Soft-Services/Leonhart/README.md

# Leonhart
## Overview
Leonhart is a custom embedded Linux board based on the Texas Instruments AM6231 SoC.

The board is a smart-home gateway capable of running Linux and hosting Thread and Zigbee networks simultaneously using the Silicon Labs MGM240P radio module. The goal is to provide support for Matter-over-Thread devices while also bridging Zigbee devices into modern Matter-based ecosystems such as Google Home, Amazon Alexa, and Apple Home.

## Why This Matters
Many existing smart homes rely on Zigbee devices, while newer smart-home ecosystems are increasingly moving towards Matter and Thread. Replacing Zigbee devices to keep up with Matter-based ecosystems is wasteful, expensive and unnecessary.

Leonhart was created to support both worlds at once. Hosting a Thread network for newer Matter-over-Thread devices, while also hosting a Zigbee network and allowing for communication with legacy Zigbee devices. The long-term goal is to bridge Zigbee devices into Matter-based ecosystems, allowing older devices to remain useful alongside newer smart-home standards.

## Project Goals

The main goals of Leonhart are:
- Build a fully functional custom embedded Linux system
- Run Zigbee+Thread RCP firmware on MGM240P
- Thread Border Router functionality
- Zigbee network stack to communicate with radio
- Support multi protocol through Silicon Labs CPC
- Create a compact, local and open Linux-based alternative to separate Zigbee hubs and Thread border routers

## Current Status

Rev B is currently functional. Working features include:
- Linux boot from eMMC
- Ethernet and SSH
- USB-C powered boot
- Multiprotocol firmware flashed to MGM240P
- UART communication between Linux host and MGM240P with hardware flow control
- Silicon Labs CPC daemon communication
- OpenThread Border Router operation
- Thread and Zigbee network formation
- Automatic startup of Zigbee, OTBR and CPC services
- Matter-over-Thread device control using chip-tool
- Zigbee device control through Matter chip-tool commands using a simple FIFO-based Matter bridge

### Current Demo

Leonhart currently demonstrates Matter-over-Thread control and early Zigbee-to-Matter bridge functionality using the onboard MGM240P radio.

<br>

<p align="center">
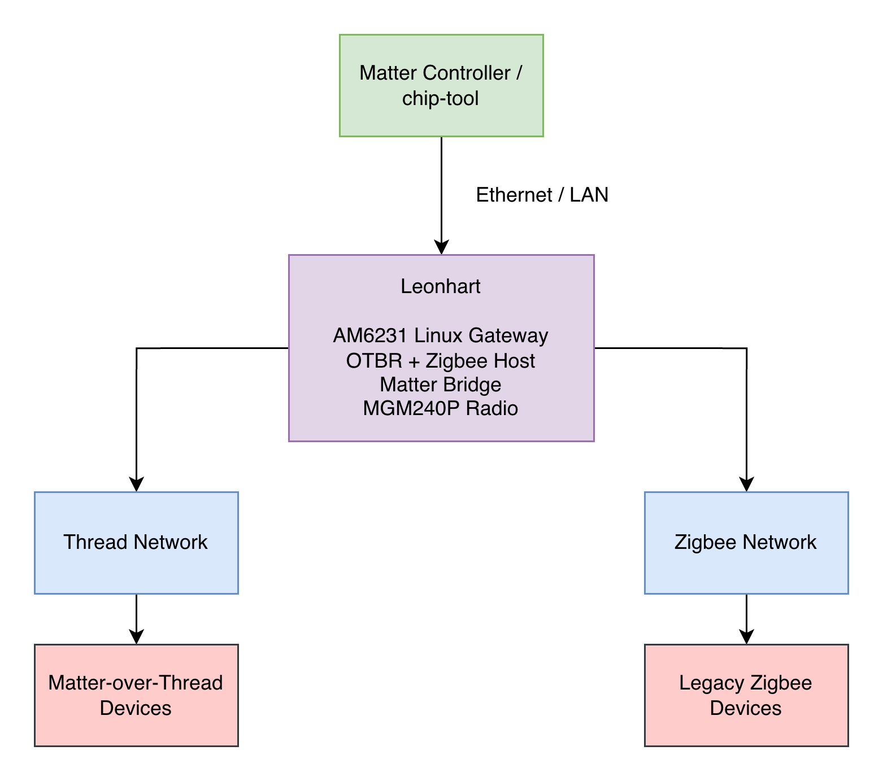
[picture p1: images/leonhartdemodrawing.drawio.png]
  
</p>

## Hardware Architecture

### Key Features
- TI AM6231 SoC
- 2 GB DDR4
- SiLabs MGM240P RF module
- 16 GB eMMC storage (HS200)
- Ethernet (RGMII PHY)
- 32kbit EEPROM
- USB-A host port
- USB-C power input
- SoC JTAG/MGM240P SWD TagConnect debug interfaces
- SPI and UART header pins for extra peripherals

### Hardware Block Diagram

<br>

<p align="center">
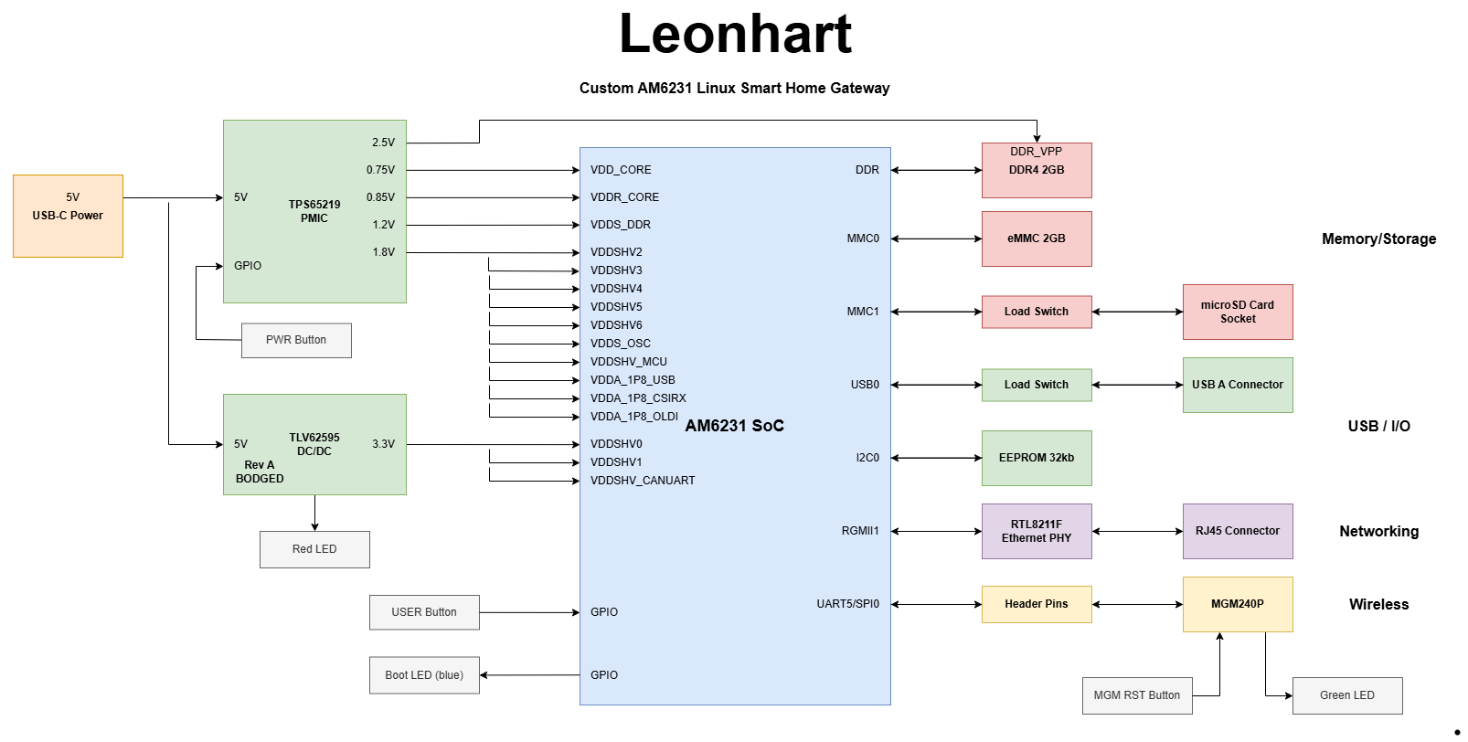
[picture p2: images/hardwareblockdiagram.drawio.png]
  
</p>

## Hardware Revisions

### Rev A
<p align="centre">
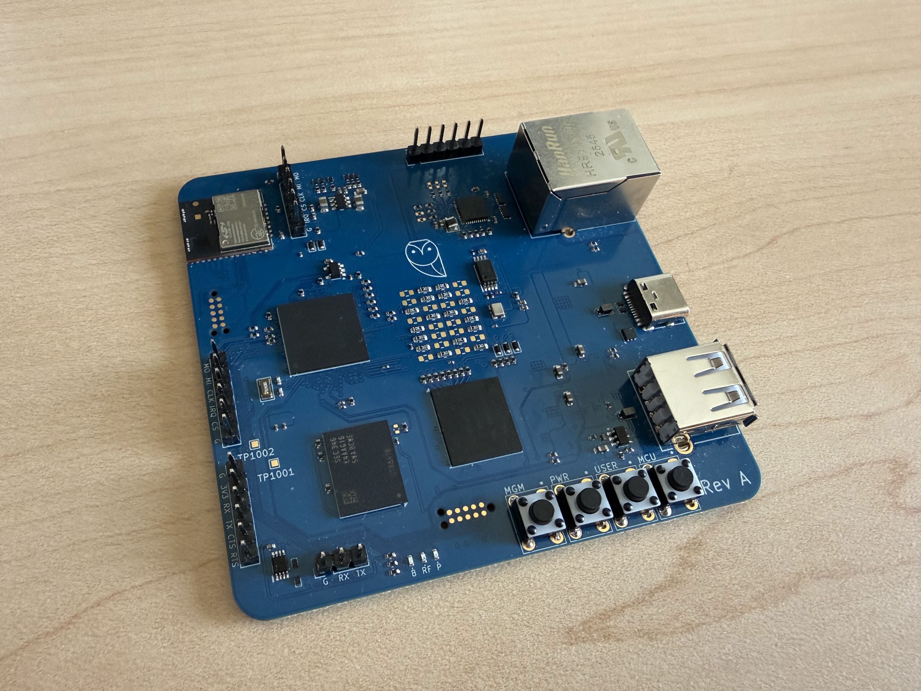
[picture p3: images/3d_top.jpg]
  
</p>

Rev A was the initial bring-up revision. It successfully validated the core AM6231 Linux system, including PMIC rail sequencing, U-Boot over UART, DDR4 initialization, eMMC HS200 operation, EEPROM communication, USB-A, clocks, and Linux boot.

Main issues found in Rev A:
- Incorrect 5 V to 3.3 V buck converter footprint, requiring external 3.3 V injection
- USB-C power issue caused by the bodged power setup
- Ethernet PHY not operational
- Linux boot on power-up affected by bodged power sequencing
- Incorrect MGM240P UART and SWD pinout

### Rev B
<p align="centre">
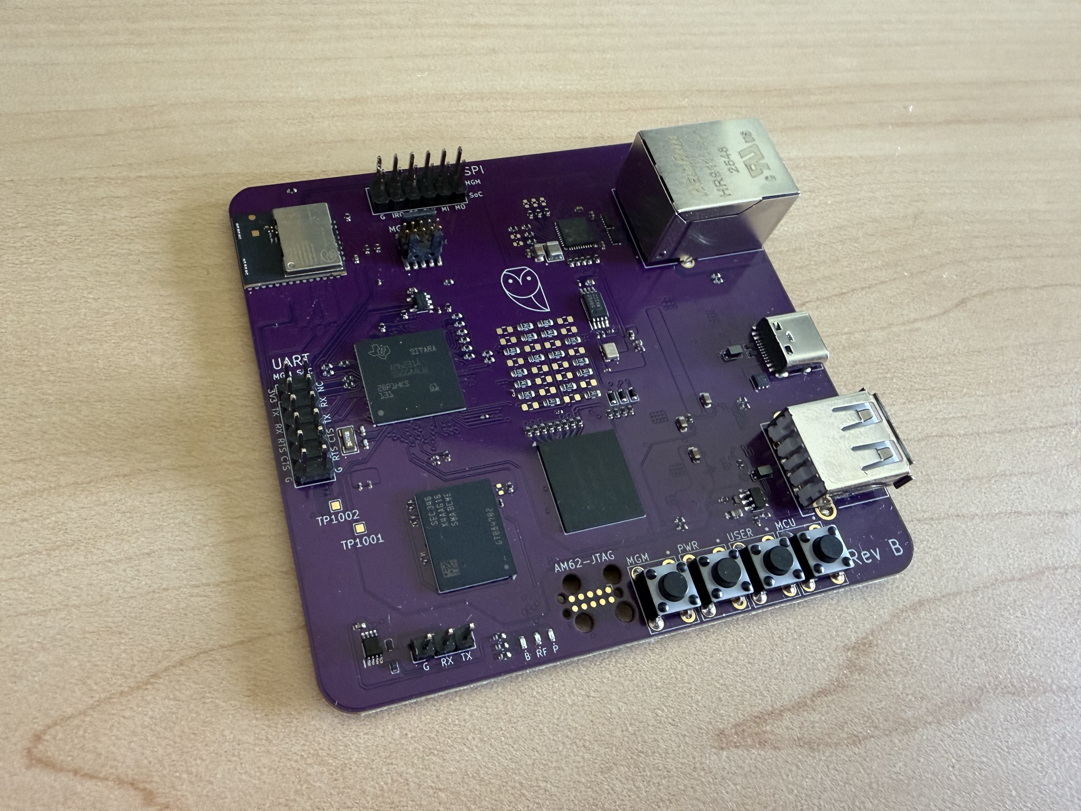
[picture p4: images/revb3d_top.jpg]
  
</p>

Rev B fixed the major hardware issues from Rev A and is the current functional revision.

Main fixes and validated features in Rev B:
- MGM240P pinout now correct and can be flashed to via Silicon Labs J-Link debugger
- Ethernet and SSH are now operational
- Correct 5V -> 3.3V buck converter footprint
- USB-C power works without bodged power supply
- Linux boots from power up
- UART communication with hardware flow control works between the AM6231 and MGM240P

## Bring-Up Notes

Progress Update #1 

During initial bring-up, a bench PSU was used and a large current draw was observed, which was then found out to be an issue with the 5V -> 3.3V buck converter footprint.

A temporary workaround involved:
- Injecting 3.3V from wall adapter into 3.3V header pin
- Using a USB-C breakout board to power the PMIC and remaining rails via a bench PSU

This allowed for successful validation of:
- SoC boot
- DDR initialization
- eMMC communication

Linux boot strategy: USB-A -> DDR -> eMMC -> DDR -> boot

Progress Update #2
- Successfully booted Linux (Arago distribution)
- Rootfs and U-Boot files copied to eMMC
- Successfully able to boot from eMMC

Progress Update #3
- Modified prebuilt ti-am625-sk.dts file with only UART pinmux (UART5) for my custom board, and build .dtb file from that, then copied it to eMMC
- Tested UART5 communication with Sparkfun Things Matter MGM240P and saw output on SOC UART terminal

Progress Update #4
- Had issue with USB C power showing incorrect voltage for 5V rail (2.2V), so I used the bench power supply for dummy power. I have found that the bodged 3.3V injection setup causes the 2.2V at the USB C VBUS pins, which prevents USB C from sending power. Without the bodged setup (correct 5V->3.3V buck converter footprint) in the next revision, USB C power should work as intended
- Created new Rev B branch and started revisions

Progress Update #5 (Rev B)
- Confirmed gigabit Ethernet works and SSH works
- Linux able to boot from power up
- Confirmed onboard MGM240P communication and flashing works
- Confirmed UART hardware flow with MGM240P works
- Need to fix NCP and RCP firmware communication with CPC daemon

Progress Update #6 (Rev B)
- Successfully flashed Multiprotocol RCP/NCP (Thread and Zigbee) stack to MGM240P and had successful communication with host CPCD
- Successfully proved full Thread network chain (RCP(MGM) <-> (CPCD <-> OTBR)(AM6231)). Needed to rebuild TI Arago Linux image with multicast routing enabled

Progress Update #7 (Rev B)
- Made all Zigbee (zigbeed, zigbee-pty-bridge, Z3Gateway), Thread (OTBR, otbr-agent) and CPCD run on reboot, and successfully confirmed services correctly restart and devices reconnect
- Successfully proved Matter-over-Thread control with ESP32C6 running a Matter light example

The ESP32 commissions onto the Thread network through Leonhart, then registers its Matter operational service through SRP, then can be controlled from chip-tool over the LAN

Next steps
- Order more Zigbee and Matter-over-Thread and stress test the multiprotocol networking
- Begin to start/look into Zigbee -> Matter bridging

The following screenshots shows a script that displays the status' of the Zigbee and Thread networks and services:

<p align="centre">
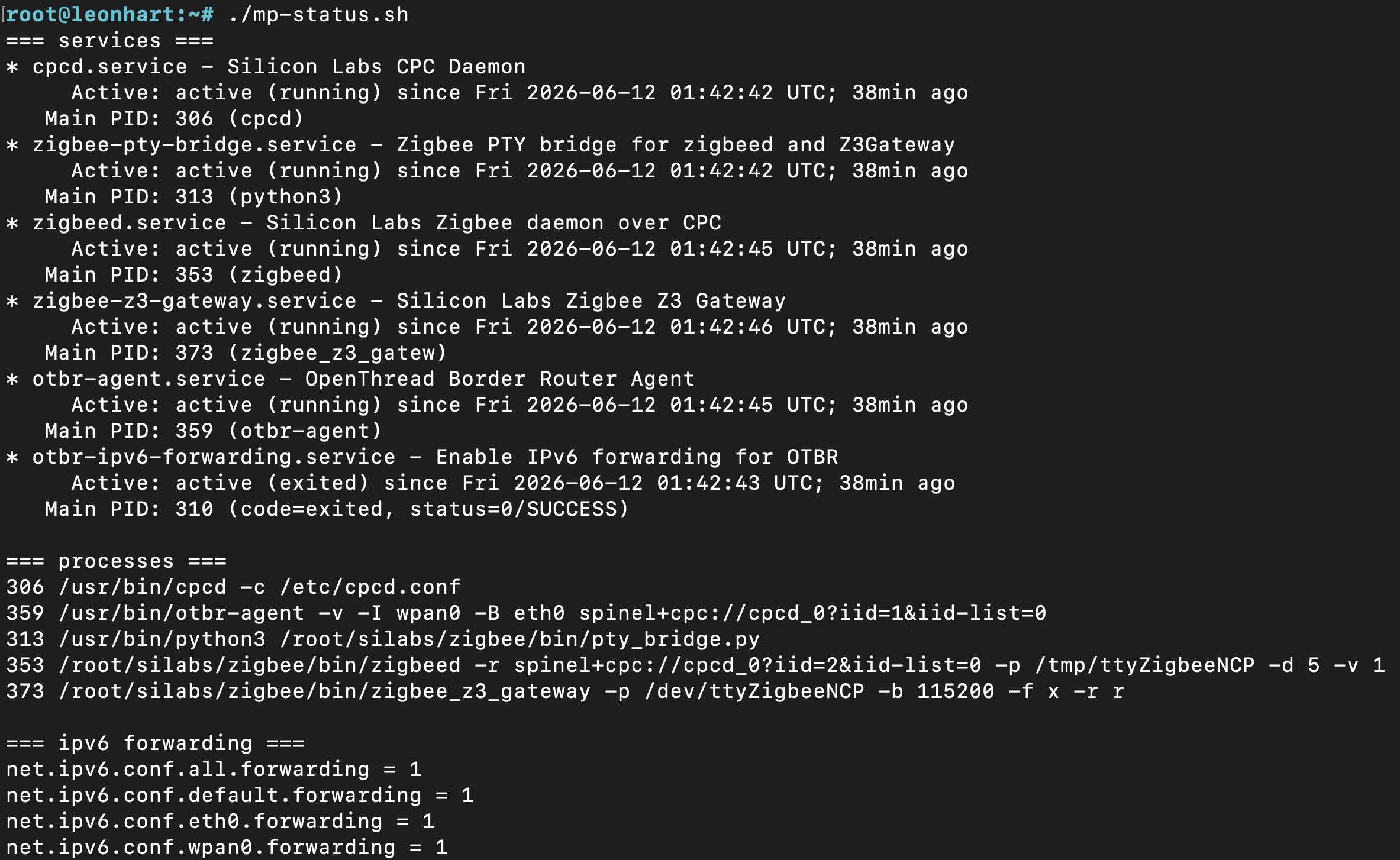
[picture p5: images/mp-statusA.png]
  
</p>
<p align="centre">
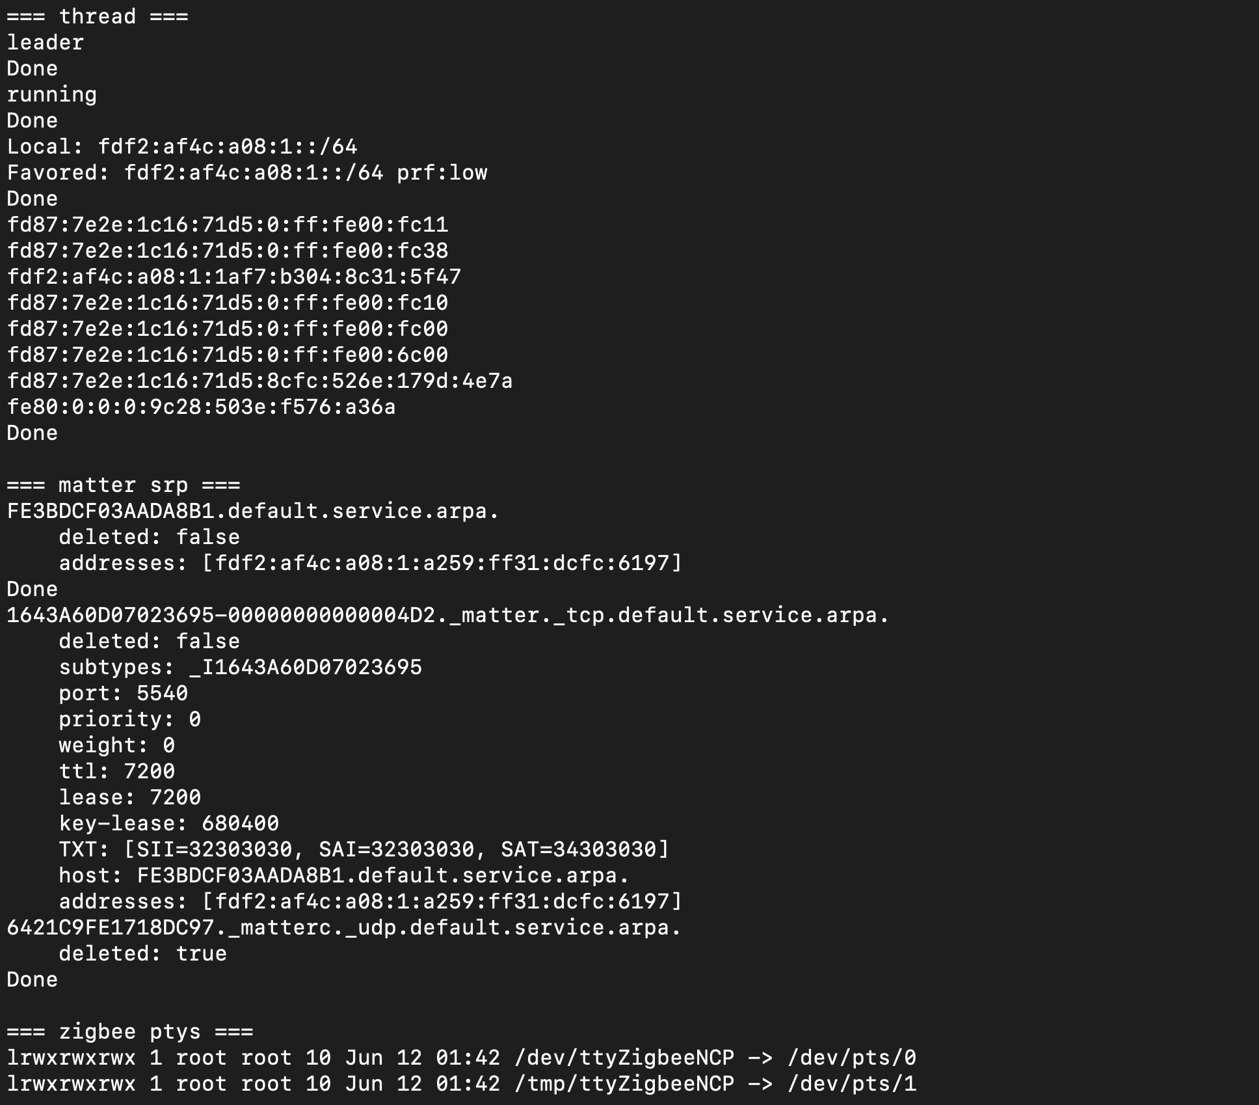
[picture p6: images/mp-statusB.png]
  
</p>

## Hardware Photos
<p align="centre">
  
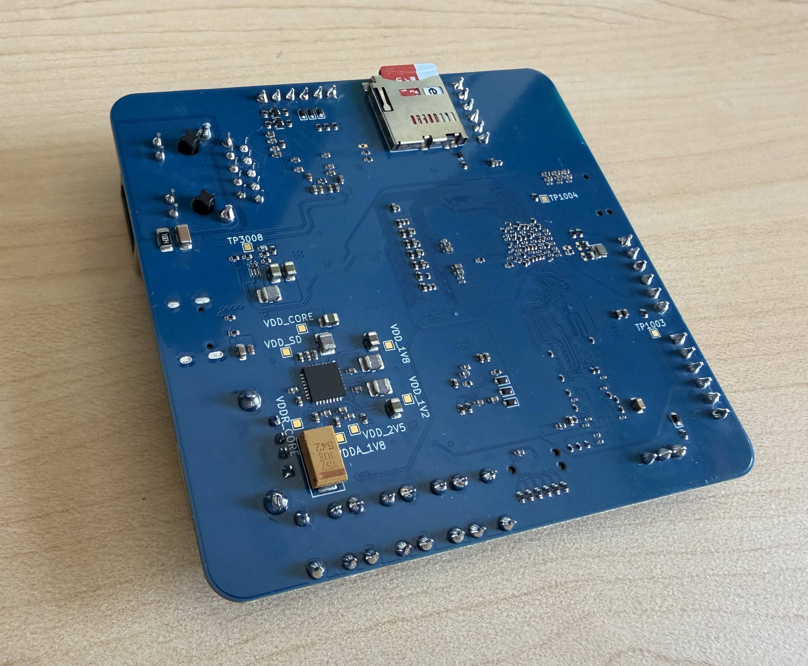
[picture p7: images/3d_bottom.jpg]
  
</p>
<p align="centre">
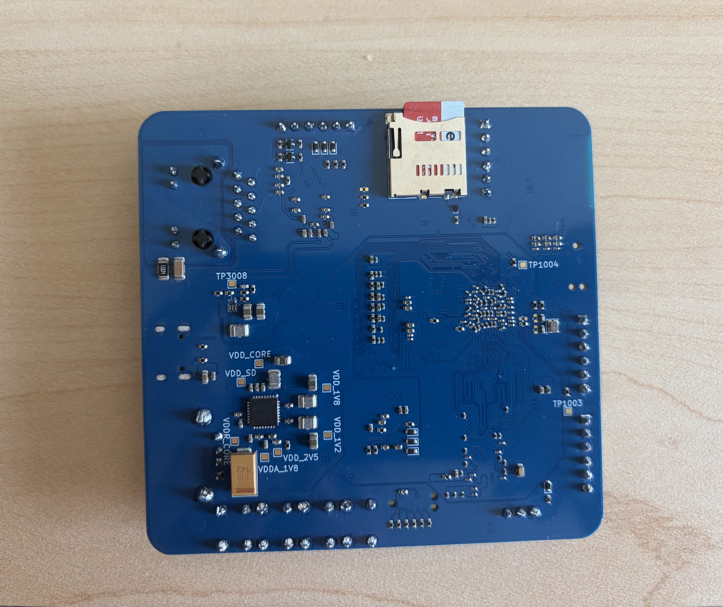
[picture p8: images/bottom.jpg]
  
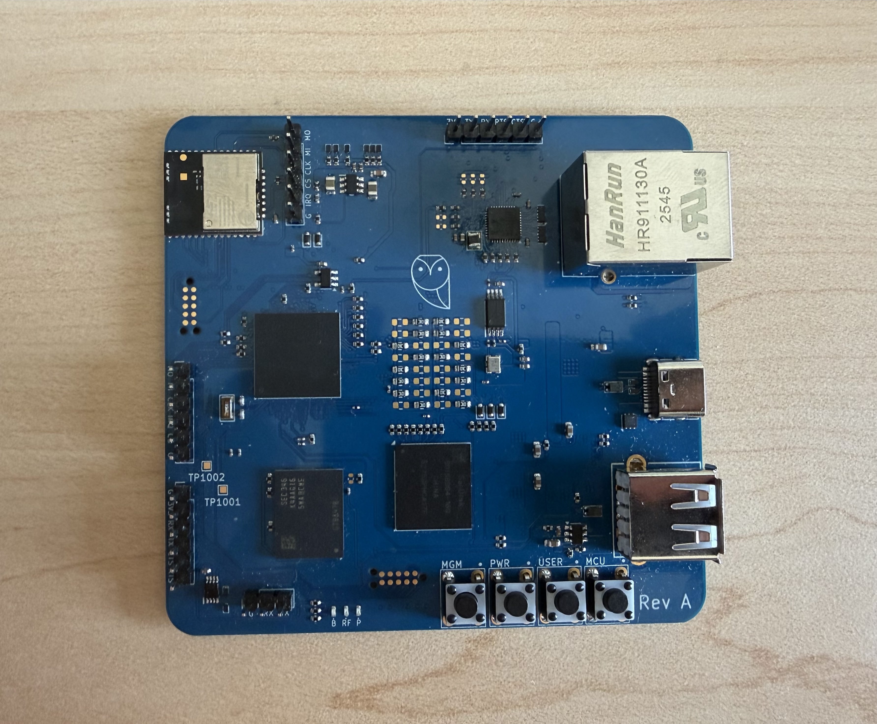
[picture p9: images/top.jpg]
  
</p>
