Soft-Services/Leonhart/images/RevALinuxProgress1.png

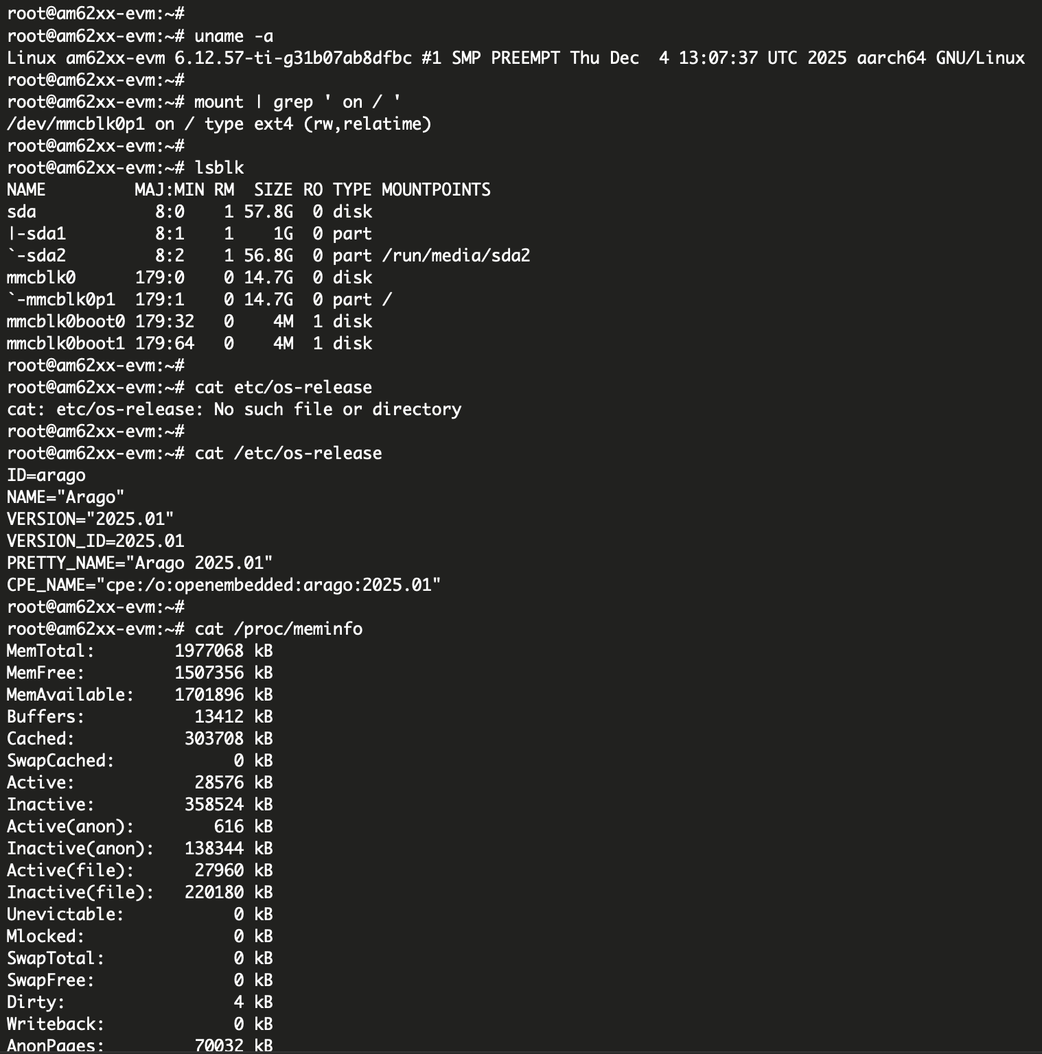
images/RevALinuxProgress1.png
