Soft-Services/Leonhart/Components/CMUSB661022B/CMUSB661022B.jpg

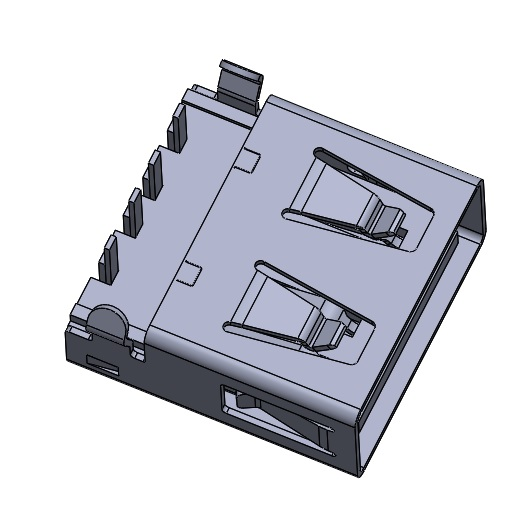
Components/CMUSB661022B/CMUSB661022B.jpg
