Soft-Services/Leonhart/Components/CMUSB661022B/CMUSB661022B.stp

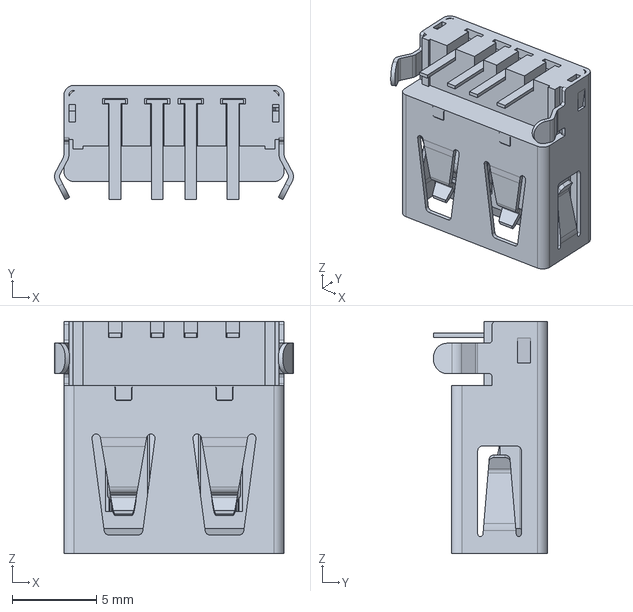
[picture p12: CAD file, 2025-09-30]
Components/CMUSB661022B/CMUSB661022B.stp
14.2 x 6.80 x 13.8 mm
