Soft-Services/Leonhart/Components/Download_STP_63011002124501 (rev1).stp

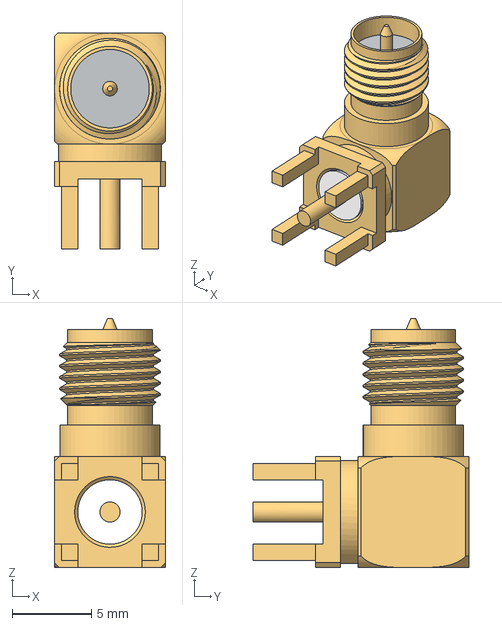
[picture p13: CAD file, 2025-08-28]
Components/Download_STP_63011002124501 (rev1).stp
7.00 x 13.6 x 15.7 mm
