Soft-Services/Leonhart/Components/K4AAG165WA-BCWE/3D/K4AAG165WA-BCWE.stp

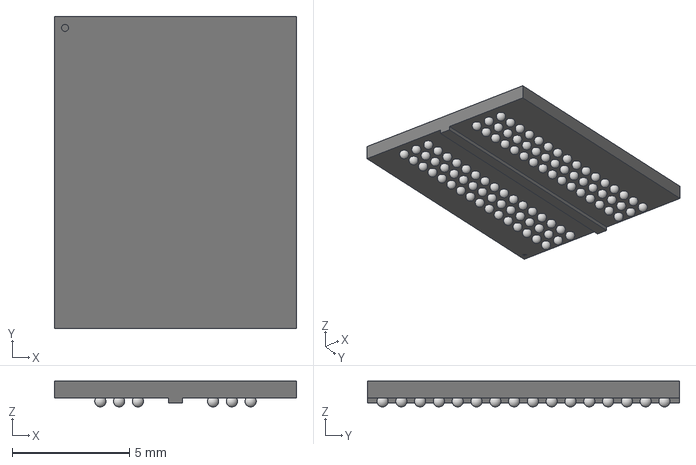
[picture p14: CAD file, 2025-08-04]
Components/K4AAG165WA-BCWE/3D/K4AAG165WA-BCWE.stp
10.3 x 13.3 x 1.10 mm
