Soft-Services/Leonhart/Components/LIB_902-131A1011D10100/902-131A1011D10100/3D/902-131A1011D10100.stp

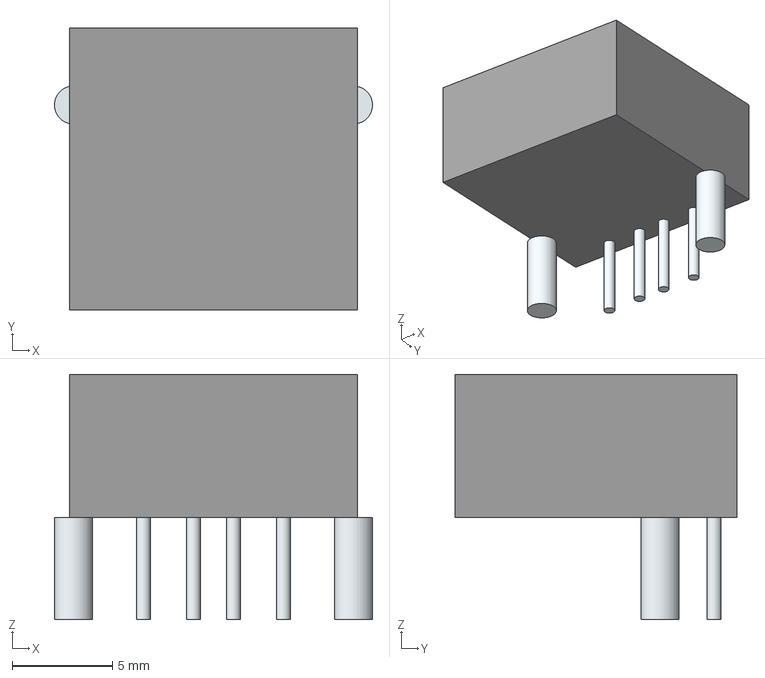
[picture p15: CAD file, 2025-09-30]
Components/LIB_902-131A1011D10100/902-131A1011D10100/3D/902-131A1011D10100.stp
15.9 x 14.1 x 12.2 mm
Leads
