Soft-Services/Leonhart/Components/LIB_ABS07-32.768KHZ-9-T/ABS07-32.768KHZ-9-T/3D/ABS07-32.768KHZ-9-T.stp

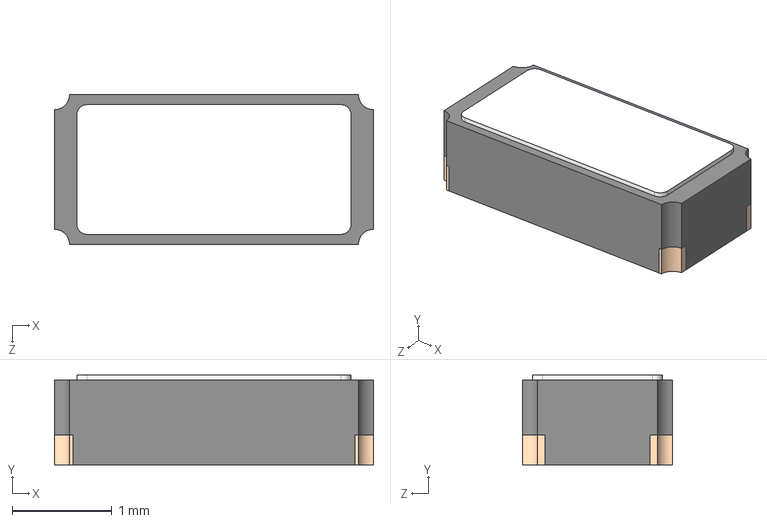
[picture p16: CAD file, 2025-08-28]
Components/LIB_ABS07-32.768KHZ-9-T/ABS07-32.768KHZ-9-T/3D/ABS07-32.768KHZ-9-T.stp
3.20 x 0.9 x 1.50 mm
