Soft-Services/Leonhart/Components/LIB_AM6231ASGGGAALW/AM6231ASGGGAALW/3D/AM6231ASGGGAALW.stp

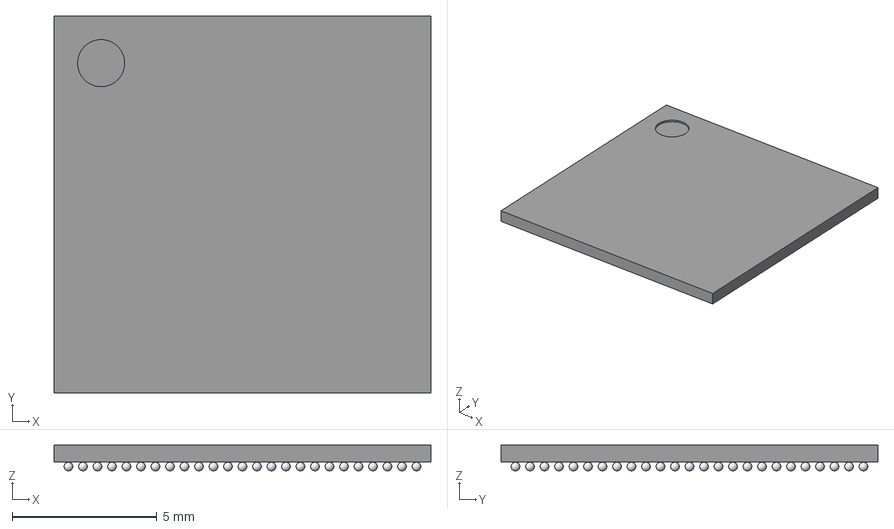
[picture p17: CAD file, 2025-08-04]
Components/LIB_AM6231ASGGGAALW/AM6231ASGGGAALW/3D/AM6231ASGGGAALW.stp
13.0 x 13.0 x 0.89 mm
A1
A2
A3
A4
A5
A6
A7
A8
A9
A10
A11
A12
A13
A14
A15
A16
A17
A18
A19
A20
A21
A22
A23
A24
A25
B1
B2
B3
B4
B5
B6
B7
B8
B9
B10
B11
B12
B13
B14
B15
B16
B17
B18
B19
B20
B21
B22
B23
B24
B25
C1
C2
C5
C6
C9
C11
C13
C15
C17
C20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
