Soft-Services/Leonhart/Components/LIB_CC2652P1FRGZR/CC2652P1FRGZR/3D/CC2652P1FRGZR.stp

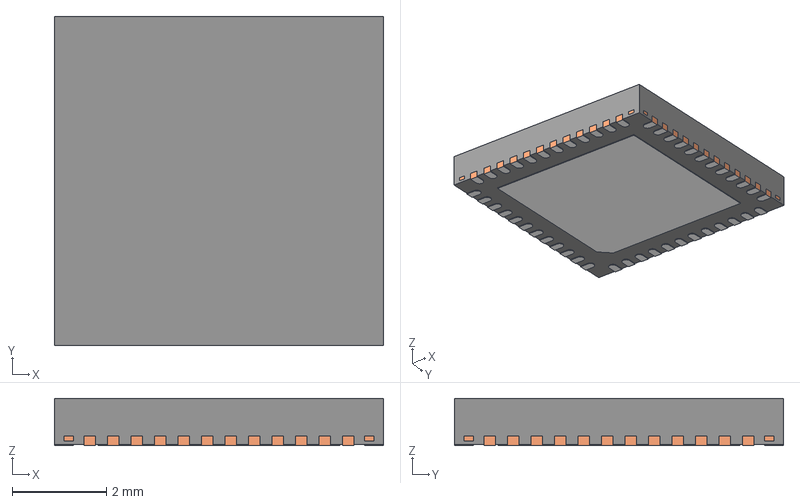
[picture p18: CAD file, 2025-08-04]
Components/LIB_CC2652P1FRGZR/CC2652P1FRGZR/3D/CC2652P1FRGZR.stp
7.00 x 7.00 x 1.00 mm
BODY-QFN
FRAME-RGZ0048A
PIN1-ID
