Soft-Services/Leonhart/Components/LIB_DMG1012T/DMG1012T/3D/DMG1012T.stp

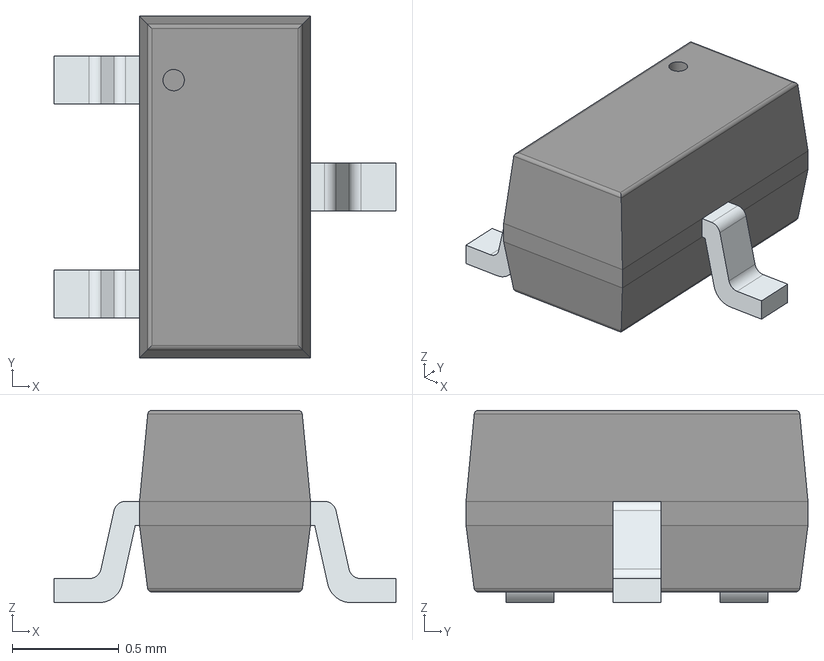
[picture p19: CAD file, 2025-08-27]
Components/LIB_DMG1012T/DMG1012T/3D/DMG1012T.stp
1.60 x 1.60 x 0.9 mm
PinsArrayL
FilletPinR
