Soft-Services/Leonhart/Components/LIB_ECS-2520MV-250-BN-TR/ECS-2520MV-250-BN-TR/3D/ECS-2520MV-250-BN-TR.stp

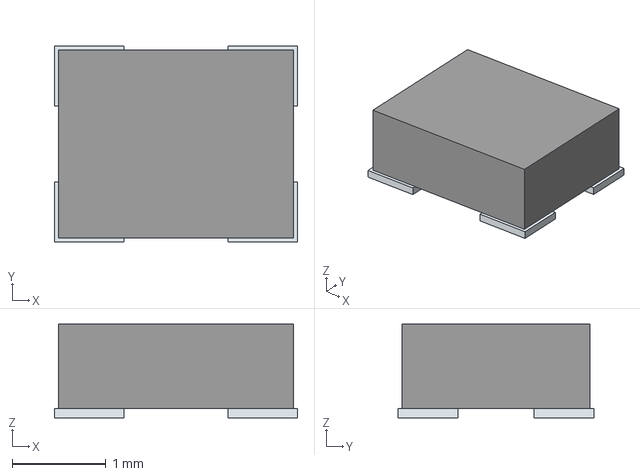
[picture p20: CAD file, 2025-08-27]
Components/LIB_ECS-2520MV-250-BN-TR/ECS-2520MV-250-BN-TR/3D/ECS-2520MV-250-BN-TR.stp
2.59 x 2.09 x 1.00 mm
Pins
