Soft-Services/Leonhart/Components/LIB_FC-135R_32.7680KA-A3/FC-135R_32.7680KA-A3/3D/FC-135R_32.7680KA-A3.stp

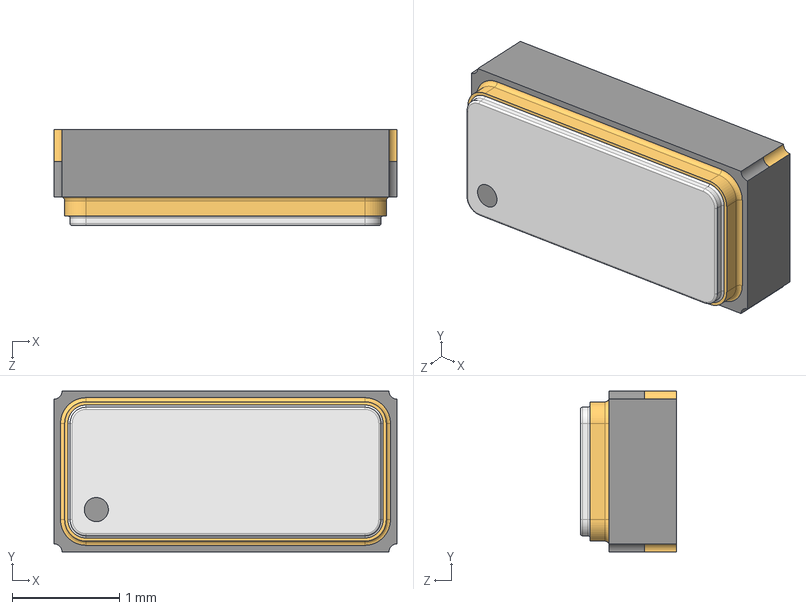
[picture p22: CAD file, 2025-08-28]
Components/LIB_FC-135R_32.7680KA-A3/FC-135R_32.7680KA-A3/3D/FC-135R_32.7680KA-A3.stp
3.20 x 1.50 x 0.9 mm
