Soft-Services/Leonhart/Components/LIB_FTSH-105-01-L-DV-K/FTSH-105-01-L-DV-K/3D/FTSH-105-01-L-DV-K.stp

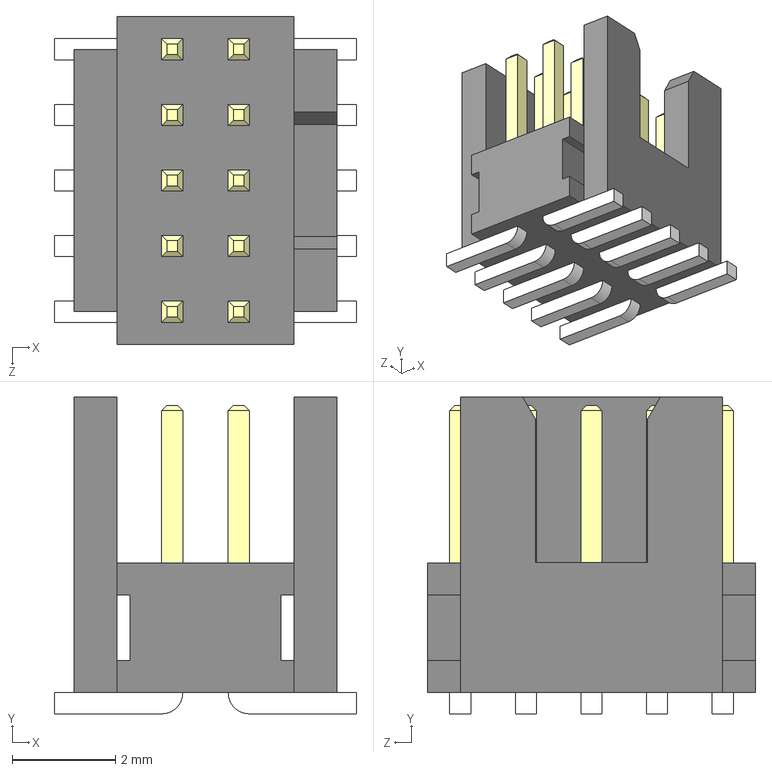
[picture p23: CAD file, 2026-05-05]
Components/LIB_FTSH-105-01-L-DV-K/FTSH-105-01-L-DV-K/3D/FTSH-105-01-L-DV-K.stp
5.85 x 6.13 x 6.35 mm
