Soft-Services/Leonhart/Components/LIB_LMK1C1102PWR/LMK1C1102PWR/3D/LMK1C1102PWR.stp

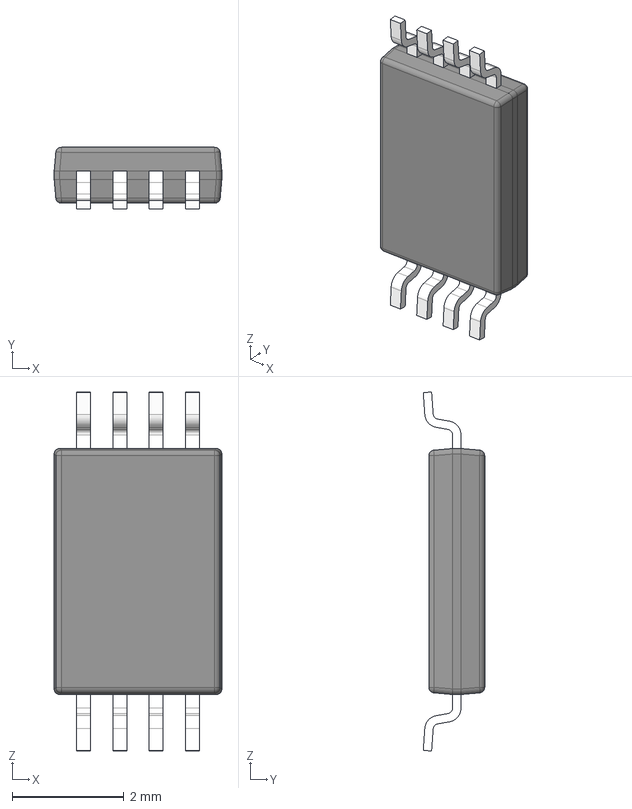
[picture p24: CAD file, 2025-09-29]
Components/LIB_LMK1C1102PWR/LMK1C1102PWR/3D/LMK1C1102PWR.stp
3.00 x 1.10 x 6.42 mm
BODY-SO
LEAD-SO x 8
PIN1-ID
