Soft-Services/Leonhart/Components/LIB_MEM2052-00-195-00-A/MEM2052-00-195-00-A/3D/MEM2052-00-195-00-A.stp

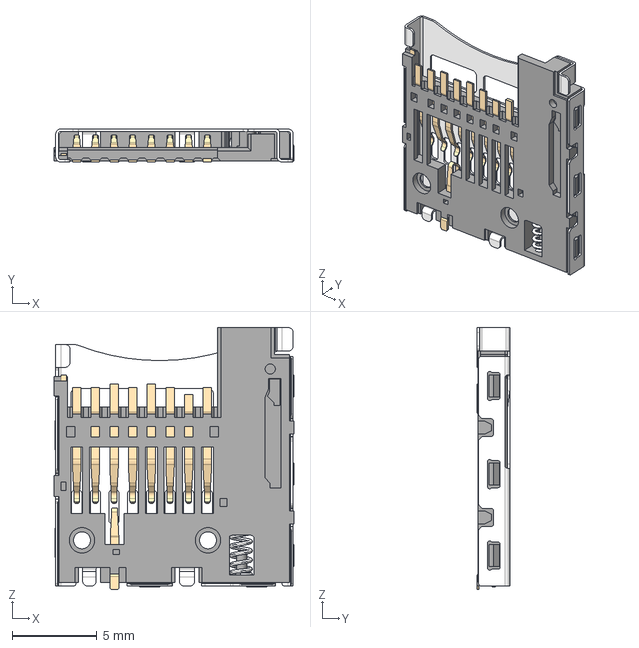
[picture p25: CAD file, 2026-02-27]
Components/LIB_MEM2052-00-195-00-A/MEM2052-00-195-00-A/3D/MEM2052-00-195-00-A.stp
14.2 x 1.95 x 15.4 mm
