Soft-Services/Leonhart/Components/LIB_MGM240PB32VNA3/MGM240PB32VNA3/3D/MGM240PB32VNA3.stp

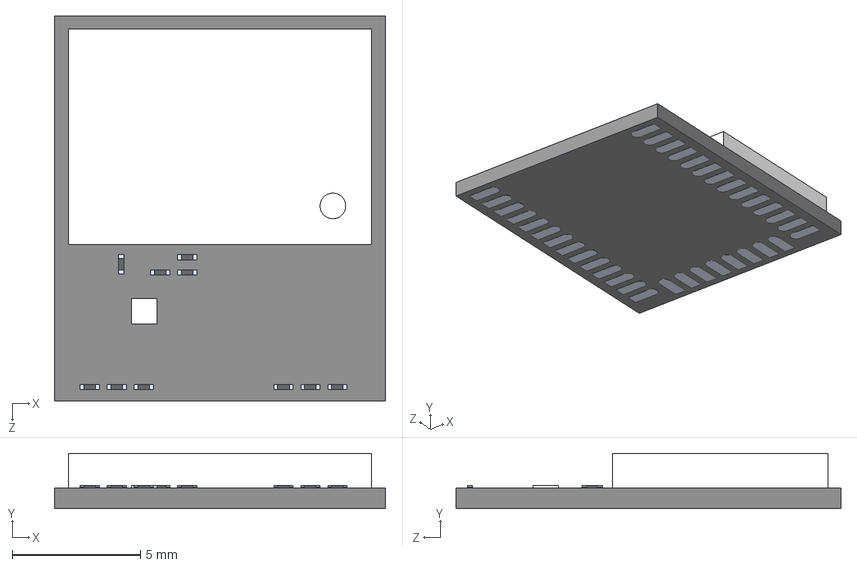
[picture p26: CAD file, 2025-10-09]
Components/LIB_MGM240PB32VNA3/MGM240PB32VNA3/3D/MGM240PB32VNA3.stp
12.9 x 2.15 x 15.0 mm
