Soft-Services/Leonhart/Components/LIB_SKYA21003/SKYA21003/3D/SKYA21003.stp

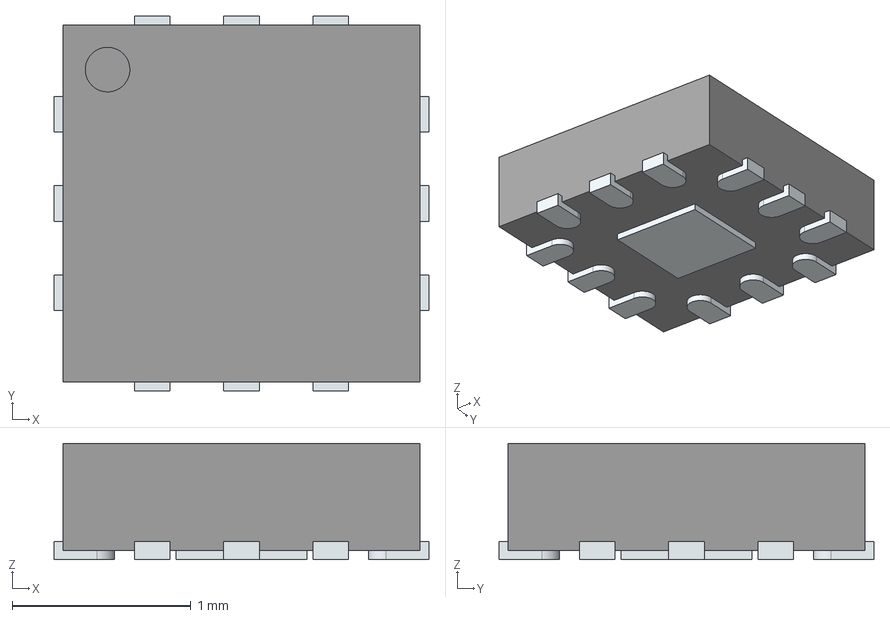
[picture p29: CAD file, 2025-10-01]
Components/LIB_SKYA21003/SKYA21003/3D/SKYA21003.stp
2.10 x 2.10 x 0.65 mm
ThermalPin
PinsArrayLR
PinsArrayTB
