Soft-Services/Leonhart/Components/LIB_SN74LVC2G241DCUR/SN74LVC2G241DCUR/3D/SN74LVC2G241DCUR.stp

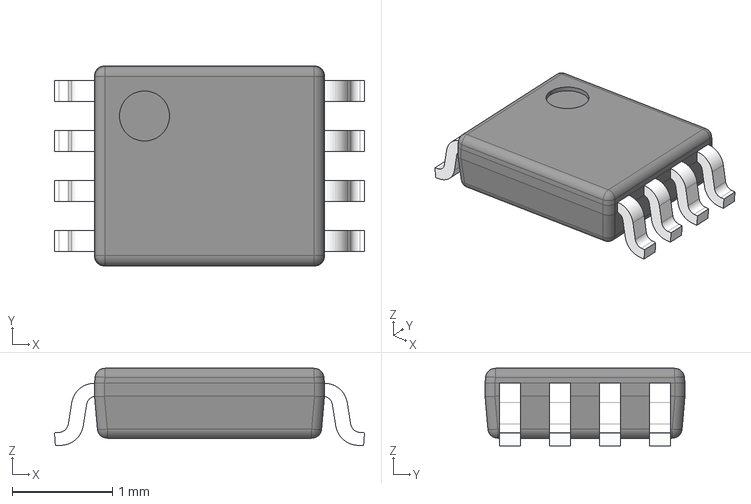
[picture p30: CAD file, 2025-08-27]
Components/LIB_SN74LVC2G241DCUR/SN74LVC2G241DCUR/3D/SN74LVC2G241DCUR.stp
3.10 x 2.00 x 0.775 mm
BODY-VSSOP
LEAD-VSSOP x 8
