Soft-Services/Leonhart/Components/LIB_SRF2012-900YA/SRF2012-900YA/3D/SRF2012-900YA.stp

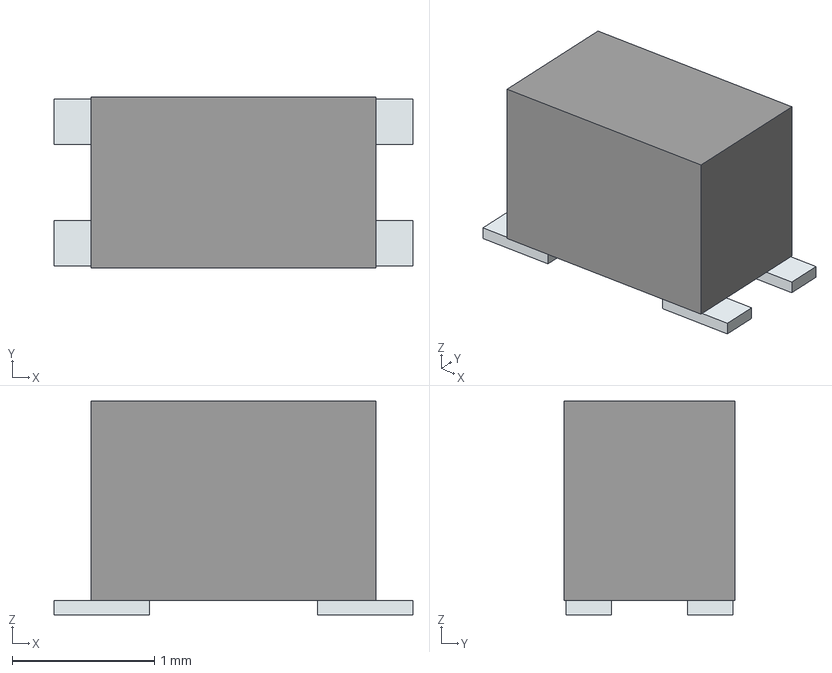
[picture p31: CAD file, 2025-08-27]
Components/LIB_SRF2012-900YA/SRF2012-900YA/3D/SRF2012-900YA.stp
2.52 x 1.20 x 1.50 mm
Pins
