Soft-Services/Leonhart/Components/LIB_TM4C1294KCPDTI3/TM4C1294KCPDTI3/3D/TM4C1294KCPDTI3.stp

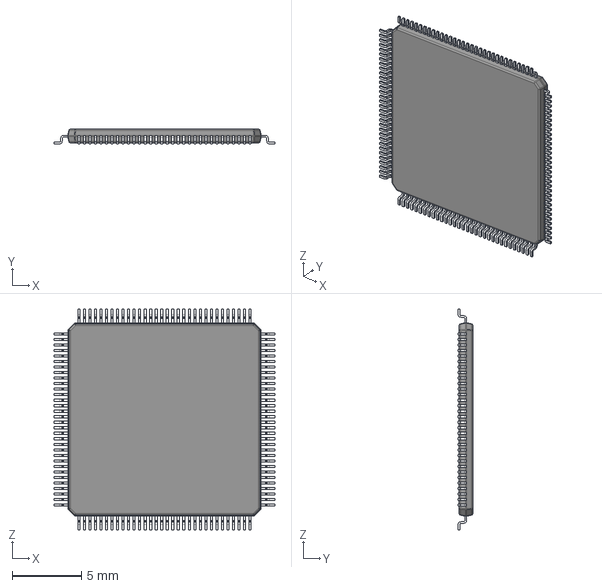
[picture p32: CAD file, 2025-08-04]
Components/LIB_TM4C1294KCPDTI3/TM4C1294KCPDTI3/3D/TM4C1294KCPDTI3.stp
16.0 x 1.07 x 16.0 mm
BODY_VJX128A
LEAD_VJX128A x 128
