Soft-Services/Leonhart/Components/LIB_TPD1E1B04DPYR/TPD1E1B04DPYR/3D/TPD1E1B04DPYR.stp

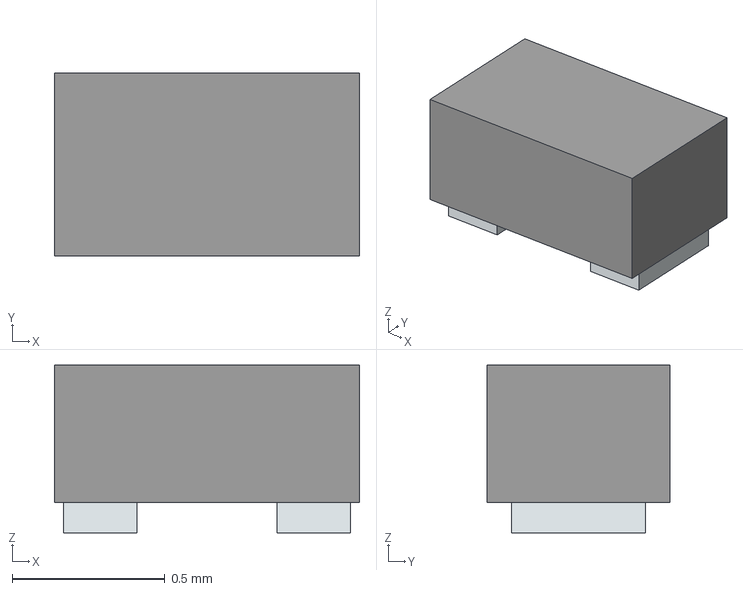
[picture p33: CAD file, 2025-10-08]
Components/LIB_TPD1E1B04DPYR/TPD1E1B04DPYR/3D/TPD1E1B04DPYR.stp
1.00 x 0.6 x 0.55 mm
Pins
