Soft-Services/Leonhart/Components/LIB_TPD3S014DBVR/TPD3S014DBVR/3D/TPD3S014DBVR.stp

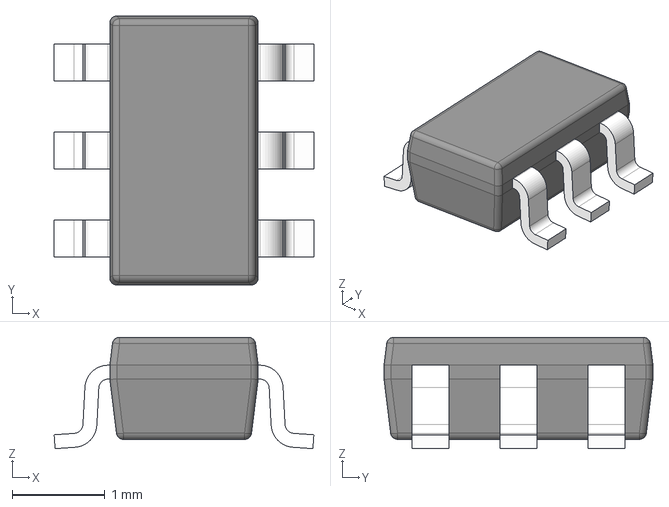
[picture p34: CAD file, 2025-08-27]
Components/LIB_TPD3S014DBVR/TPD3S014DBVR/3D/TPD3S014DBVR.stp
2.80 x 2.90 x 1.20 mm
BODY-SOT
LEAD-SOT x 6
