Soft-Services/Leonhart/Components/LIB_TVS0500DRVR/TVS0500DRVR/3D/TVS0500DRVR.stp

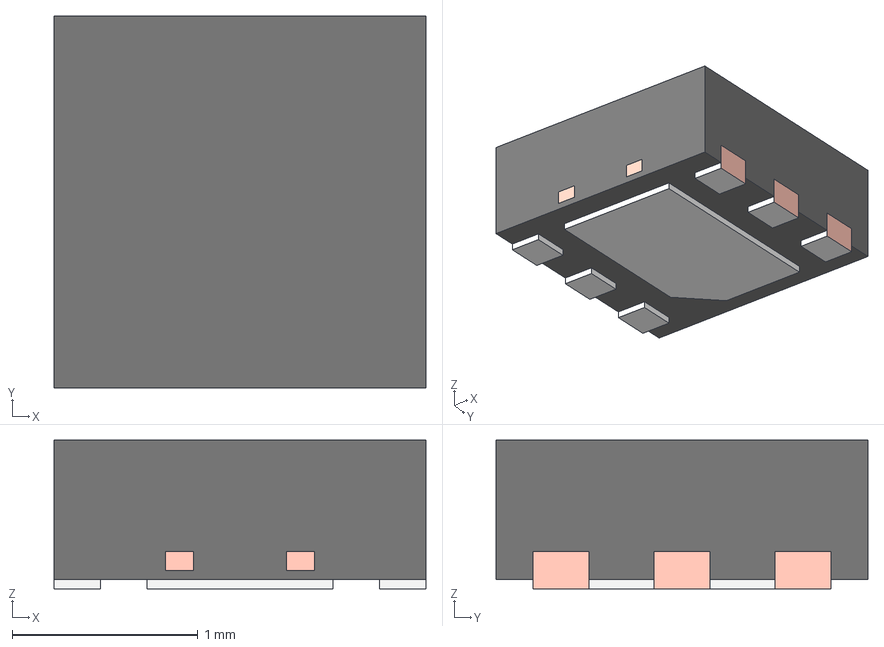
[picture p35: CAD file, 2025-08-27]
Components/LIB_TVS0500DRVR/TVS0500DRVR/3D/TVS0500DRVR.stp
2.00 x 2.00 x 0.8 mm
BODY-SON
FRAME-DRV0006B
PIN1-ID
