Soft-Services/Leonhart/Components/LIB_XRCGB25M000F3M00R0/XRCGB25M000F3M00R0/3D/XRCGB25M000F3M00R0.stp

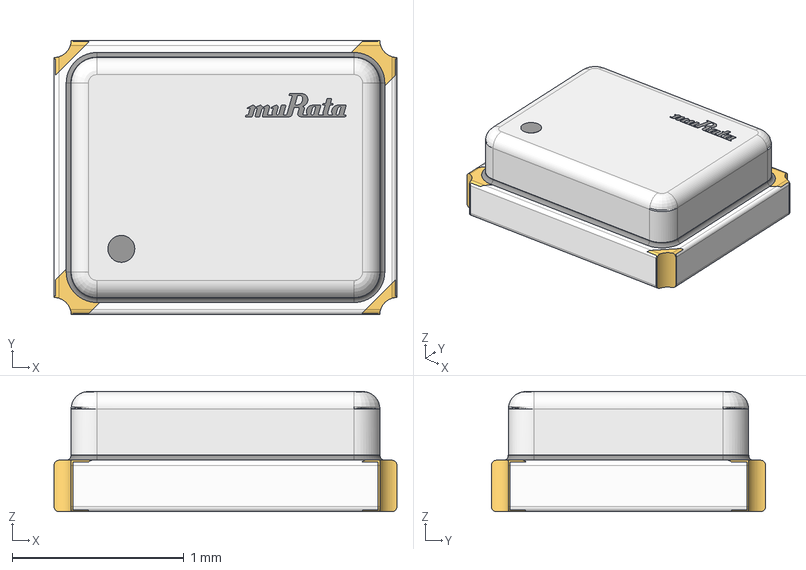
[picture p36: CAD file, 2025-08-28]
Components/LIB_XRCGB25M000F3M00R0/XRCGB25M000F3M00R0/3D/XRCGB25M000F3M00R0.stp
2.00 x 1.60 x 0.702 mm
