Soft-Services/Leonhart/Components/LIB_XRCGB32M000F1H01R0/XRCGB32M000F1H01R0/3D/XRCGB32M000F1H01R0.stp

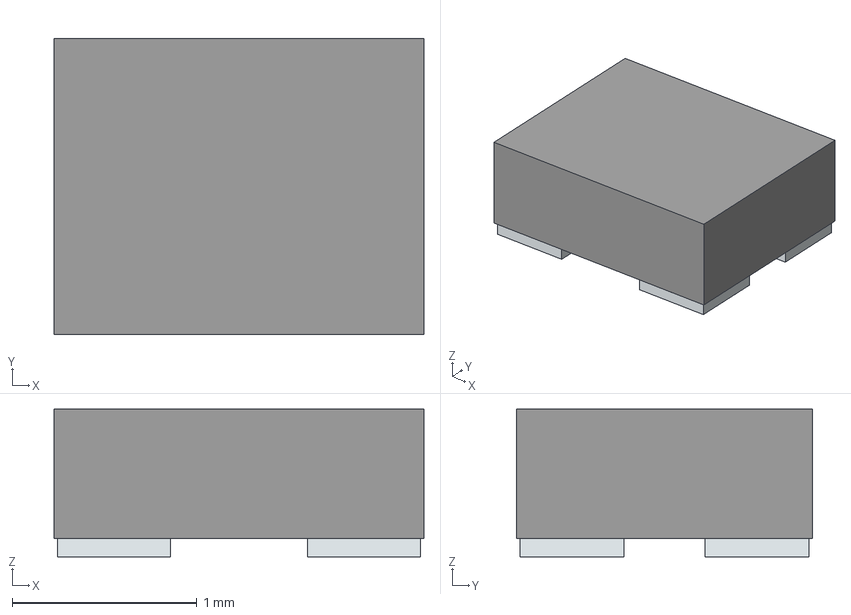
[picture p37: CAD file, 2025-08-28]
Components/LIB_XRCGB32M000F1H01R0/XRCGB32M000F1H01R0/3D/XRCGB32M000F1H01R0.stp
2.00 x 1.60 x 0.8 mm
Pins
