Soft-Services/Leonhart/Components/RTL8211FD-CG/3D/RTL8211FD-CG.stp

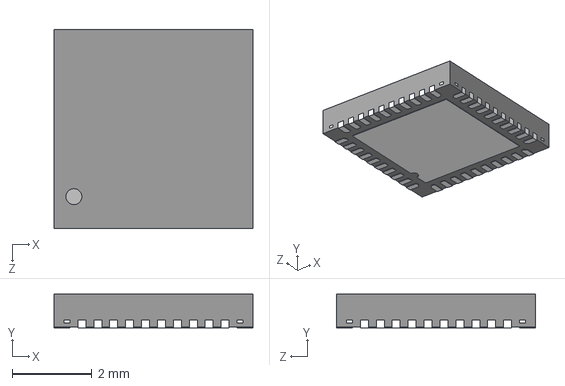
[picture p38: CAD file, 2025-08-04]
Components/RTL8211FD-CG/3D/RTL8211FD-CG.stp
5.00 x 0.85 x 5.00 mm
