Soft-Services/Leonhart/Components/ul_1825910-6/c-1825910-6-c-3d.stp

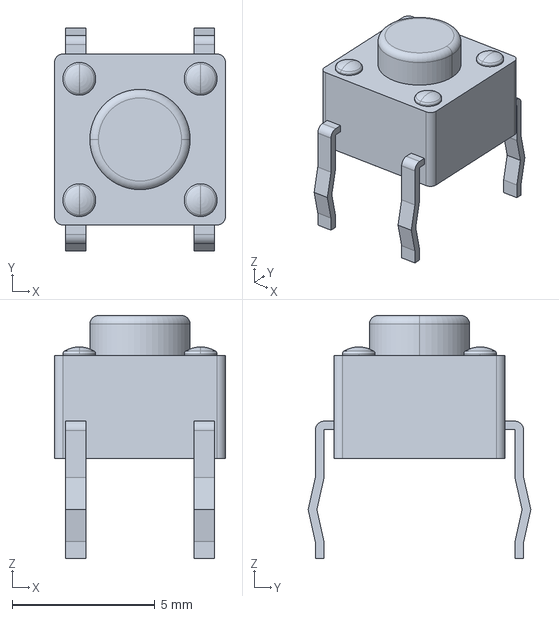
[picture p39: CAD file, 2025-10-30]
Components/ul_1825910-6/c-1825910-6-c-3d.stp
5.99 x 7.80 x 8.51 mm
