Soft-Services/Leonhart/Components/ul_EMMC16G-TB29-PZ90/FBGA153_13X11_5X0_8_KNT.step

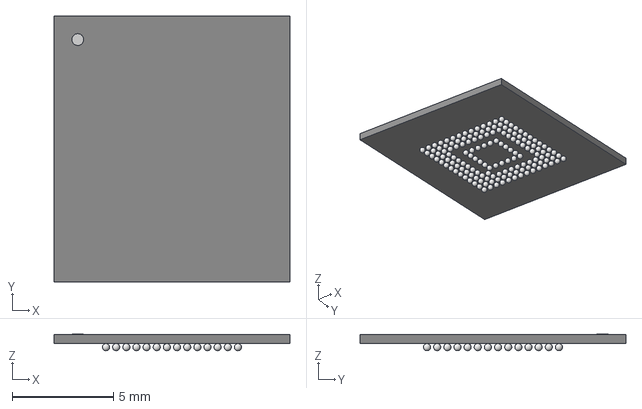
[picture p40: CAD file, 2025-08-27]
Components/ul_EMMC16G-TB29-PZ90/FBGA153_13X11_5X0_8_KNT.step
11.6 x 13.1 x 0.815 mm
