Soft-Services/Leonhart/Components/HRO_TYPE-C-31-M-12.step

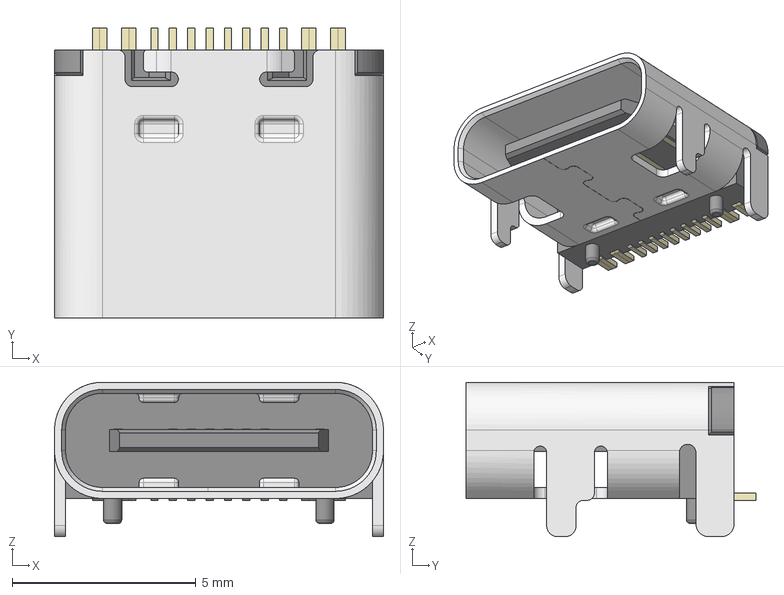
[picture p41: CAD file, 2025-08-27]
Components/HRO_TYPE-C-31-M-12.step
8.95 x 7.90 x 4.20 mm
