Soft-Services/Leonhart/(list of files, cad)

Other CAD files:
Components/LIB_AM6254ATCGHAALW/AM6254ATCGHAALW/3D/AM6254ATCGHAALW.stp
Components/LIB_ECS-2520MV-250-CN-TR/ECS-2520MV-250-CN-TR/3D/ECS-2520MV-250-CN-TR.stp
Components/CVH201610A-2R2M/3D/CVH201610A-2R2M.stp
Components/LIB_1825910-6/1825910-6/Allegro/18259106.psm
Components/LIB_1825910-6/1825910-6/DEHDL/1825910_6/chips/chips.prt
Components/LIB_48037-0001/48037-0001/3D/48037-0001.stp
Components/LIB_48037-0001/48037-0001/Allegro/480370001.psm
Components/LIB_48037-0001/48037-0001/DEHDL/48037_0001/chips/chips.prt
Components/LIB_902-131A1011D10100/902-131A1011D10100/Allegro/902131a1011d10100.psm
Components/LIB_902-131A1011D10100/902-131A1011D10100/DEHDL/902_131a1011d10100/chips/chips.prt
Components/LIB_ABS07-32.768KHZ-9-T/ABS07-32.768KHZ-9-T/Allegro/abs07.psm
Components/LIB_ABS07-32.768KHZ-9-T/ABS07-32.768KHZ-9-T/DEHDL/abs07_32.768khz_9_t/chips/chips.prt
Components/LIB_AM6231ASGGGAALW/AM6231ASGGGAALW/Allegro/bga425c50p25x25_1300x1300x89.psm
Components/LIB_AM6231ASGGGAALW/AM6231ASGGGAALW/DEHDL/am6231asgggaalw/chips/chips.prt
Components/LIB_AM6254ATCGHAALW/AM6254ATCGHAALW/Allegro/bga425c50p25x25_1300x1300x89.psm
Components/LIB_AM6254ATCGHAALW/AM6254ATCGHAALW/DEHDL/am6254atcghaalw/chips/chips.prt
Components/LIB_CC2652P1FRGZR/CC2652P1FRGZR/Allegro/qfn50p700x700x100-49n-d.psm
Components/LIB_CC2652P1FRGZR/CC2652P1FRGZR/DEHDL/cc2652p1frgzr/chips/chips.prt
Components/LIB_CC2652PSIP/CC2652PSIP/Allegro/cc2652psip.psm
Components/LIB_CC2652PSIP/CC2652PSIP/DEHDL/cc2652psip/chips/chips.prt
Components/LIB_DFE252012P-2R2M=P2/DFE252012P-2R2M=P2/3D/DFE252012P-2R2M=P2.stp
Components/LIB_DFE252012P-2R2M=P2/DFE252012P-2R2M=P2/DEHDL/dfe252012p_2r2m=p2/chips/chips.prt
Components/LIB_DMG1012T/DMG1012T/Allegro/sot50p160x90-3n.psm
Components/LIB_DMG1012T/DMG1012T/DEHDL/dmg1012t/chips/chips.prt
Components/LIB_ECS-2520MV-250-BN-TR/ECS-2520MV-250-BN-TR/Allegro/ecs2520mv250bntr.psm
Components/LIB_ECS-2520MV-250-BN-TR/ECS-2520MV-250-BN-TR/DEHDL/ecs_2520mv_250_bn_tr/chips/chips.prt
Components/LIB_ECS-2520MV-250-CN-TR/ECS-2520MV-250-CN-TR/Allegro/ecs2520mv250cntr.psm
Components/LIB_ECS-2520MV-250-CN-TR/ECS-2520MV-250-CN-TR/DEHDL/ecs_2520mv_250_cn_tr/chips/chips.prt
Components/LIB_FC-135R_32.7680KA-A3/FC-135R_32.7680KA-A3/Allegro/fc135r327680kaa3.psm
Components/LIB_FC-135R_32.7680KA-A3/FC-135R_32.7680KA-A3/DEHDL/fc_135r_32.7680ka_a3/chips/chips.prt
Components/LIB_FC-135_32.7680KA-A3/FC-135_32.7680KA-A3/Allegro/fc135327680kaa3.psm
Components/LIB_FC-135_32.7680KA-A3/FC-135_32.7680KA-A3/DEHDL/fc_135_32.7680ka_a3/chips/chips.prt
Components/LIB_FTSH-105-01-L-DV-K/FTSH-105-01-L-DV-K/Allegro/ftsh10501ldvk.psm
Components/LIB_FTSH-105-01-L-DV-K/FTSH-105-01-L-DV-K/DEHDL/ftsh_105_01_l_dv_k/chips/chips.prt
Components/LIB_HR911130A/HR911130A/3D/HR911130A.stp
Components/LIB_HR911130A/HR911130A/Allegro/hr911130a.psm
Components/LIB_HR911130A/HR911130A/DEHDL/hr911130a/chips/chips.prt
Components/LIB_LMK1C1102PWR/LMK1C1102PWR/Allegro/sop65p640x120-8n.psm
Components/LIB_LMK1C1102PWR/LMK1C1102PWR/DEHDL/lmk1c1102pwr/chips/chips.prt
Components/LIB_MEM2052-00-195-00-A/MEM2052-00-195-00-A/Allegro/mem20520019500a.psm
Components/LIB_MEM2052-00-195-00-A/MEM2052-00-195-00-A/DEHDL/mem2052_00_195_00_a/chips/chips.prt
Components/LIB_MGM240PB32VNA3/MGM240PB32VNA3/Allegro/mgm240pb32vna3.psm
Components/LIB_MGM240PB32VNA3/MGM240PB32VNA3/DEHDL/mgm240pb32vna3/chips/chips.prt
Components/LIB_MT40A1G16TB-062E_IT_F/MT40A1G16TB-062E_IT_F/Allegro/bga96c80p9x16_750x1300x120.psm
Components/LIB_MT40A1G16TB-062E_IT_F/MT40A1G16TB-062E_IT_F/DEHDL/mt40a1g16tb_062e_it_f/chips/chips.prt
Components/LIB_MT40A512M16LY-075E_D/MT40A512M16LY-075E_D/Allegro/bga96c80p9x16_750x1350x120.psm
Components/LIB_MT40A512M16LY-075E_D/MT40A512M16LY-075E_D/DEHDL/mt40a512m16ly_075e_d/chips/chips.prt
Components/LIB_SKYA21003/SKYA21003/Allegro/qfn50p200x200x65-13n-d.psm
Components/LIB_SKYA21003/SKYA21003/DEHDL/skya21003/chips/chips.prt
Components/LIB_SN74LVC2G241DCUR/SN74LVC2G241DCUR/Allegro/sop50p310x90-8n.psm
Components/LIB_SN74LVC2G241DCUR/SN74LVC2G241DCUR/DEHDL/sn74lvc2g241dcur/chips/chips.prt
Components/LIB_SRF2012-900YA/SRF2012-900YA/Allegro/srf2012900ya.psm
Components/LIB_SRF2012-900YA/SRF2012-900YA/DEHDL/srf2012_900ya/chips/chips.prt
Components/LIB_TF-15X15/TF-15X15/Allegro/tf15x15.psm
Components/LIB_TF-15X15/TF-15X15/DEHDL/tf_15x15/chips/chips.prt
Components/LIB_TLV62595DMQR/TLV62595DMQR/3D/TLV62595DMQR.stp
Components/LIB_TLV62595DMQR/TLV62595DMQR/Allegro/tlv62595dmqr.psm
Components/LIB_TLV62595DMQR/TLV62595DMQR/DEHDL/tlv62595dmqr/chips/chips.prt
Components/LIB_TM4C1294KCPDTI3/TM4C1294KCPDTI3/Allegro/qfp40p1600x1600x120-128n.psm
Components/LIB_TM4C1294KCPDTI3/TM4C1294KCPDTI3/DEHDL/tm4c1294kcpdti3/chips/chips.prt
Components/LIB_TPD1E1B04DPYR/TPD1E1B04DPYR/Allegro/tpd1e1b04dpyr.psm
Components/LIB_TPD1E1B04DPYR/TPD1E1B04DPYR/DEHDL/tpd1e1b04dpyr/chips/chips.prt
Components/LIB_TPD3S014DBVR/TPD3S014DBVR/Allegro/sot95p280x145-6n.psm
Components/LIB_TPD3S014DBVR/TPD3S014DBVR/DEHDL/tpd3s014dbvr/chips/chips.prt
Components/LIB_TPS22918DBVR/TPS22918DBVR/Allegro/sot95p280x145-6n.psm
Components/LIB_TPS22918DBVR/TPS22918DBVR/DEHDL/tps22918dbvr/chips/chips.prt
Components/LIB_TPS6521903RHBR/TPS6521903RHBR/3D/TPS6521903RHBR.stp
Components/LIB_TPS6521903RHBR/TPS6521903RHBR/Allegro/qfn50p500x500x100-33n-d.psm
Components/LIB_TPS6521903RHBR/TPS6521903RHBR/DEHDL/tps6521903rhbr/chips/chips.prt
Components/LIB_TVS0500DRVR/TVS0500DRVR/Allegro/son65p200x200x80-7n.psm
Components/LIB_TVS0500DRVR/TVS0500DRVR/DEHDL/tvs0500drvr/chips/chips.prt
Components/LIB_XRCGB25M000F3M00R0/XRCGB25M000F3M00R0/Allegro/xrcgb.psm
Components/LIB_XRCGB25M000F3M00R0/XRCGB25M000F3M00R0/DEHDL/xrcgb25m000f3m00r0/chips/chips.prt
Components/LIB_XRCGB32M000F1H01R0/XRCGB32M000F1H01R0/Allegro/xrcgb32m000f1h01r0.psm
Components/LIB_XRCGB32M000F1H01R0/XRCGB32M000F1H01R0/DEHDL/xrcgb32m000f1h01r0/chips/chips.prt
