Soft-Services/Leonhart/Components/CMUSB661022B/CMUSB661022B.pdf

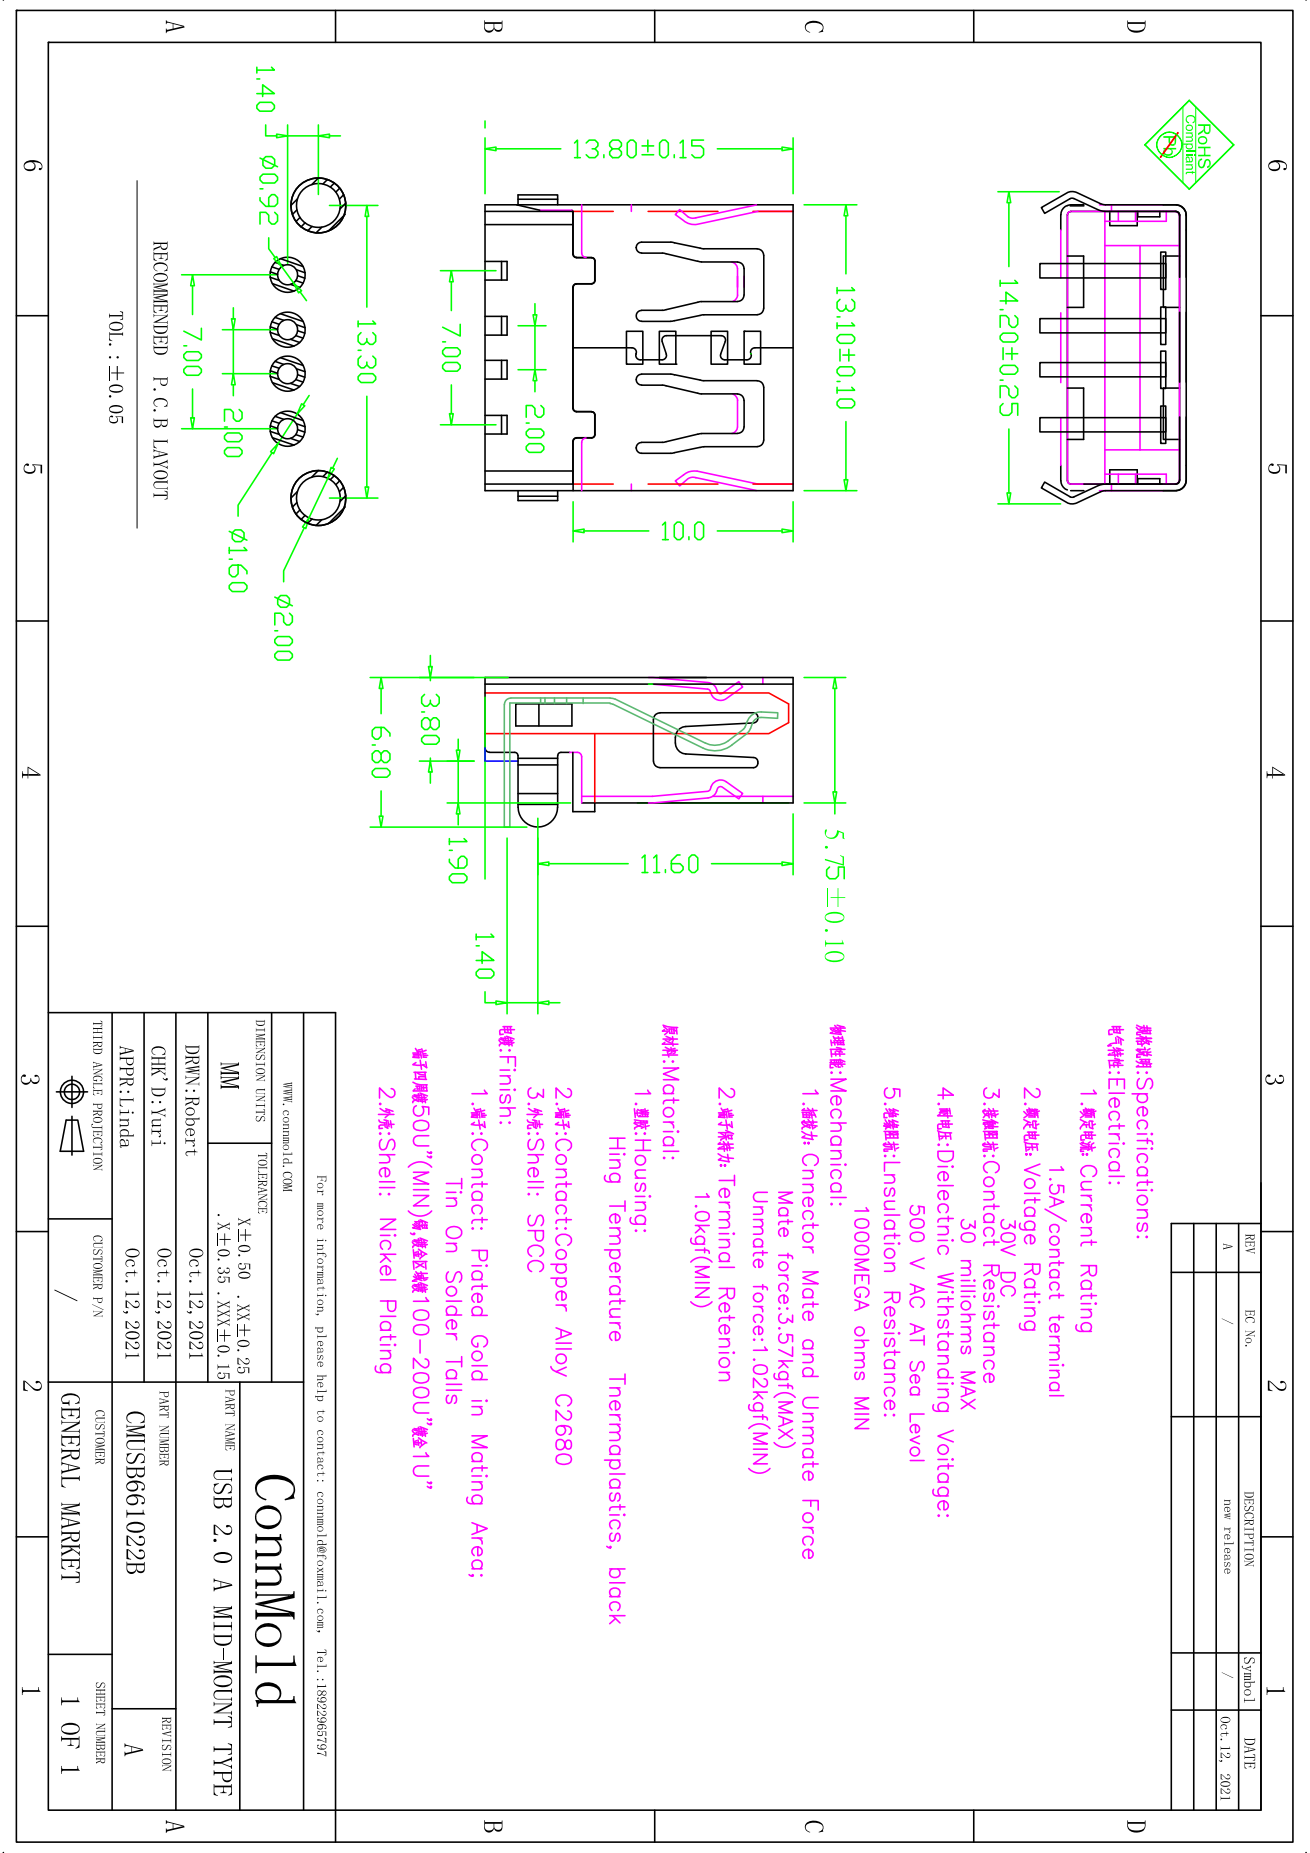
[picture p42: page 1]
