Soft-Services/Leonhart/(list of files, drawings)

Other design files:
Components/LIB_902-131A1011D10100/902-131A1011D10100/Altium/902-131A1011D10100.SchLib
Components/LIB_902-131A1011D10100/902-131A1011D10100/Altium/902131A1011D10100.PcbLib
Components/LIB_48037-0001/48037-0001/Altium/48037-0001.SchLib
Components/LIB_48037-0001/48037-0001/Altium/480370001.PcbLib
Components/LIB_1825910-6/1825910-6/Altium/1825910-6.SchLib
Components/LIB_1825910-6/1825910-6/Altium/18259106.PcbLib
Components/LIB_AM6231ASGGGAALW/AM6231ASGGGAALW/Altium/AM6231ASGGGAALW.SchLib
Components/LIB_AM6231ASGGGAALW/AM6231ASGGGAALW/Altium/BGA425C50P25X25_1300X1300X89.PcbLib
Components/LIB_AM6254ATCGHAALW/AM6254ATCGHAALW/Altium/AM6254ATCGHAALW.SchLib
Components/LIB_AM6254ATCGHAALW/AM6254ATCGHAALW/Altium/BGA425C50P25X25_1300X1300X89.PcbLib
Components/LIB_CC2652P1FRGZR/CC2652P1FRGZR/Altium/CC2652P1FRGZR.SchLib
Components/LIB_CC2652P1FRGZR/CC2652P1FRGZR/Altium/QFN50P700X700X100-49N-D.PcbLib
Components/LIB_CC2652PSIP/CC2652PSIP/Altium/CC2652PSIP.PcbLib
Components/LIB_CC2652PSIP/CC2652PSIP/Altium/CC2652PSIP.SchLib
Components/LIB_DFE252012P-2R2M=P2/DFE252012P-2R2M=P2/Altium/DFE2HCAH1R0MJ0L.PcbLib
Components/LIB_DFE252012P-2R2M=P2/DFE252012P-2R2M=P2/Altium/DFE252012P-2R2M=P2.SchLib
Components/LIB_DMG1012T/DMG1012T/Altium/DMG1012T.SchLib
Components/LIB_DMG1012T/DMG1012T/Altium/SOT50P160X90-3N.PcbLib
Components/LIB_ECS-2520MV-250-BN-TR/ECS-2520MV-250-BN-TR/Altium/ECS2520MV250BNTR.PcbLib
Components/LIB_ECS-2520MV-250-BN-TR/ECS-2520MV-250-BN-TR/Altium/ECS-2520MV-250-BN-TR.SchLib
Components/LIB_ECS-2520MV-250-CN-TR/ECS-2520MV-250-CN-TR/Altium/ECS2520MV250CNTR.PcbLib
Components/LIB_ECS-2520MV-250-CN-TR/ECS-2520MV-250-CN-TR/Altium/ECS-2520MV-250-CN-TR.SchLib
Components/LIB_FTSH-105-01-L-DV-K/FTSH-105-01-L-DV-K/Altium/FTSH10501LDVK.PcbLib
Components/LIB_FTSH-105-01-L-DV-K/FTSH-105-01-L-DV-K/Altium/FTSH-105-01-L-DV-K.SchLib
Components/LIB_HR911130A/HR911130A/Altium/HR911130A.PcbLib
Components/LIB_HR911130A/HR911130A/Altium/HR911130A.SchLib
Components/LIB_LMK1C1102PWR/LMK1C1102PWR/Altium/LMK1C1102PWR.SchLib
Components/LIB_LMK1C1102PWR/LMK1C1102PWR/Altium/SOP65P640X120-8N.PcbLib
Components/LIB_MEM2052-00-195-00-A/MEM2052-00-195-00-A/Altium/MEM2052-00-195-00-A.SchLib
Components/LIB_MEM2052-00-195-00-A/MEM2052-00-195-00-A/Altium/MEM20520019500A.PcbLib
Components/LIB_MGM240PB32VNA3/MGM240PB32VNA3/Altium/MGM240PB32VNA3.PcbLib
Components/LIB_MGM240PB32VNA3/MGM240PB32VNA3/Altium/MGM240PB32VNA3.SchLib
Components/LIB_MT40A1G16TB-062E_IT_F/MT40A1G16TB-062E_IT_F/Altium/BGA96C80P9X16_750X1300X120.PcbLib
Components/LIB_MT40A1G16TB-062E_IT_F/MT40A1G16TB-062E_IT_F/Altium/MT40A1G16TB-062E_IT_F.SchLib
Components/LIB_MT40A512M16LY-075E_D/MT40A512M16LY-075E_D/Altium/BGA96C80P9X16_750X1350X120.PcbLib
Components/LIB_MT40A512M16LY-075E_D/MT40A512M16LY-075E_D/Altium/MT40A512M16LY-075E_D.SchLib
Components/LIB_SKYA21003/SKYA21003/Altium/QFN50P200X200X65-13N-D.PcbLib
Components/LIB_SKYA21003/SKYA21003/Altium/SKYA21003.SchLib
Components/LIB_SN74LVC2G241DCUR/SN74LVC2G241DCUR/Altium/SN74LVC2G241DCUR.SchLib
Components/LIB_SN74LVC2G241DCUR/SN74LVC2G241DCUR/Altium/SOP50P310X90-8N.PcbLib
Components/LIB_TF-15X15/TF-15X15/Altium/TF15X15.PcbLib
Components/LIB_TF-15X15/TF-15X15/Altium/TF-15X15.SchLib
Components/LIB_TLV62595DMQR/TLV62595DMQR/Altium/TLV62595DMQR.PcbLib
Components/LIB_TLV62595DMQR/TLV62595DMQR/Altium/TLV62595DMQR.SchLib
Components/LIB_TM4C1294KCPDTI3/TM4C1294KCPDTI3/Altium/QFP40P1600X1600X120-128N.PcbLib
Components/LIB_TM4C1294KCPDTI3/TM4C1294KCPDTI3/Altium/TM4C1294KCPDTI3.SchLib
Components/LIB_TPD3S014DBVR/TPD3S014DBVR/Altium/SOT95P280X145-6N.PcbLib
Components/LIB_TPD3S014DBVR/TPD3S014DBVR/Altium/TPD3S014DBVR.SchLib
Components/LIB_TPS22918DBVR/TPS22918DBVR/Altium/SOT95P280X145-6N.PcbLib
Components/LIB_TPS22918DBVR/TPS22918DBVR/Altium/TPS22918DBVR.SchLib
Components/LIB_TPS6521903RHBR/TPS6521903RHBR/Altium/QFN50P500X500X100-33N-D.PcbLib
Components/LIB_TPS6521903RHBR/TPS6521903RHBR/Altium/TPS6521903RHBR.SchLib
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
