Soft-Services/Leonhart/Leonhart.kicad_pcb

## KiCad design Leonhart.kicad_pcb (2026-05-19)

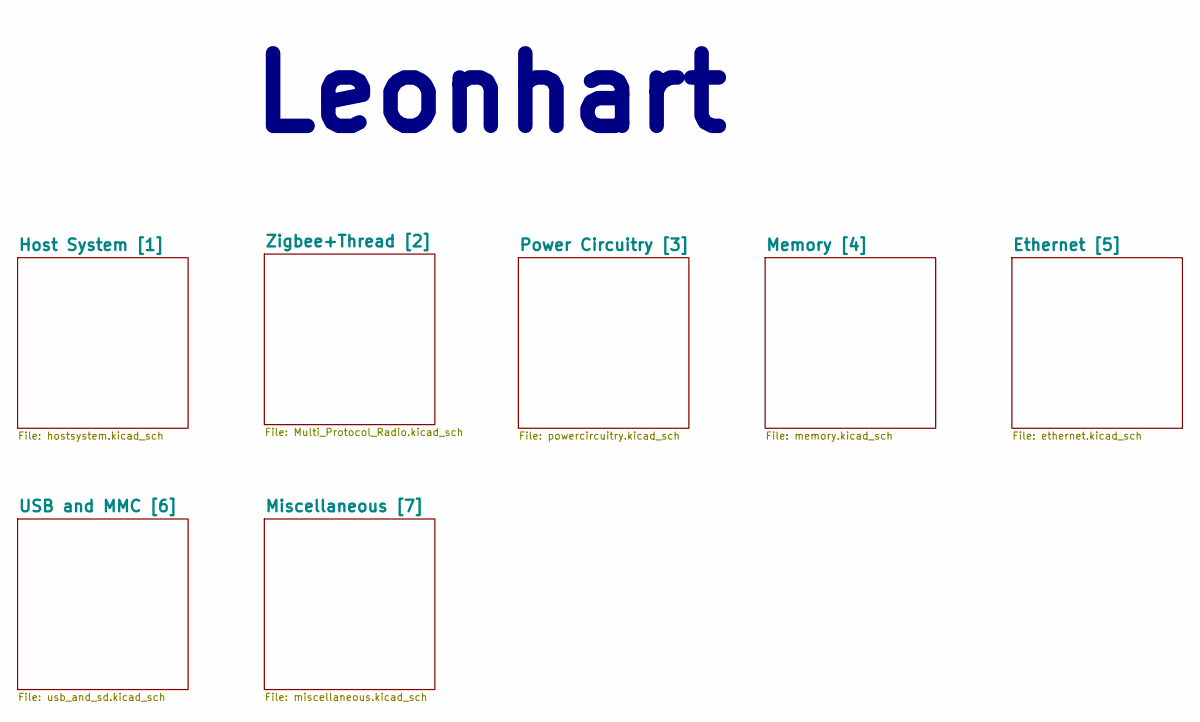
[picture p43: schematic Leonhart.kicad_sch]

Notes on the sheet:
Leonhart

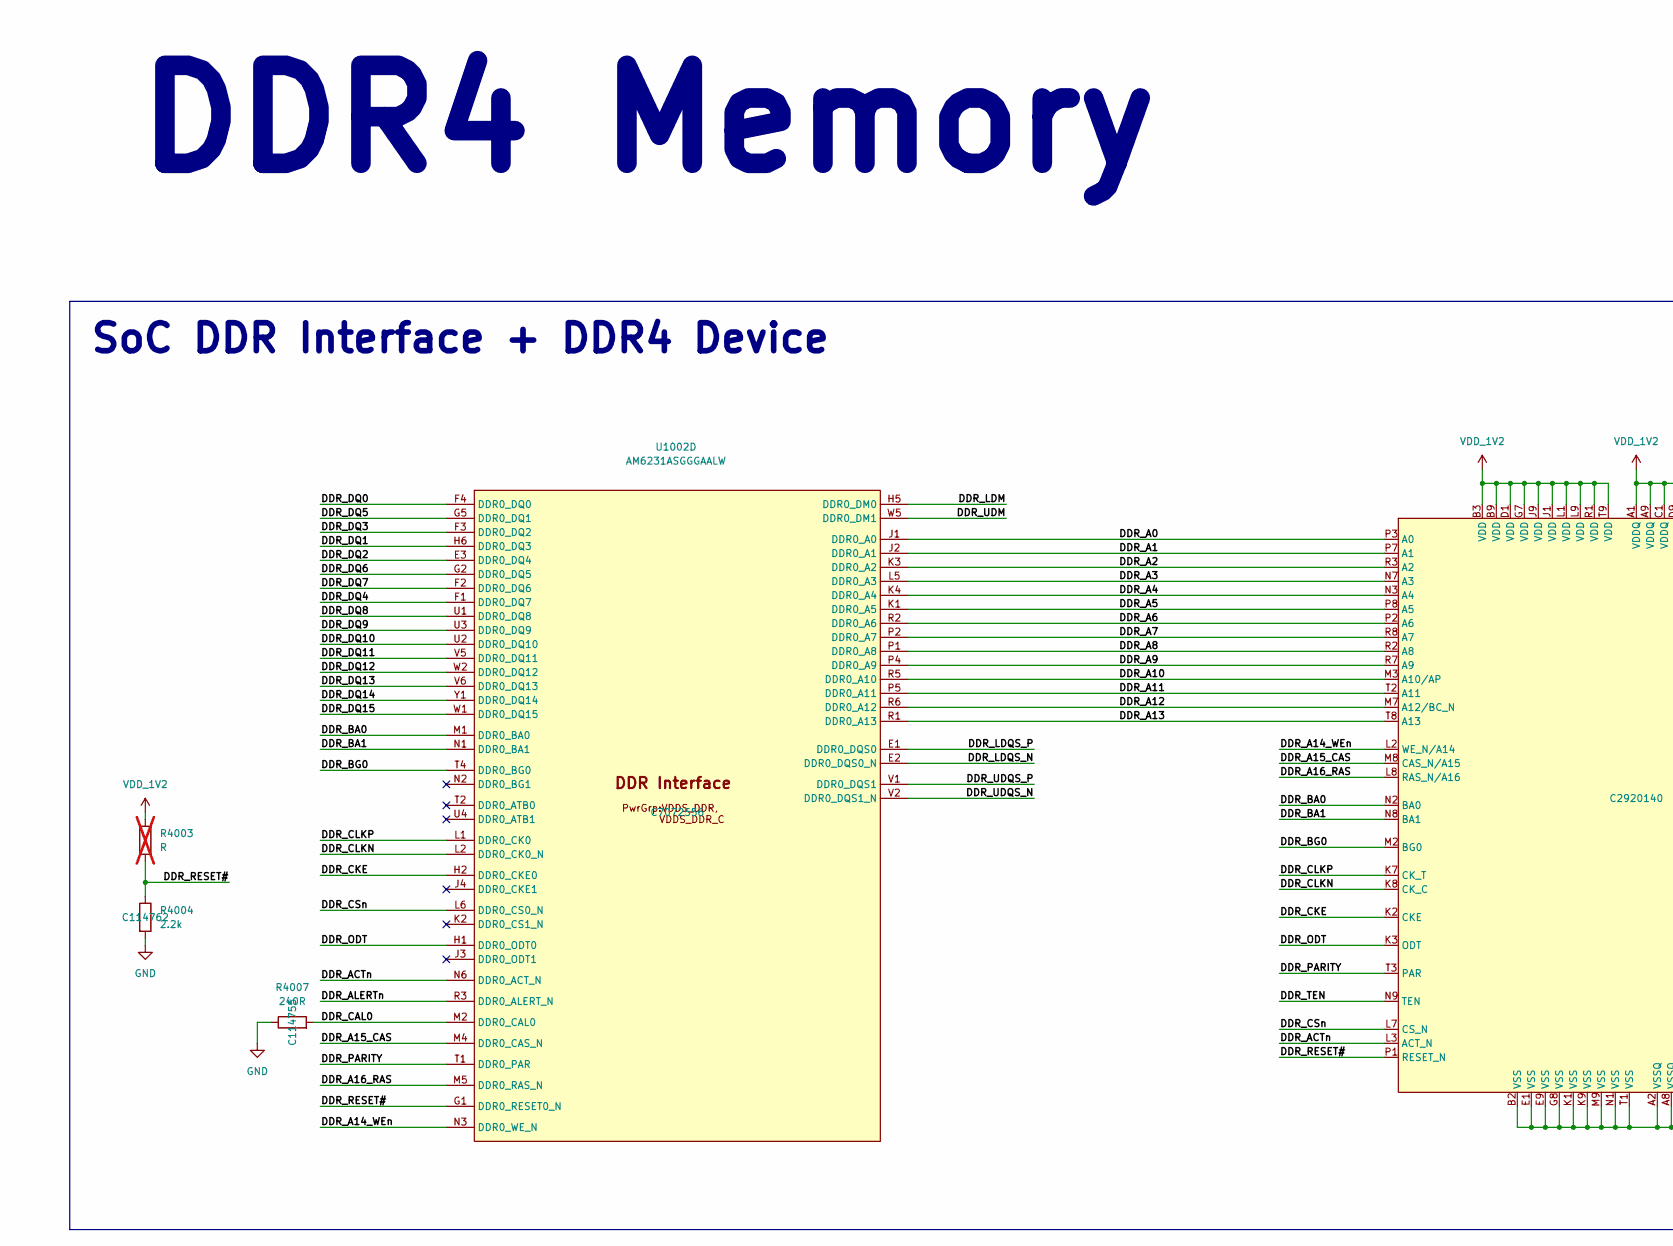
[picture p44: schematic memory.kicad_sch, part in row 1, column 1]

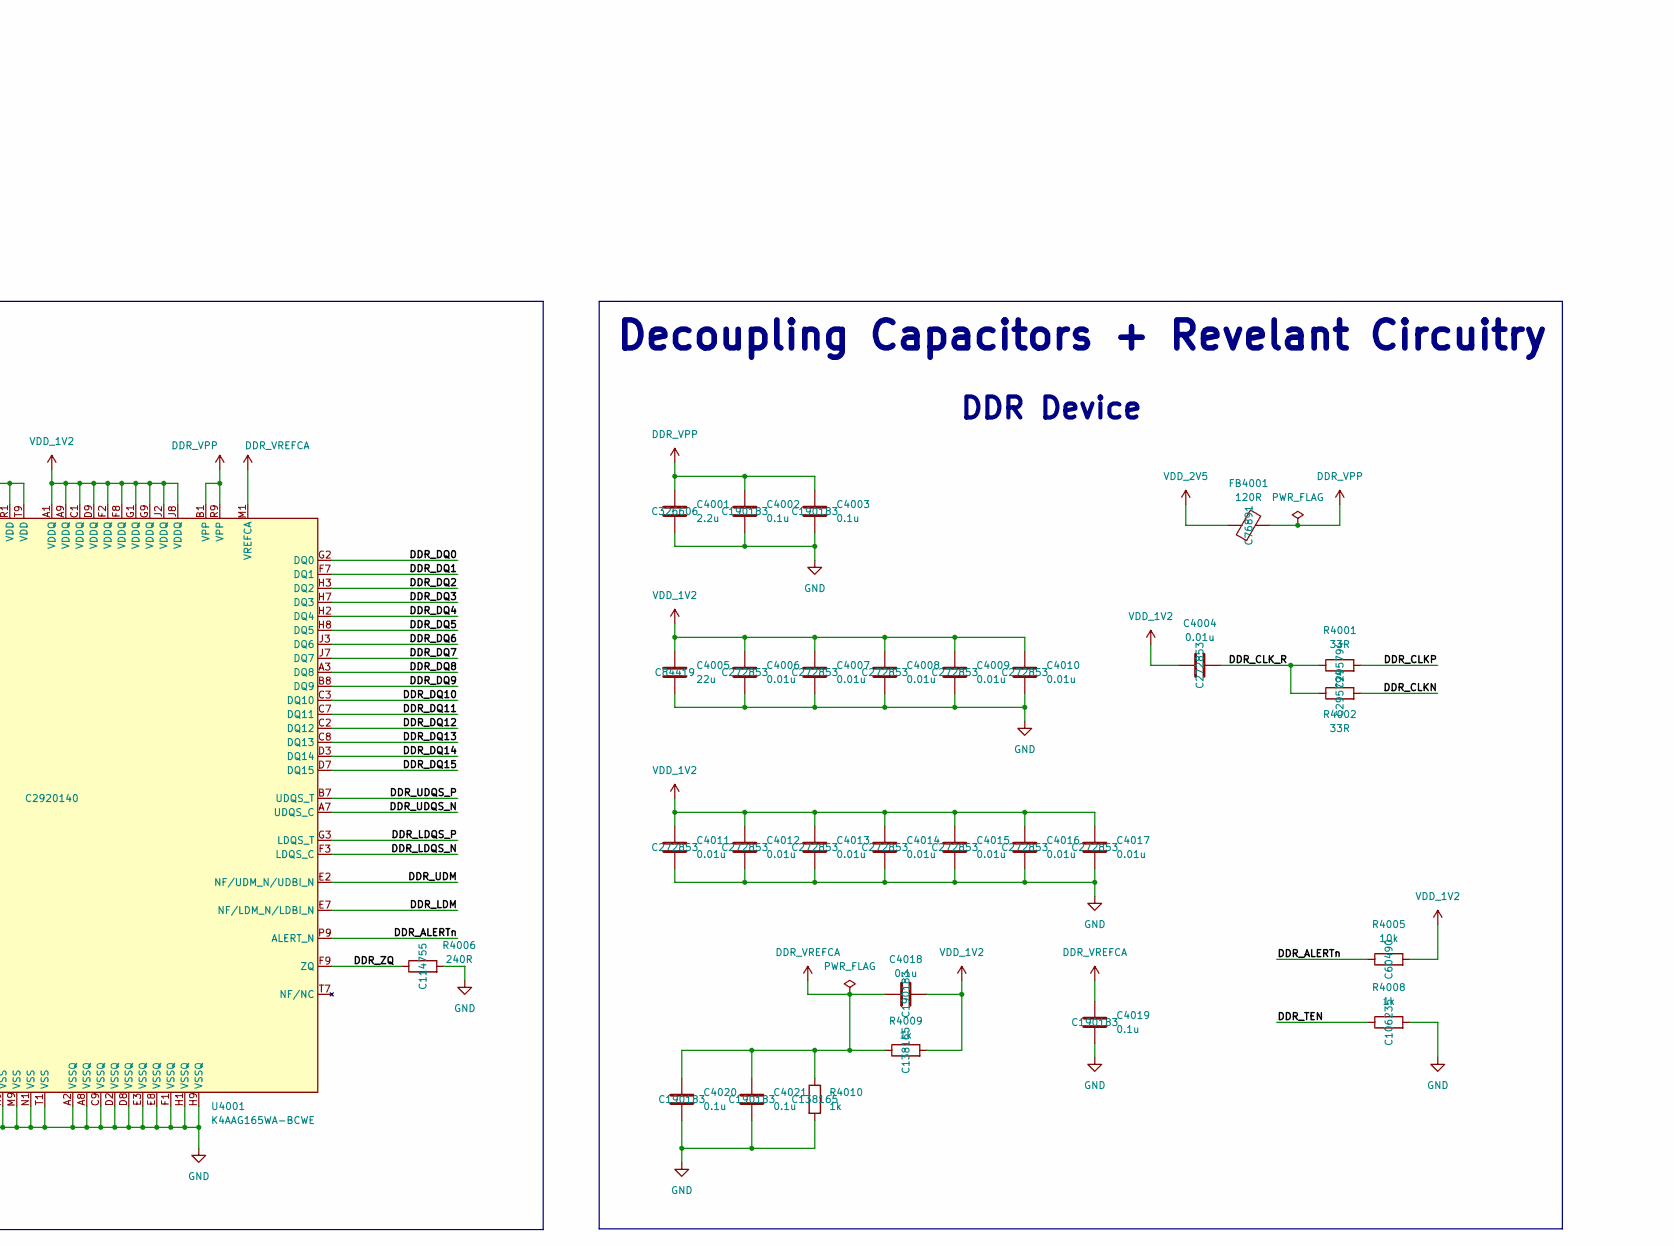
[picture p45: schematic memory.kicad_sch, part in row 1, column 2]

Parts:
C4001: 2.2u; C_0402_1005Metric; JLCPCB Part# C326606
C4002, C4003, C4018, C4019, C4020, C4021: 0.1u; C_0201_0603Metric; JLCPCB Part# C190183
C4004, C4006, C4007, C4008, C4009, C4010, C4011, C4012, C4013, C4014, C4015, C4016, C4017: 0.01u; C_0201_0603Metric; JLCPCB Part# C272853
C4005: 22u; C_0603_1608Metric; JLCPCB Part# C84419
FB4001: 120R; R_0402_1005Metric; Part BLM15PX121SN1D; JLCPCB Part# C76891
R4001, R4002: 33R; R_0201_0603Metric; JLCPCB Part# C295794
R4003: R; R_0402_1005Metric; not fitted
R4004: 2.2k; R_0402_1005Metric; JLCPCB Part# C114762
R4005: 10k; R_0402_1005Metric; JLCPCB Part# C60490
R4006, R4007: 240R; R_0402_1005Metric; JLCPCB Part# C114755
R4008: 1k; R_0402_1005Metric; JLCPCB Part# C106235
R4009, R4010: 1k; R_0201_0603Metric; JLCPCB Part# C138165
U1002: AM6231ASGGGAALW; BGA425C50P25X25_1300X1300X89; JLCPCB Part# C7072556
U4001: K4AAG165WA-BCWE; FBGA-96_9x13mm_Layout9x16_P0.8mm; JLCPCB Part# C2920140

Connections:
/Memory [4]/DDR_A0: U1002.J1 (DDR0_A0), U4001.P3 (A0)
/Memory [4]/DDR_A1: U1002.J2 (DDR0_A1), U4001.P7 (A1)
/Memory [4]/DDR_A2: U1002.K3 (DDR0_A2), U4001.R3 (A2)
/Memory [4]/DDR_A3: U1002.L5 (DDR0_A3), U4001.N7 (A3)
/Memory [4]/DDR_A4: U1002.K4 (DDR0_A4), U4001.N3 (A4)
/Memory [4]/DDR_A5: U1002.K1 (DDR0_A5), U4001.P8 (A5)
/Memory [4]/DDR_A6: U1002.R2 (DDR0_A6), U4001.P2 (A6)
/Memory [4]/DDR_A7: U1002.P2 (DDR0_A7), U4001.R8 (A7)
/Memory [4]/DDR_A8: U1002.P1 (DDR0_A8), U4001.R2 (A8)
/Memory [4]/DDR_A9: U1002.P4 (DDR0_A9), U4001.R7 (A9)
/Memory [4]/DDR_A10: U1002.R5 (DDR0_A10), U4001.M3 (A10/AP)
/Memory [4]/DDR_A11: U1002.P5 (DDR0_A11), U4001.T2 (A11)
/Memory [4]/DDR_A12: U1002.R6 (DDR0_A12), U4001.M7 (A12/BC_N)
/Memory [4]/DDR_A13: U1002.R1 (DDR0_A13), U4001.T8 (A13)
/Memory [4]/DDR_A14_WEn: U1002.N3 (DDR0_WE_N), U4001.L2 (WE_N/A14)
/Memory [4]/DDR_A15_CAS: U1002.M4 (DDR0_CAS_N), U4001.M8 (CAS_N/A15)
/Memory [4]/DDR_A16_RAS: U1002.M5 (DDR0_RAS_N), U4001.L8 (RAS_N/A16)
/Memory [4]/DDR_ACTn: U1002.N6 (DDR0_ACT_N), U4001.L3 (ACT_N)
/Memory [4]/DDR_ALERTn: R4005.1, U1002.R3 (DDR0_ALERT_N), U4001.P9 (ALERT_N)
/Memory [4]/DDR_BA0: U1002.M1 (DDR0_BA0), U4001.N2 (BA0)
/Memory [4]/DDR_BA1: U1002.N1 (DDR0_BA1), U4001.N8 (BA1)
/Memory [4]/DDR_BG0: U1002.T4 (DDR0_BG0), U4001.M2 (BG0)
/Memory [4]/DDR_CAL0: R4007.2, U1002.M2 (DDR0_CAL0)
/Memory [4]/DDR_CKE: U1002.H2 (DDR0_CKE0), U4001.K2 (CKE)
/Memory [4]/DDR_CLKN: R4002.2, U1002.L2 (DDR0_CK0_N), U4001.K8 (CK_C)
/Memory [4]/DDR_CLKP: R4001.2, U1002.L1 (DDR0_CK0), U4001.K7 (CK_T)
/Memory [4]/DDR_CLK_R: C4004.2, R4001.1, R4002.1
/Memory [4]/DDR_CSn: U1002.L6 (DDR0_CS0_N), U4001.L7 (CS_N)
/Memory [4]/DDR_DQ0: U1002.F4 (DDR0_DQ0), U4001.G2 (DQ0)
/Memory [4]/DDR_DQ1: U1002.H6 (DDR0_DQ3), U4001.F7 (DQ1)
/Memory [4]/DDR_DQ2: U1002.E3 (DDR0_DQ4), U4001.H3 (DQ2)
/Memory [4]/DDR_DQ3: U1002.F3 (DDR0_DQ2), U4001.H7 (DQ3)
/Memory [4]/DDR_DQ4: U1002.F1 (DDR0_DQ7), U4001.H2 (DQ4)
/Memory [4]/DDR_DQ5: U1002.G5 (DDR0_DQ1), U4001.H8 (DQ5)
/Memory [4]/DDR_DQ6: U1002.G2 (DDR0_DQ5), U4001.J3 (DQ6)
/Memory [4]/DDR_DQ7: U1002.F2 (DDR0_DQ6), U4001.J7 (DQ7)
/Memory [4]/DDR_DQ8: U1002.U1 (DDR0_DQ8), U4001.A3 (DQ8)
/Memory [4]/DDR_DQ9: U1002.U3 (DDR0_DQ9), U4001.B8 (DQ9)
/Memory [4]/DDR_DQ10: U1002.U2 (DDR0_DQ10), U4001.C3 (DQ10)
/Memory [4]/DDR_DQ11: U1002.V5 (DDR0_DQ11), U4001.C7 (DQ11)
/Memory [4]/DDR_DQ12: U1002.W2 (DDR0_DQ12), U4001.C2 (DQ12)
/Memory [4]/DDR_DQ13: U1002.V6 (DDR0_DQ13), U4001.C8 (DQ13)
/Memory [4]/DDR_DQ14: U1002.Y1 (DDR0_DQ14), U4001.D3 (DQ14)
/Memory [4]/DDR_DQ15: U1002.W1 (DDR0_DQ15), U4001.D7 (DQ15)
/Memory [4]/DDR_LDM: U1002.H5 (DDR0_DM0), U4001.E7 (NF/LDM_N/LDBI_N)
/Memory [4]/DDR_LDQS_N: U1002.E2 (DDR0_DQS0_N), U4001.F3 (LDQS_C)
/Memory [4]/DDR_LDQS_P: U1002.E1 (DDR0_DQS0), U4001.G3 (LDQS_T)
/Memory [4]/DDR_ODT: U1002.H1 (DDR0_ODT0), U4001.K3 (ODT)
/Memory [4]/DDR_PARITY: U1002.T1 (DDR0_PAR), U4001.T3 (PAR)
/Memory [4]/DDR_RESET#: R4003.2, R4004.1, U1002.G1 (DDR0_RESET0_N), U4001.P1 (RESET_N)
/Memory [4]/DDR_TEN: R4008.1, U4001.N9 (TEN)
/Memory [4]/DDR_UDM: U1002.W5 (DDR0_DM1), U4001.E2 (NF/UDM_N/UDBI_N)
/Memory [4]/DDR_UDQS_N: U1002.V2 (DDR0_DQS1_N), U4001.A7 (UDQS_C)
/Memory [4]/DDR_UDQS_P: U1002.V1 (DDR0_DQS1), U4001.B7 (UDQS_T)
/Memory [4]/DDR_ZQ: R4006.1, U4001.F9 (ZQ)
DDR_VPP: C4001.1, C4002.1, C4003.1, FB4001.2, U4001.B1 (VPP), U4001.R9 (VPP)
DDR_VREFCA: C4018.1, C4019.1, C4020.1, C4021.1, R4009.1, R4010.1, U4001.M1 (VREFCA)
GND: C4001.2, C4002.2, C4003.2, C4005.2, C4006.2, C4007.2, C4008.2, C4009.2, C4010.2, C4011.2, C4012.2, C4013.2, C4014.2, C4015.2, C4016.2, C4017.2, C4019.2, C4020.2, C4021.2, R4004.2, R4006.2, R4007.1, R4008.2, R4010.2, U4001.A2 (VSSQ), U4001.A8 (VSSQ), U4001.B2 (VSS), U4001.C9 (VSSQ), U4001.D2 (VSSQ), U4001.D8 (VSSQ), U4001.E1 (VSS), U4001.E3 (VSSQ), U4001.E8 (VSSQ), U4001.E9 (VSS), U4001.F1 (VSSQ), U4001.G8 (VSS), U4001.H1 (VSSQ), U4001.H9 (VSSQ), U4001.K1 (VSS), U4001.K9 (VSS), U4001.M9 (VSS), U4001.N1 (VSS), U4001.T1 (VSS); also elsewhere on the board
VDD_1V2: C4004.1, C4005.1, C4006.1, C4007.1, C4008.1, C4009.1, C4010.1, C4011.1, C4012.1, C4013.1, C4014.1, C4015.1, C4016.1, C4017.1, C4018.2, R4003.1, R4005.2, R4009.2, U4001.A1 (VDDQ), U4001.A9 (VDDQ), U4001.B3 (VDD), U4001.B9 (VDD), U4001.C1 (VDDQ), U4001.D1 (VDD), U4001.D9 (VDDQ), U4001.F2 (VDDQ), U4001.F8 (VDDQ), U4001.G1 (VDDQ), U4001.G7 (VDD), U4001.G9 (VDDQ), U4001.J1 (VDD), U4001.J2 (VDDQ), U4001.J8 (VDDQ), U4001.J9 (VDD), U4001.L1 (VDD), U4001.L9 (VDD), U4001.R1 (VDD), U4001.T9 (VDD); also elsewhere on the board
VDD_2V5: FB4001.1; also elsewhere on the board

Notes on the sheet:
DDR4 Memory
SoC DDR Interface + DDR4 Device
Decoupling Capacitors + Revelant Circuitry
DDR Device
