Soft-Services/Leonhart/Leonhart.kicad_pcb

## KiCad design Leonhart.kicad_pcb (continued)

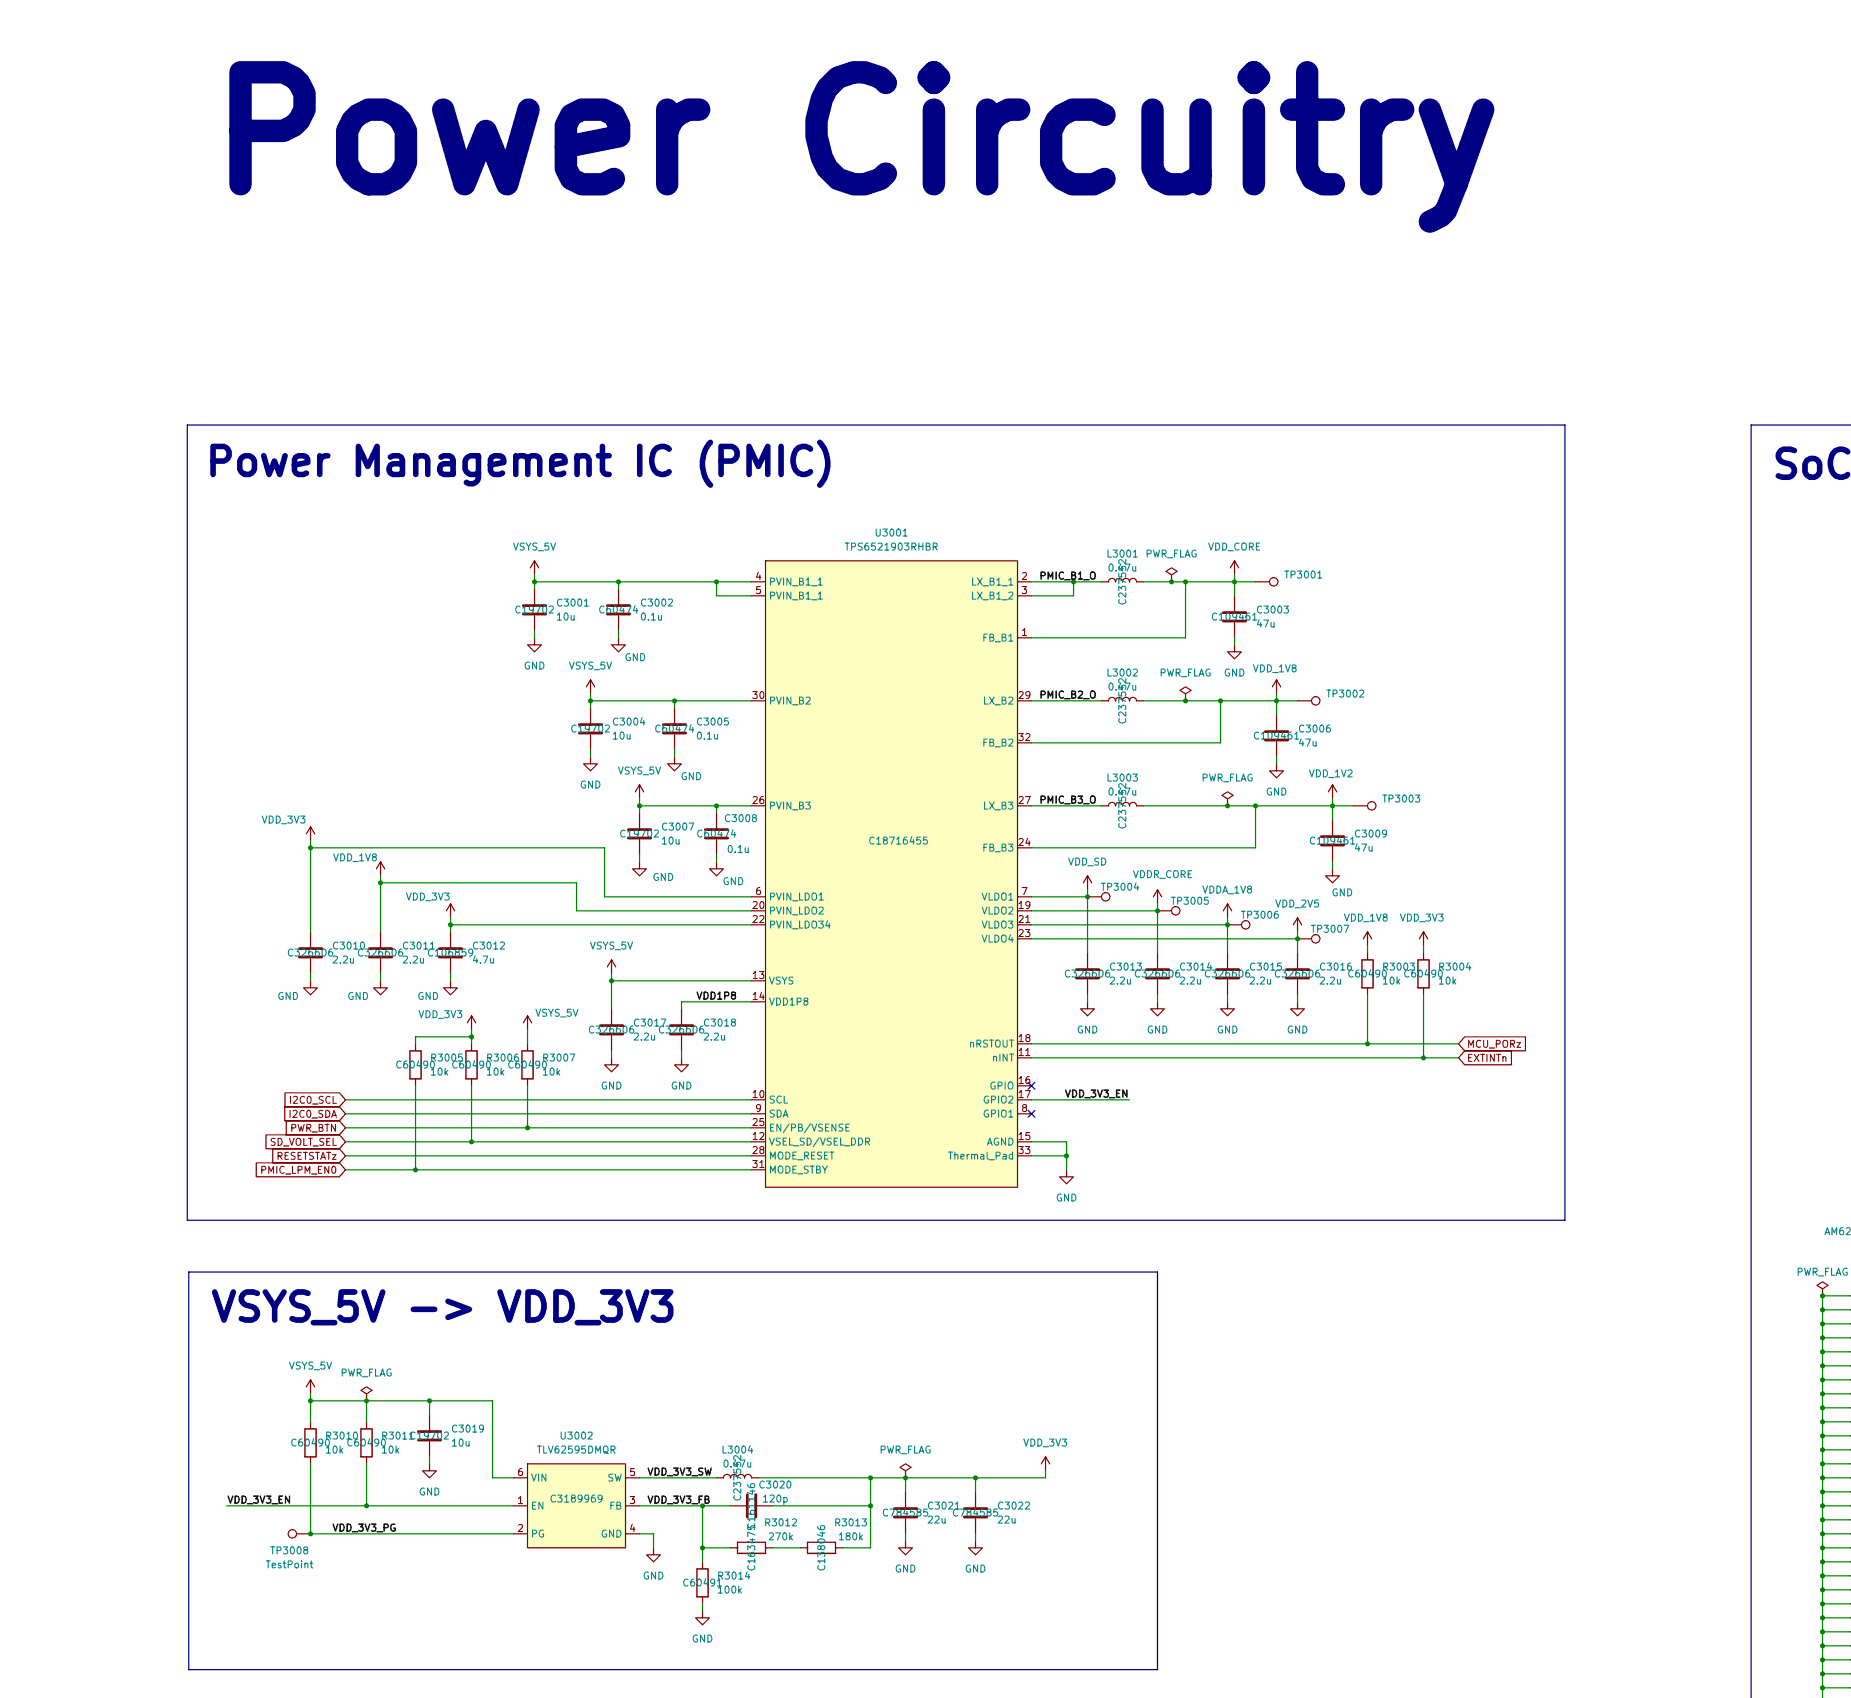
[picture p46: schematic powercircuitry.kicad_sch, part in row 1, column 1]

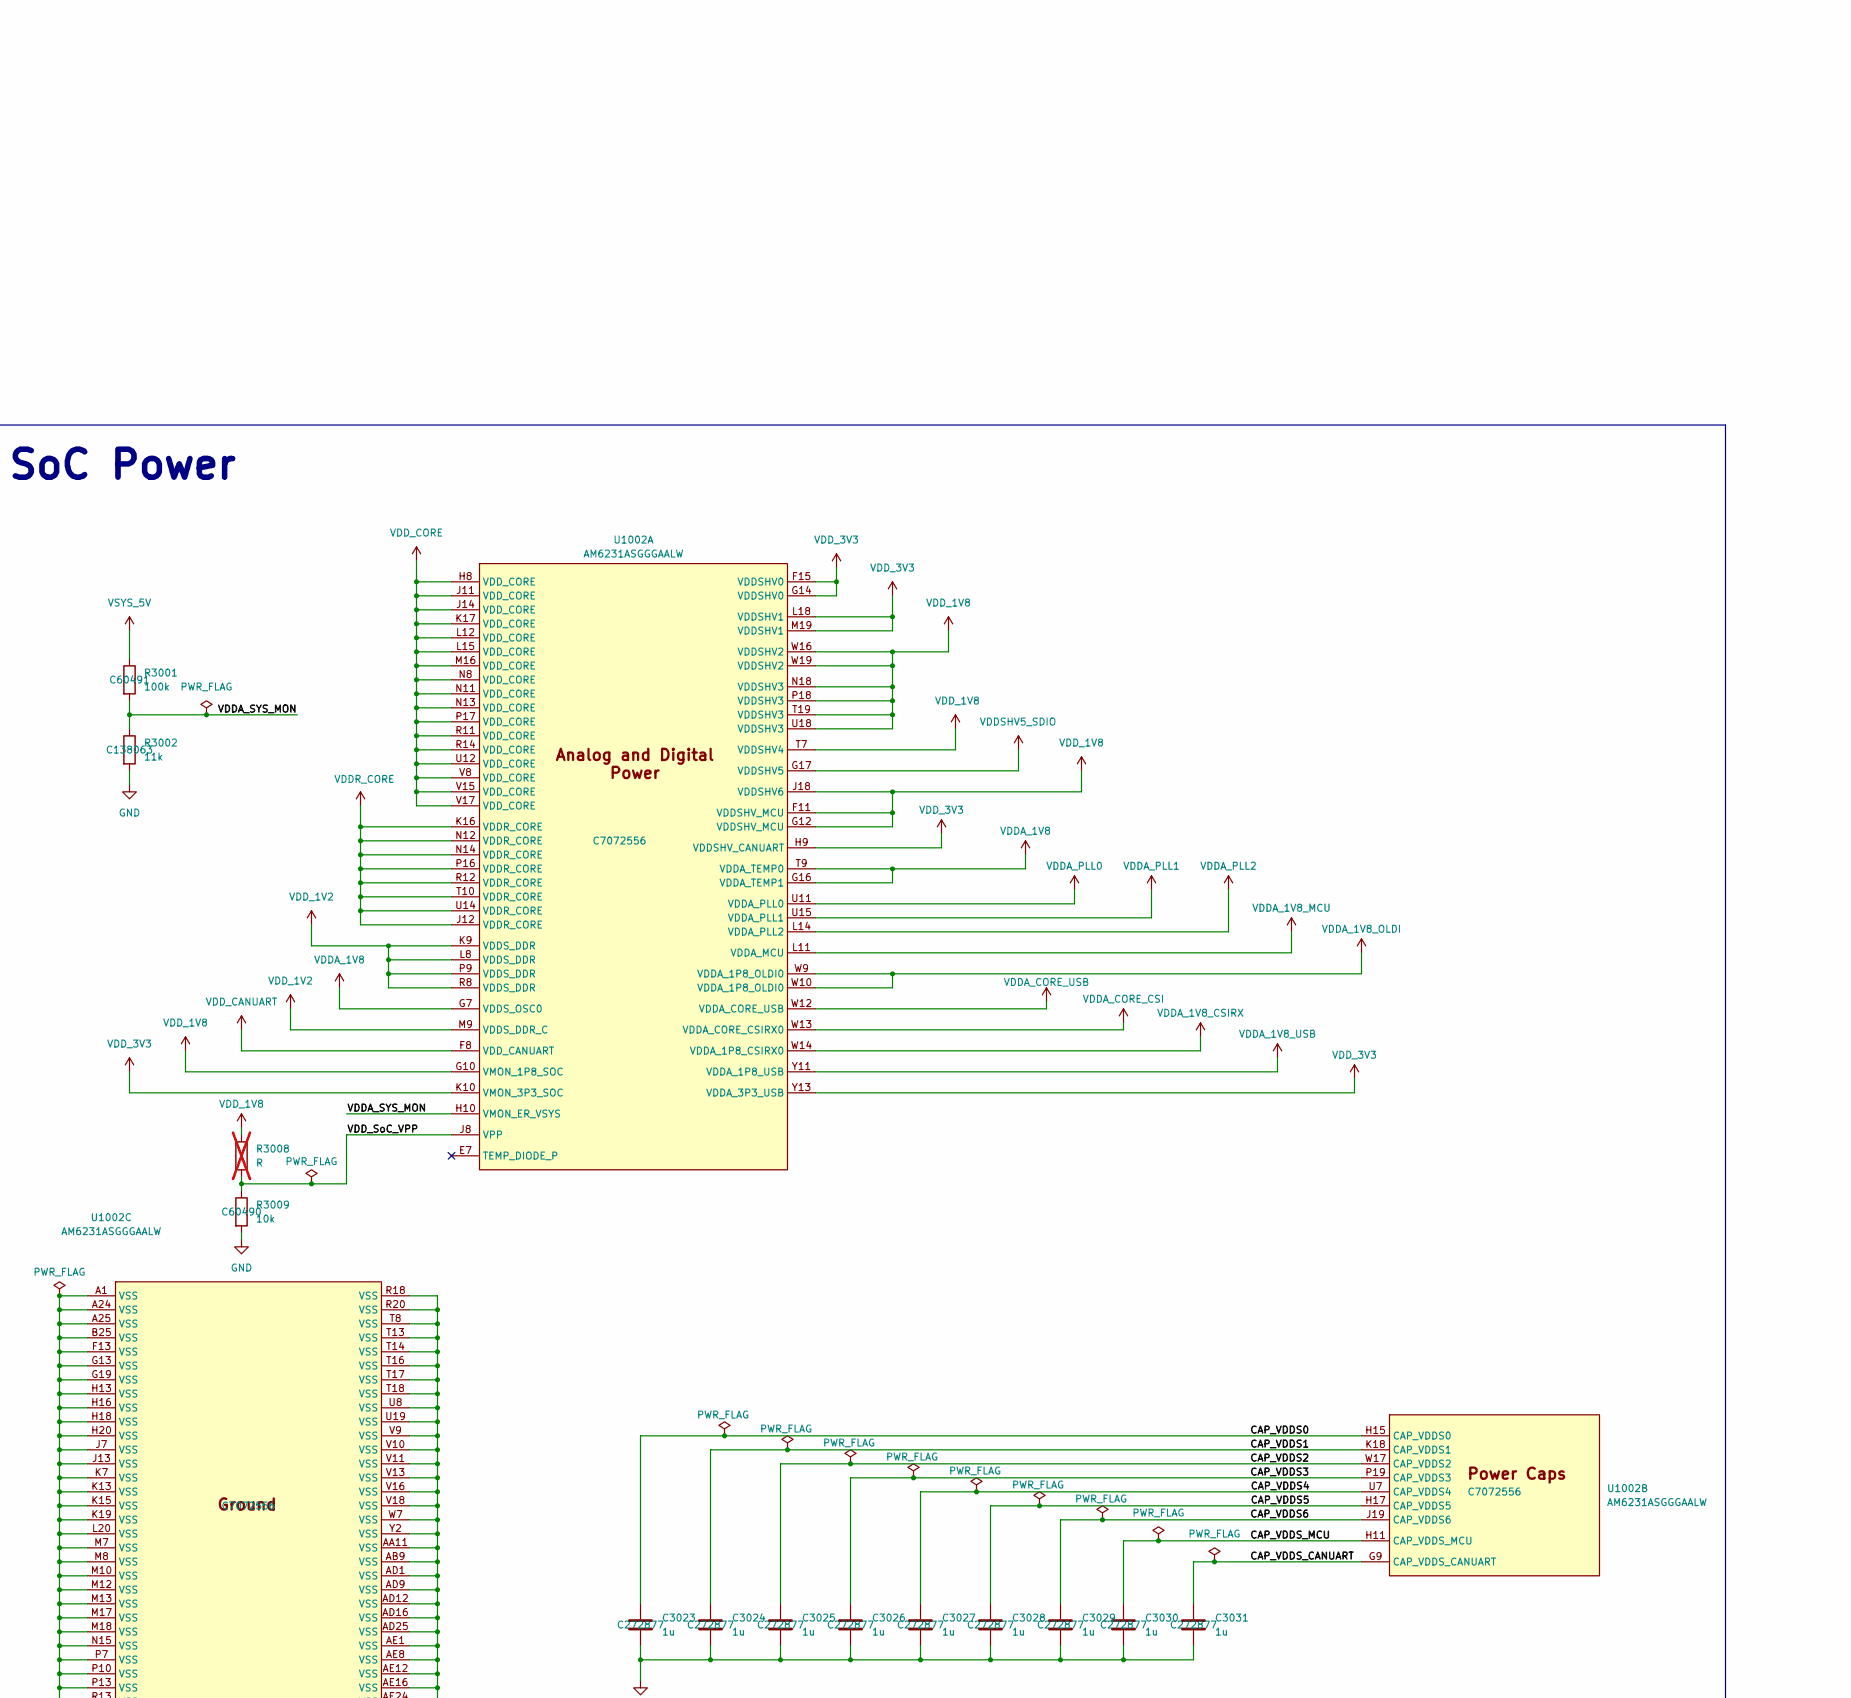
[picture p47: schematic powercircuitry.kicad_sch, part in row 1, column 2]

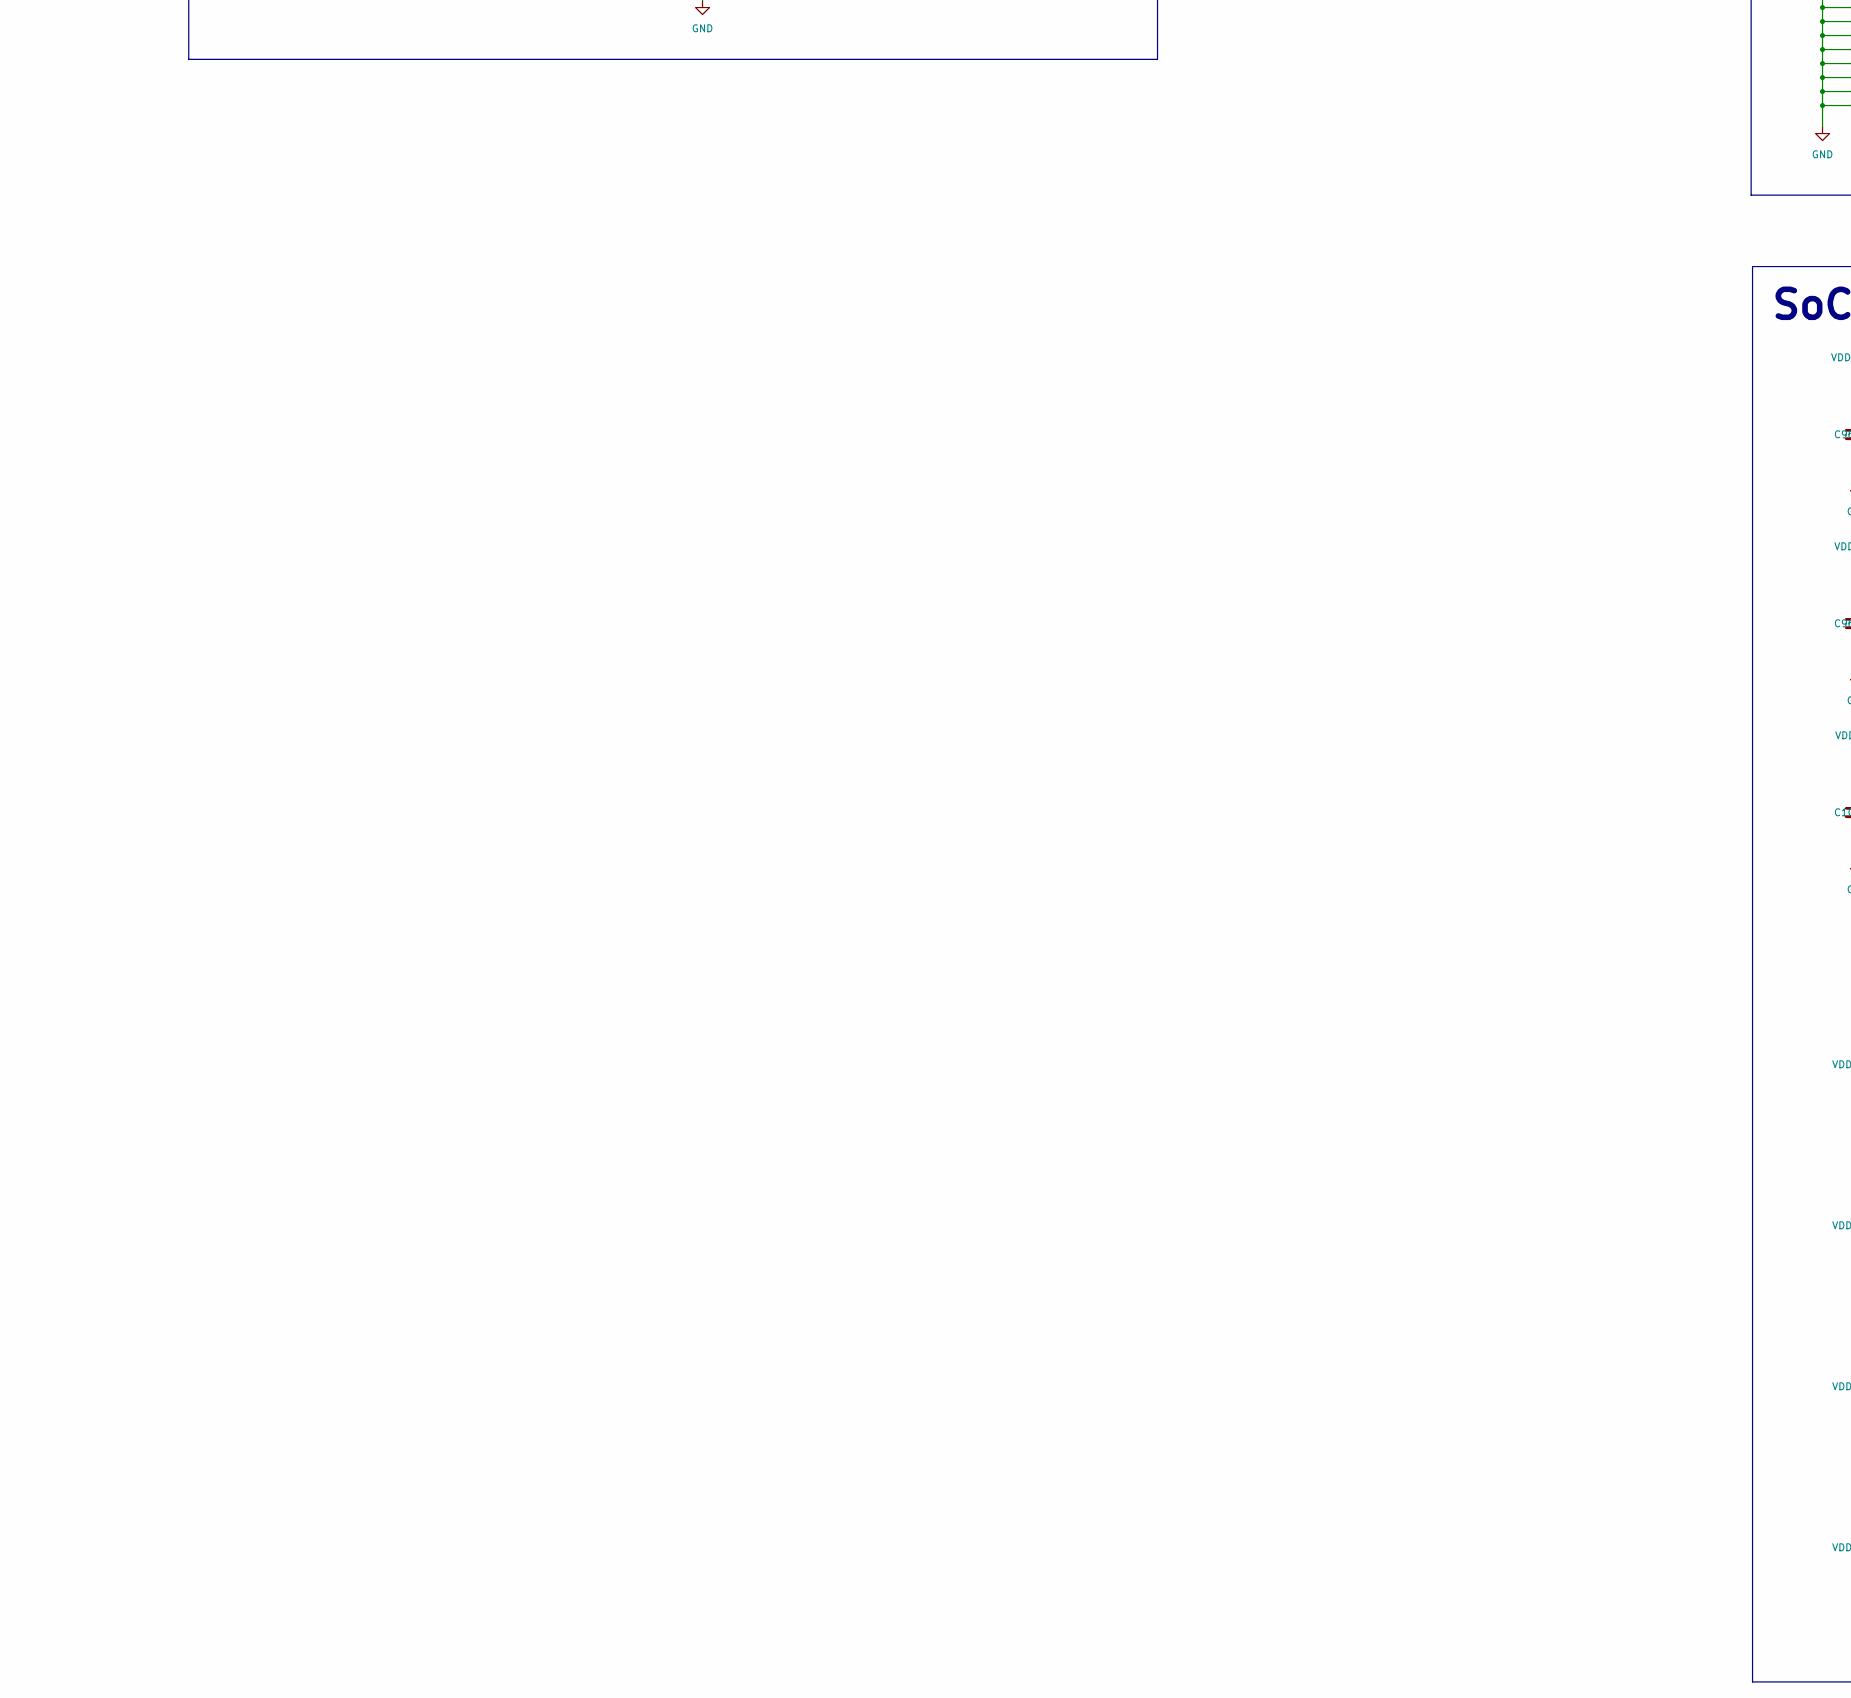
[picture p48: schematic powercircuitry.kicad_sch, part in row 2, column 1]

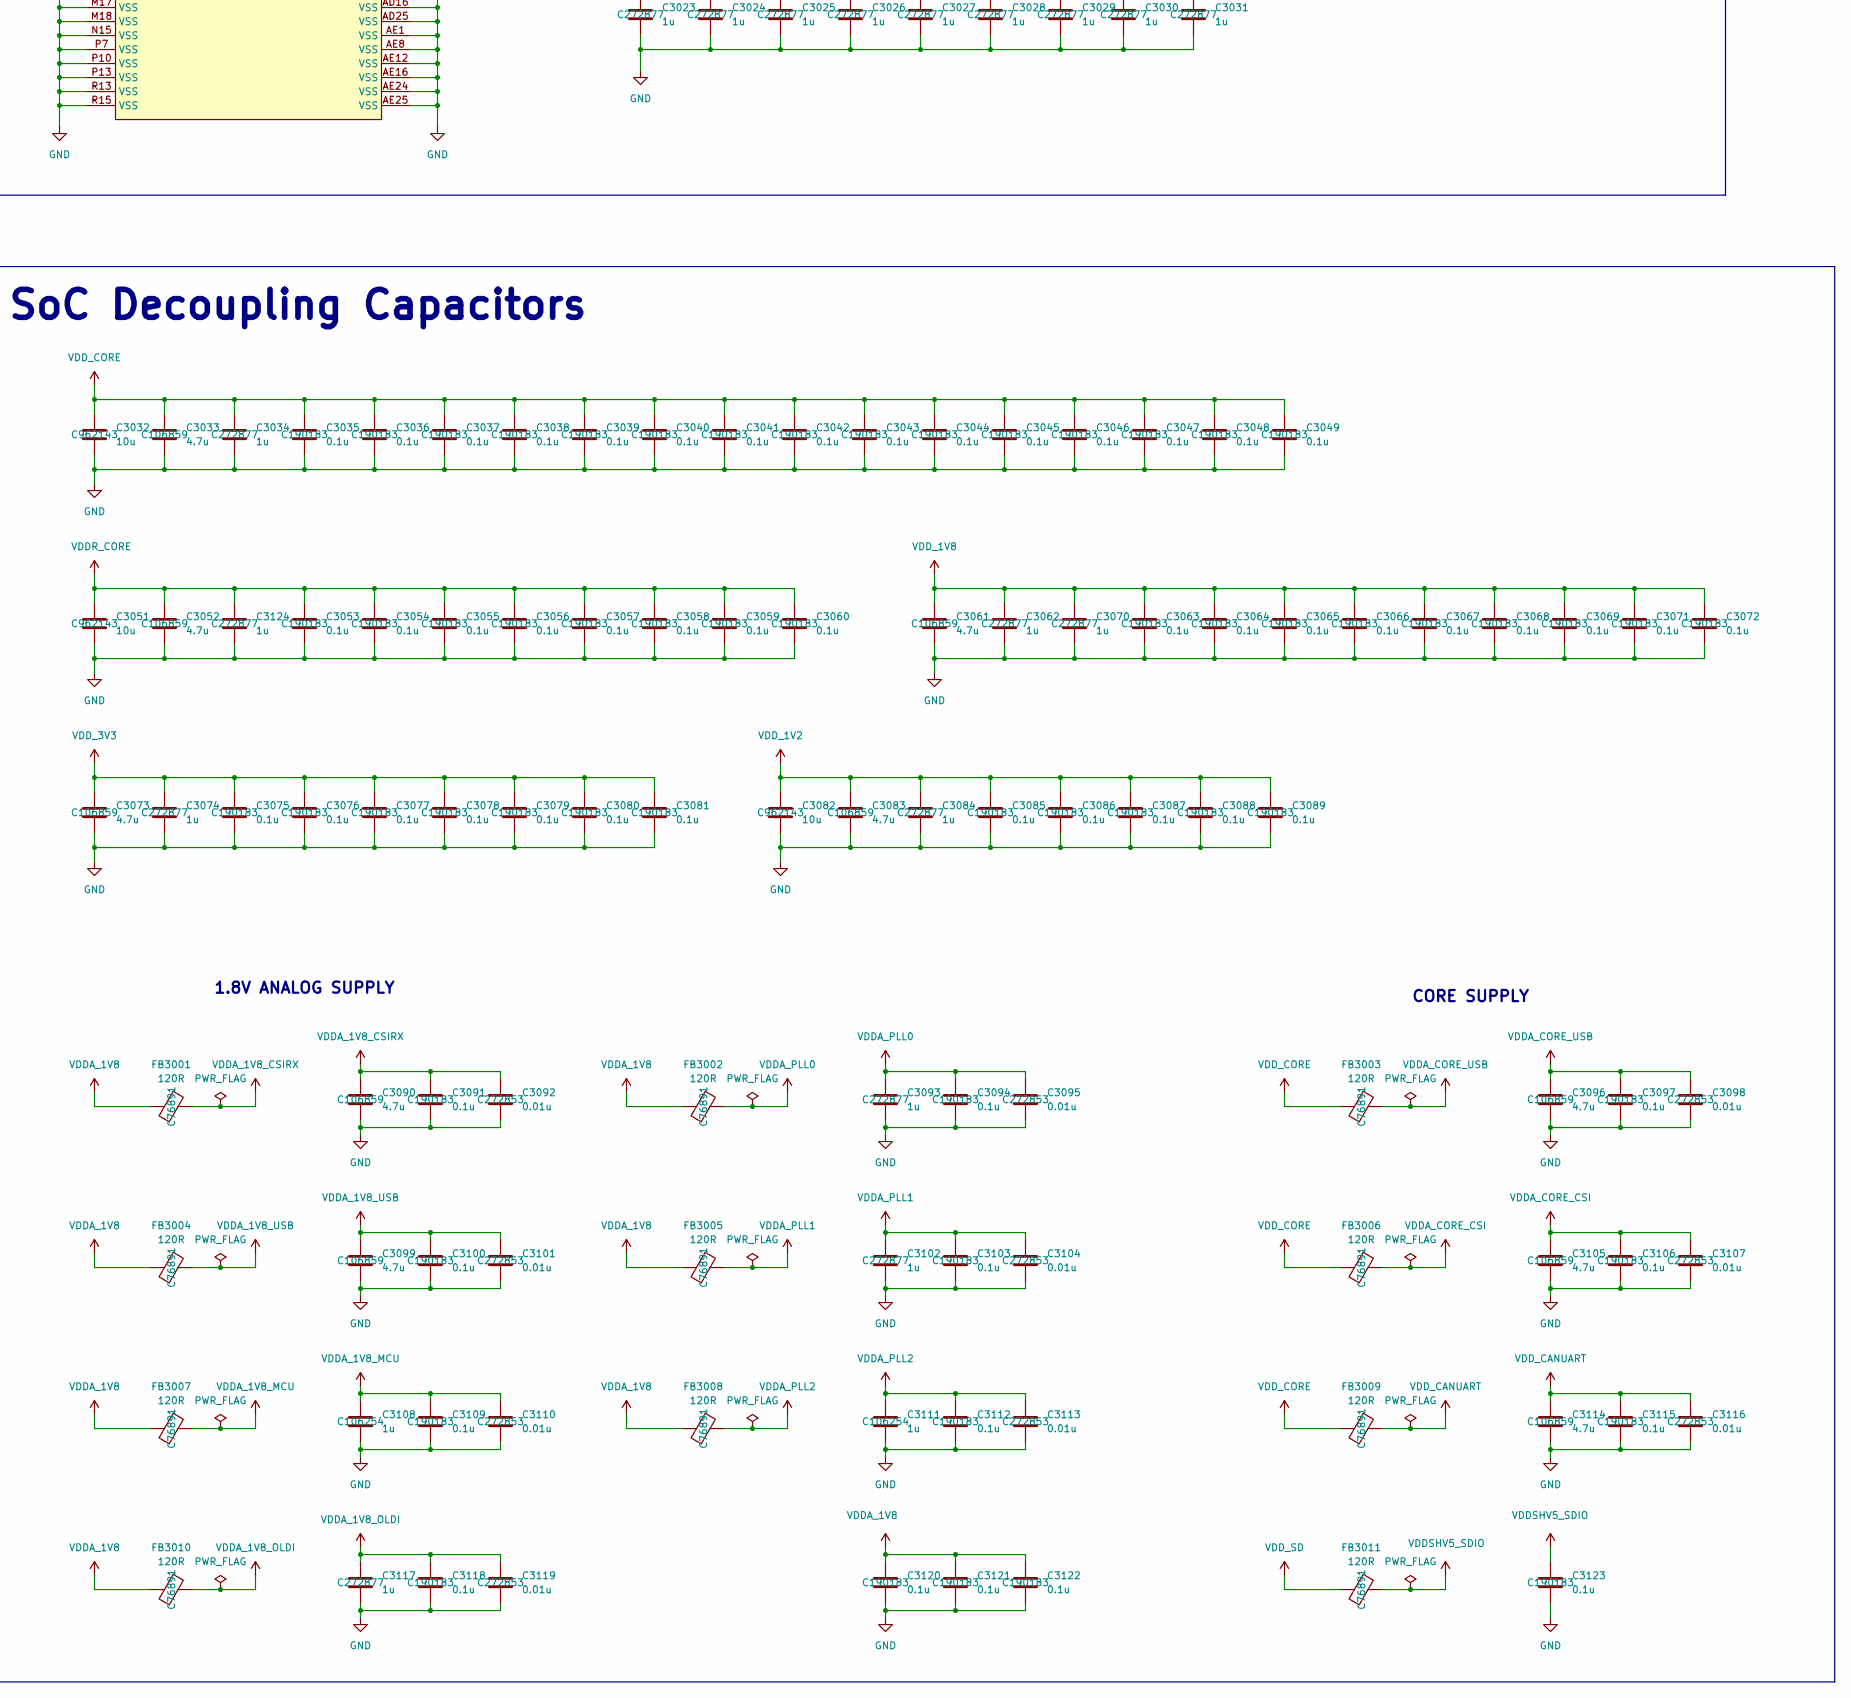
[picture p49: schematic powercircuitry.kicad_sch, part in row 2, column 2]

Parts:
C3001, C3004, C3007, C3019: 10u; C_0603_1608Metric; JLCPCB Part# C19702
C3002, C3005, C3008: 0.1u; C_0402_1005Metric; JLCPCB Part# C60474
C3003, C3006, C3009: 47u; C_0805_2012Metric; JLCPCB Part# C109461
C3010, C3011, C3013, C3014, C3015, C3016, C3017, C3018: 2.2u; C_0402_1005Metric; JLCPCB Part# C326606
C3012, C3033, C3052, C3061, C3073, C3083, C3090, C3096, C3099, C3105, C3114: 4.7u; C_0402_1005Metric; JLCPCB Part# C106859
C3020: 120p; C_0402_1005Metric; JLCPCB Part# C161146
C3021, C3022: 22u; C_0805_2012Metric; JLCPCB Part# C784585
C3023, C3024, C3025, C3026, C3027, C3028, C3029, C3030, C3031, C3034, C3062, C3070, C3074, C3084, C3093, C3102, C3117: 1u; C_0201_0603Metric; JLCPCB Part# C272877
C3032, C3051, C3082: 10u; C_0402_1005Metric; JLCPCB Part# C962143
C3035, C3036, C3037, C3038, C3039, C3040, C3041, C3042, C3043, C3044, C3045, C3046, C3047, C3048, C3049, C3053, C3054, C3055, C3056, C3057, C3058, C3059, C3060, C3063, C3064, C3065, C3066, C3067, C3068, C3069, C3071, C3072, C3075, C3076, C3077, C3078, C3079, C3080, C3081, C3085, C3086, C3087, C3088, C3089, C3091, C3094, C3097, C3100, C3103, C3106, C3109, C3112, C3115, C3118, C3120, C3121, C3122, C3123: 0.1u; C_0201_0603Metric; JLCPCB Part# C190183
C3092, C3095, C3098, C3101, C3104, C3107, C3110, C3113, C3116, C3119: 0.01u; C_0201_0603Metric; JLCPCB Part# C272853
C3108, C3111: 1u; C_0402_1005Metric; JLCPCB Part# C106254
C3124: 1u; 0201_Cap_Leonhart; JLCPCB Part# C272877
FB3001, FB3002, FB3003, FB3004, FB3005, FB3006, FB3007, FB3008, FB3009, FB3010, FB3011: 120R; R_0402_1005Metric; JLCPCB Part# C76891
L3001, L3002, L3003, L3004: 0.47u; L_1008_2520Metric; JLCPCB Part# C237552
R3001, R3014: 100k; R_0402_1005Metric; JLCPCB Part# C60491
R3002: 11k; R_0402_1005Metric; JLCPCB Part# C138063
R3003, R3004, R3005, R3006, R3007, R3009, R3010, R3011: 10k; R_0402_1005Metric; JLCPCB Part# C60490
R3008: R; R_0402_1005Metric; not fitted
R3012: 270k; R_0402_1005Metric; JLCPCB Part# C163475
R3013: 180k; R_0402_1005Metric; JLCPCB Part# C138046
TP3001, TP3002, TP3003, TP3004, TP3005, TP3006, TP3007, TP3008: TestPoint; TestPoint_Pad_1.0x1.0mm
U1002: AM6231ASGGGAALW; BGA425C50P25X25_1300X1300X89; JLCPCB Part# C7072556
U3001: TPS6521903RHBR; QFN50P500X500X100-33N-D; JLCPCB Part# C18716455
U3002: TLV62595DMQR; JLCPCB Part# C3189969

Connections:
/Power Circuitry [3]/CAP_VDDS0: C3023.1, U1002.H15 (CAP_VDDS0)
/Power Circuitry [3]/CAP_VDDS1: C3024.1, U1002.K18 (CAP_VDDS1)
/Power Circuitry [3]/CAP_VDDS2: C3025.1, U1002.W17 (CAP_VDDS2)
/Power Circuitry [3]/CAP_VDDS3: C3026.1, U1002.P19 (CAP_VDDS3)
/Power Circuitry [3]/CAP_VDDS4: C3027.1, U1002.U7 (CAP_VDDS4)
/Power Circuitry [3]/CAP_VDDS5: C3028.1, U1002.H17 (CAP_VDDS5)
/Power Circuitry [3]/CAP_VDDS6: C3029.1, U1002.J19 (CAP_VDDS6)
/Power Circuitry [3]/CAP_VDDS_CANUART: C3031.1, U1002.G9 (CAP_VDDS_CANUART)
/Power Circuitry [3]/CAP_VDDS_MCU: C3030.1, U1002.H11 (CAP_VDDS_MCU)
/Power Circuitry [3]/PMIC_B1_O: L3001.1, U3001.2 (LX_B1_1), U3001.3 (LX_B1_2)
/Power Circuitry [3]/PMIC_B2_O: L3002.1, U3001.29 (LX_B2)
/Power Circuitry [3]/PMIC_B3_O: L3003.1, U3001.27 (LX_B3)
/Power Circuitry [3]/VDD1P8: C3018.1, U3001.14 (VDD1P8)
/Power Circuitry [3]/VDDA_SYS_MON: R3001.2, R3002.1, U1002.H10 (VMON_ER_VSYS)
/Power Circuitry [3]/VDD_3V3_EN: R3011.2, U3001.17 (GPIO2), U3002.1 (EN)
/Power Circuitry [3]/VDD_3V3_FB: C3020.1, R3012.1, R3014.1, U3002.3 (FB)
/Power Circuitry [3]/VDD_3V3_PG: R3010.2, TP3008.1, U3002.2 (PG); also elsewhere on the board
/Power Circuitry [3]/VDD_3V3_SW: L3004.1, U3002.5 (SW)
/Power Circuitry [3]/VDD_SoC_VPP: R3008.2, R3009.1, U1002.J8 (VPP)
EXTINTn: R3004.2, U3001.11 (nINT); also elsewhere on the board
GND: C3001.2, C3002.2, C3003.2, C3004.2, C3005.2, C3006.2, C3007.2, C3008.2, C3009.2, C3010.2, C3011.2, C3012.2, C3013.2, C3014.2, C3015.2, C3016.2, C3017.2, C3018.2, C3019.2, C3021.2, C3022.2, C3023.2, C3024.2, C3025.2, C3026.2, C3027.2, C3028.2, C3029.2, C3030.2, C3031.2, C3032.2, C3033.2, C3034.2, C3035.2, C3036.2, C3037.2, C3038.2, C3039.2, C3040.2, C3041.2, C3042.2, C3043.2, C3044.2, C3045.2, C3046.2, C3047.2, C3048.2, C3049.2, C3051.2, C3052.2, C3053.2, C3054.2, C3055.2, C3056.2, C3057.2, C3058.2, C3059.2, C3060.2, C3061.2, C3062.2, C3063.2, C3064.2, C3065.2, C3066.2, C3067.2, C3068.2, C3069.2, C3070.2, C3071.2, C3072.2, C3073.2, C3074.2, C3075.2, C3076.2, C3077.2, C3078.2, C3079.2, C3080.2, C3081.2, C3082.2, C3083.2, C3084.2, C3085.2, C3086.2, C3087.2, C3088.2, C3089.2, C3090.2, C3091.2, C3092.2, C3093.2, C3094.2, C3095.2, C3096.2, C3097.2, C3098.2, C3099.2, C3100.2, C3101.2, C3102.2, C3103.2, C3104.2, C3105.2, C3106.2, C3107.2, C3108.2, C3109.2, C3110.2, C3111.2, C3112.2, C3113.2, C3114.2, C3115.2, C3116.2, C3117.2, C3118.2, C3119.2, C3120.2, C3121.2, C3122.2, C3123.2, C3124.2, R3002.2, R3009.2, R3014.2, U1002.A1 (VSS), U1002.A24 (VSS), U1002.A25 (VSS), U1002.AA11 (VSS), U1002.AB9 (VSS), U1002.AD1 (VSS), U1002.AD9 (VSS), U1002.AD12 (VSS), U1002.AD16 (VSS), U1002.AD25 (VSS), U1002.AE1 (VSS), U1002.AE8 (VSS), U1002.AE12 (VSS), U1002.AE16 (VSS), U1002.AE24 (VSS), U1002.AE25 (VSS), U1002.B25 (VSS), U1002.F13 (VSS), U1002.G13 (VSS), U1002.G19 (VSS), U1002.H13 (VSS), U1002.H16 (VSS), U1002.H18 (VSS), U1002.H20 (VSS), U1002.J7 (VSS), U1002.J13 (VSS), U1002.K7 (VSS), U1002.K13 (VSS), U1002.K15 (VSS), U1002.K19 (VSS), U1002.L20 (VSS), U1002.M7 (VSS), U1002.M8 (VSS), U1002.M10 (VSS), U1002.M12 (VSS), U1002.M13 (VSS), U1002.M17 (VSS), U1002.M18 (VSS), U1002.N15 (VSS), U1002.P7 (VSS), U1002.P10 (VSS), U1002.P13 (VSS), U1002.R13 (VSS), U1002.R15 (VSS), U1002.R18 (VSS), U1002.R20 (VSS), U1002.T8 (VSS), U1002.T13 (VSS), U1002.T14 (VSS), U1002.T16 (VSS), U1002.T17 (VSS), U1002.T18 (VSS), U1002.U8 (VSS), U1002.U19 (VSS), U1002.V9 (VSS), U1002.V10 (VSS), U1002.V11 (VSS), U1002.V13 (VSS), U1002.V16 (VSS), U1002.V18 (VSS), U1002.W7 (VSS), U1002.Y2 (VSS), U3001.15 (AGND), U3001.33 (Thermal_Pad), U3002.4 (GND); also elsewhere on the board
I2C0_SCL: U3001.10 (SCL); also elsewhere on the board
I2C0_SDA: U3001.9 (SDA); also elsewhere on the board
MCU_PORz: R3003.2, U3001.18 (nRSTOUT); also elsewhere on the board
unnamed: R3012.2, R3013.1
PMIC_LPM_EN0: R3005.2, U3001.31 (MODE_STBY); also elsewhere on the board
PWR_BTN: R3007.2, U3001.25 (EN/PB/VSENSE); also elsewhere on the board
RESETSTATz: U3001.28 (MODE_RESET); also elsewhere on the board
SD_VOLT_SEL: R3006.2, U3001.12 (VSEL_SD/VSEL_DDR); also elsewhere on the board
VDDA_1V8: C3015.1, C3120.1, C3121.1, C3122.1, FB3001.1, FB3002.1, FB3004.1, FB3005.1, FB3007.1, FB3008.1, FB3010.1, TP3006.1, U1002.G7 (VDDS_OSC0), U1002.G16 (VDDA_TEMP1), U1002.T9 (VDDA_TEMP0), U3001.21 (VLDO3); also elsewhere on the board
VDDA_1V8_CSIRX: C3090.1, C3091.1, C3092.1, FB3001.2, U1002.W14 (VDDA_1P8_CSIRX0)
VDDA_1V8_MCU: C3108.1, C3109.1, C3110.1, FB3007.2, U1002.L11 (VDDA_MCU)
VDDA_1V8_OLDI: C3117.1, C3118.1, C3119.1, FB3010.2, U1002.W9 (VDDA_1P8_OLDI0), U1002.W10 (VDDA_1P8_OLDI0)
VDDA_1V8_USB: C3099.1, C3100.1, C3101.1, FB3004.2, U1002.Y11 (VDDA_1P8_USB)
VDDA_CORE_CSI: C3105.1, C3106.1, C3107.1, FB3006.2, U1002.W13 (VDDA_CORE_CSIRX0)
VDDA_CORE_USB: C3096.1, C3097.1, C3098.1, FB3003.2, U1002.W12 (VDDA_CORE_USB)
VDDA_PLL0: C3093.1, C3094.1, C3095.1, FB3002.2, U1002.U11 (VDDA_PLL0)
VDDA_PLL1: C3102.1, C3103.1, C3104.1, FB3005.2, U1002.U15 (VDDA_PLL1)
VDDA_PLL2: C3111.1, C3112.1, C3113.1, FB3008.2, U1002.L14 (VDDA_PLL2)
VDDR_CORE: C3014.1, C3051.1, C3052.1, C3053.1, C3054.1, C3055.1, C3056.1, C3057.1, C3058.1, C3059.1, C3060.1, C3124.1, TP3005.1, U1002.J12 (VDDR_CORE), U1002.K16 (VDDR_CORE), U1002.N12 (VDDR_CORE), U1002.N14 (VDDR_CORE), U1002.P16 (VDDR_CORE), U1002.R12 (VDDR_CORE), U1002.T10 (VDDR_CORE), U1002.U14 (VDDR_CORE), U3001.19 (VLDO2); also elsewhere on the board
VDDSHV5_SDIO: C3123.1, FB3011.2, U1002.G17 (VDDSHV5)
VDD_1V2: C3009.1, C3082.1, C3083.1, C3084.1, C3085.1, C3086.1, C3087.1, C3088.1, C3089.1, L3003.2, TP3003.1, U1002.K9 (VDDS_DDR), U1002.L8 (VDDS_DDR), U1002.M9 (VDDS_DDR_C), U1002.P9 (VDDS_DDR), U1002.R8 (VDDS_DDR), U3001.24 (FB_B3); also elsewhere on the board
VDD_1V8: C3006.1, C3011.1, C3061.1, C3062.1, C3063.1, C3064.1, C3065.1, C3066.1, C3067.1, C3068.1, C3069.1, C3070.1, C3071.1, C3072.1, L3002.2, R3003.1, R3008.1, TP3002.1, U1002.F11 (VDDSHV_MCU), U1002.G10 (VMON_1P8_SOC), U1002.G12 (VDDSHV_MCU), U1002.J18 (VDDSHV6), U1002.N18 (VDDSHV3), U1002.P18 (VDDSHV3), U1002.T7 (VDDSHV4), U1002.T19 (VDDSHV3), U1002.U18 (VDDSHV3), U1002.W16 (VDDSHV2), U1002.W19 (VDDSHV2), U3001.20 (PVIN_LDO2), U3001.32 (FB_B2); also elsewhere on the board
VDD_2V5: C3016.1, TP3007.1, U3001.23 (VLDO4); also elsewhere on the board
VDD_3V3: C3010.1, C3012.1, C3020.2, C3021.1, C3022.1, C3073.1, C3074.1, C3075.1, C3076.1, C3077.1, C3078.1, C3079.1, C3080.1, C3081.1, L3004.2, R3004.1, R3005.1, R3006.1, R3013.2, U1002.F15 (VDDSHV0), U1002.G14 (VDDSHV0), U1002.H9 (VDDSHV_CANUART), U1002.K10 (VMON_3P3_SOC), U1002.L18 (VDDSHV1), U1002.M19 (VDDSHV1), U1002.Y13 (VDDA_3P3_USB), U3001.6 (PVIN_LDO1), U3001.22 (PVIN_LDO34); also elsewhere on the board
VDD_CANUART: C3114.1, C3115.1, C3116.1, FB3009.2, U1002.F8 (VDD_CANUART)
VDD_CORE: C3003.1, C3032.1, C3033.1, C3034.1, C3035.1, C3036.1, C3037.1, C3038.1, C3039.1, C3040.1, C3041.1, C3042.1, C3043.1, C3044.1, C3045.1, C3046.1, C3047.1, C3048.1, C3049.1, FB3003.1, FB3006.1, FB3009.1, L3001.2, TP3001.1, U1002.H8 (VDD_CORE), U1002.J11 (VDD_CORE), U1002.J14 (VDD_CORE), U1002.K17 (VDD_CORE), U1002.L12 (VDD_CORE), U1002.L15 (VDD_CORE), U1002.M16 (VDD_CORE), U1002.N8 (VDD_CORE), U1002.N11 (VDD_CORE), U1002.N13 (VDD_CORE), U1002.P17 (VDD_CORE), U1002.R11 (VDD_CORE), U1002.R14 (VDD_CORE), U1002.U12 (VDD_CORE), U1002.V8 (VDD_CORE), U1002.V15 (VDD_CORE), U1002.V17 (VDD_CORE), U3001.1 (FB_B1); also elsewhere on the board
VDD_SD: C3013.1, FB3011.1, TP3004.1, U3001.7 (VLDO1); also elsewhere on the board
VSYS_5V: C3001.1, C3002.1, C3004.1, C3005.1, C3007.1, C3008.1, C3017.1, C3019.1, R3001.1, R3007.1, R3010.1, R3011.1, U3001.4 (PVIN_B1_1), U3001.5 (PVIN_B1_1), U3001.13 (VSYS), U3001.26 (PVIN_B3), U3001.30 (PVIN_B2), U3002.6 (VIN); also elsewhere on the board

Notes on the sheet:
SoC Decoupling Capacitors
Power Management IC (PMIC)
SoC Power
VSYS_5V -> VDD_3V3
CORE SUPPLY
Power Circuitry
1.8V ANALOG SUPPLY
