Soft-Services/Leonhart/Leonhart.kicad_pcb

## KiCad design Leonhart.kicad_pcb (continued)

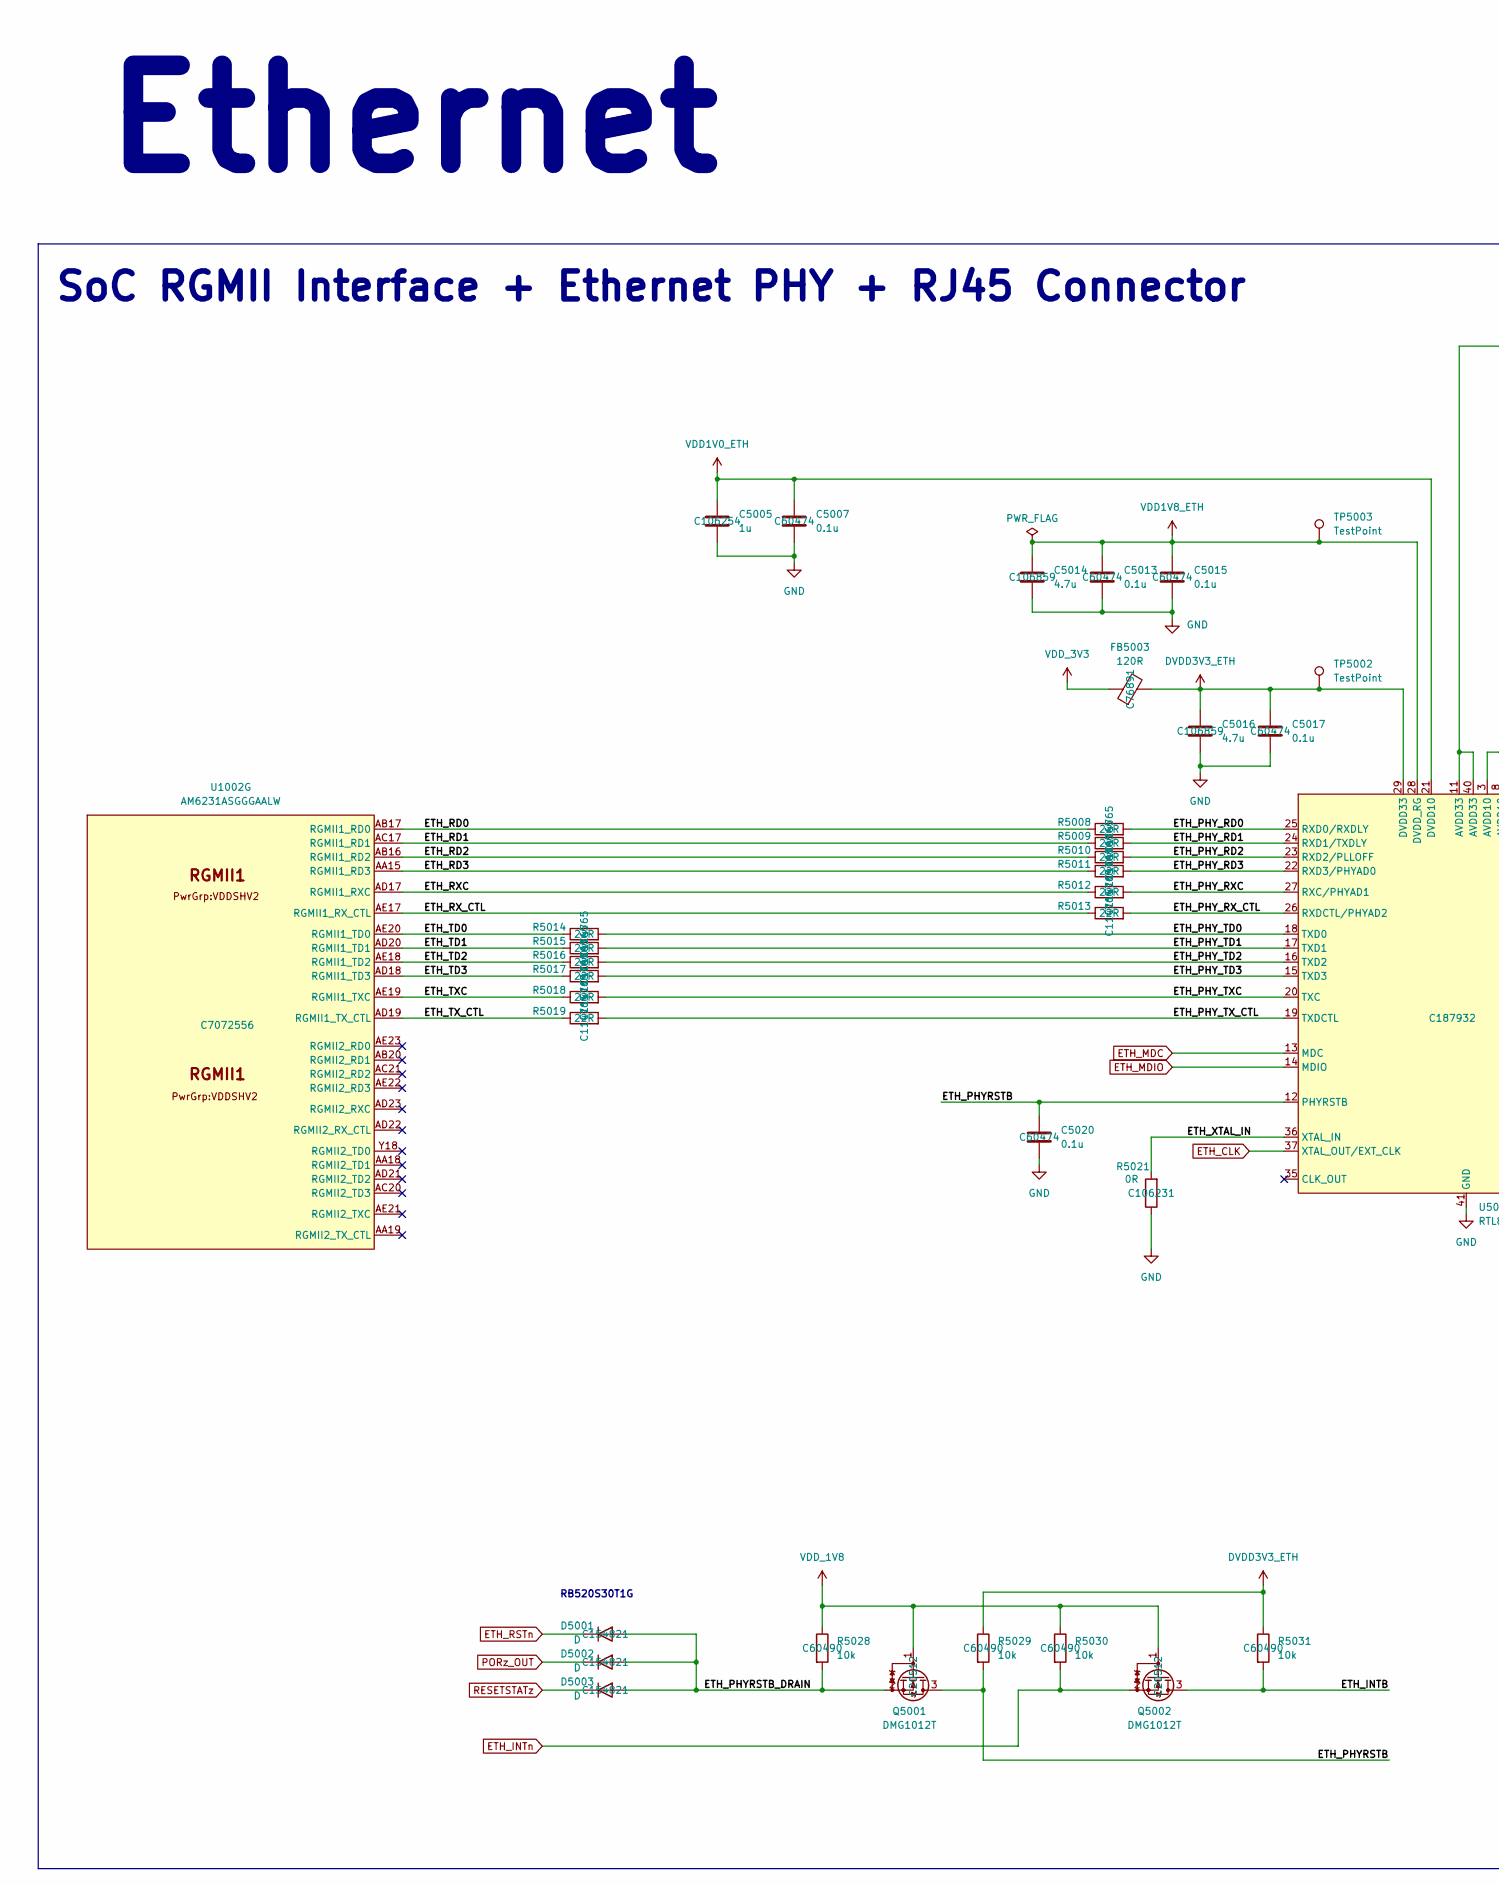
[picture p55: schematic ethernet.kicad_sch, part in row 1, column 1]

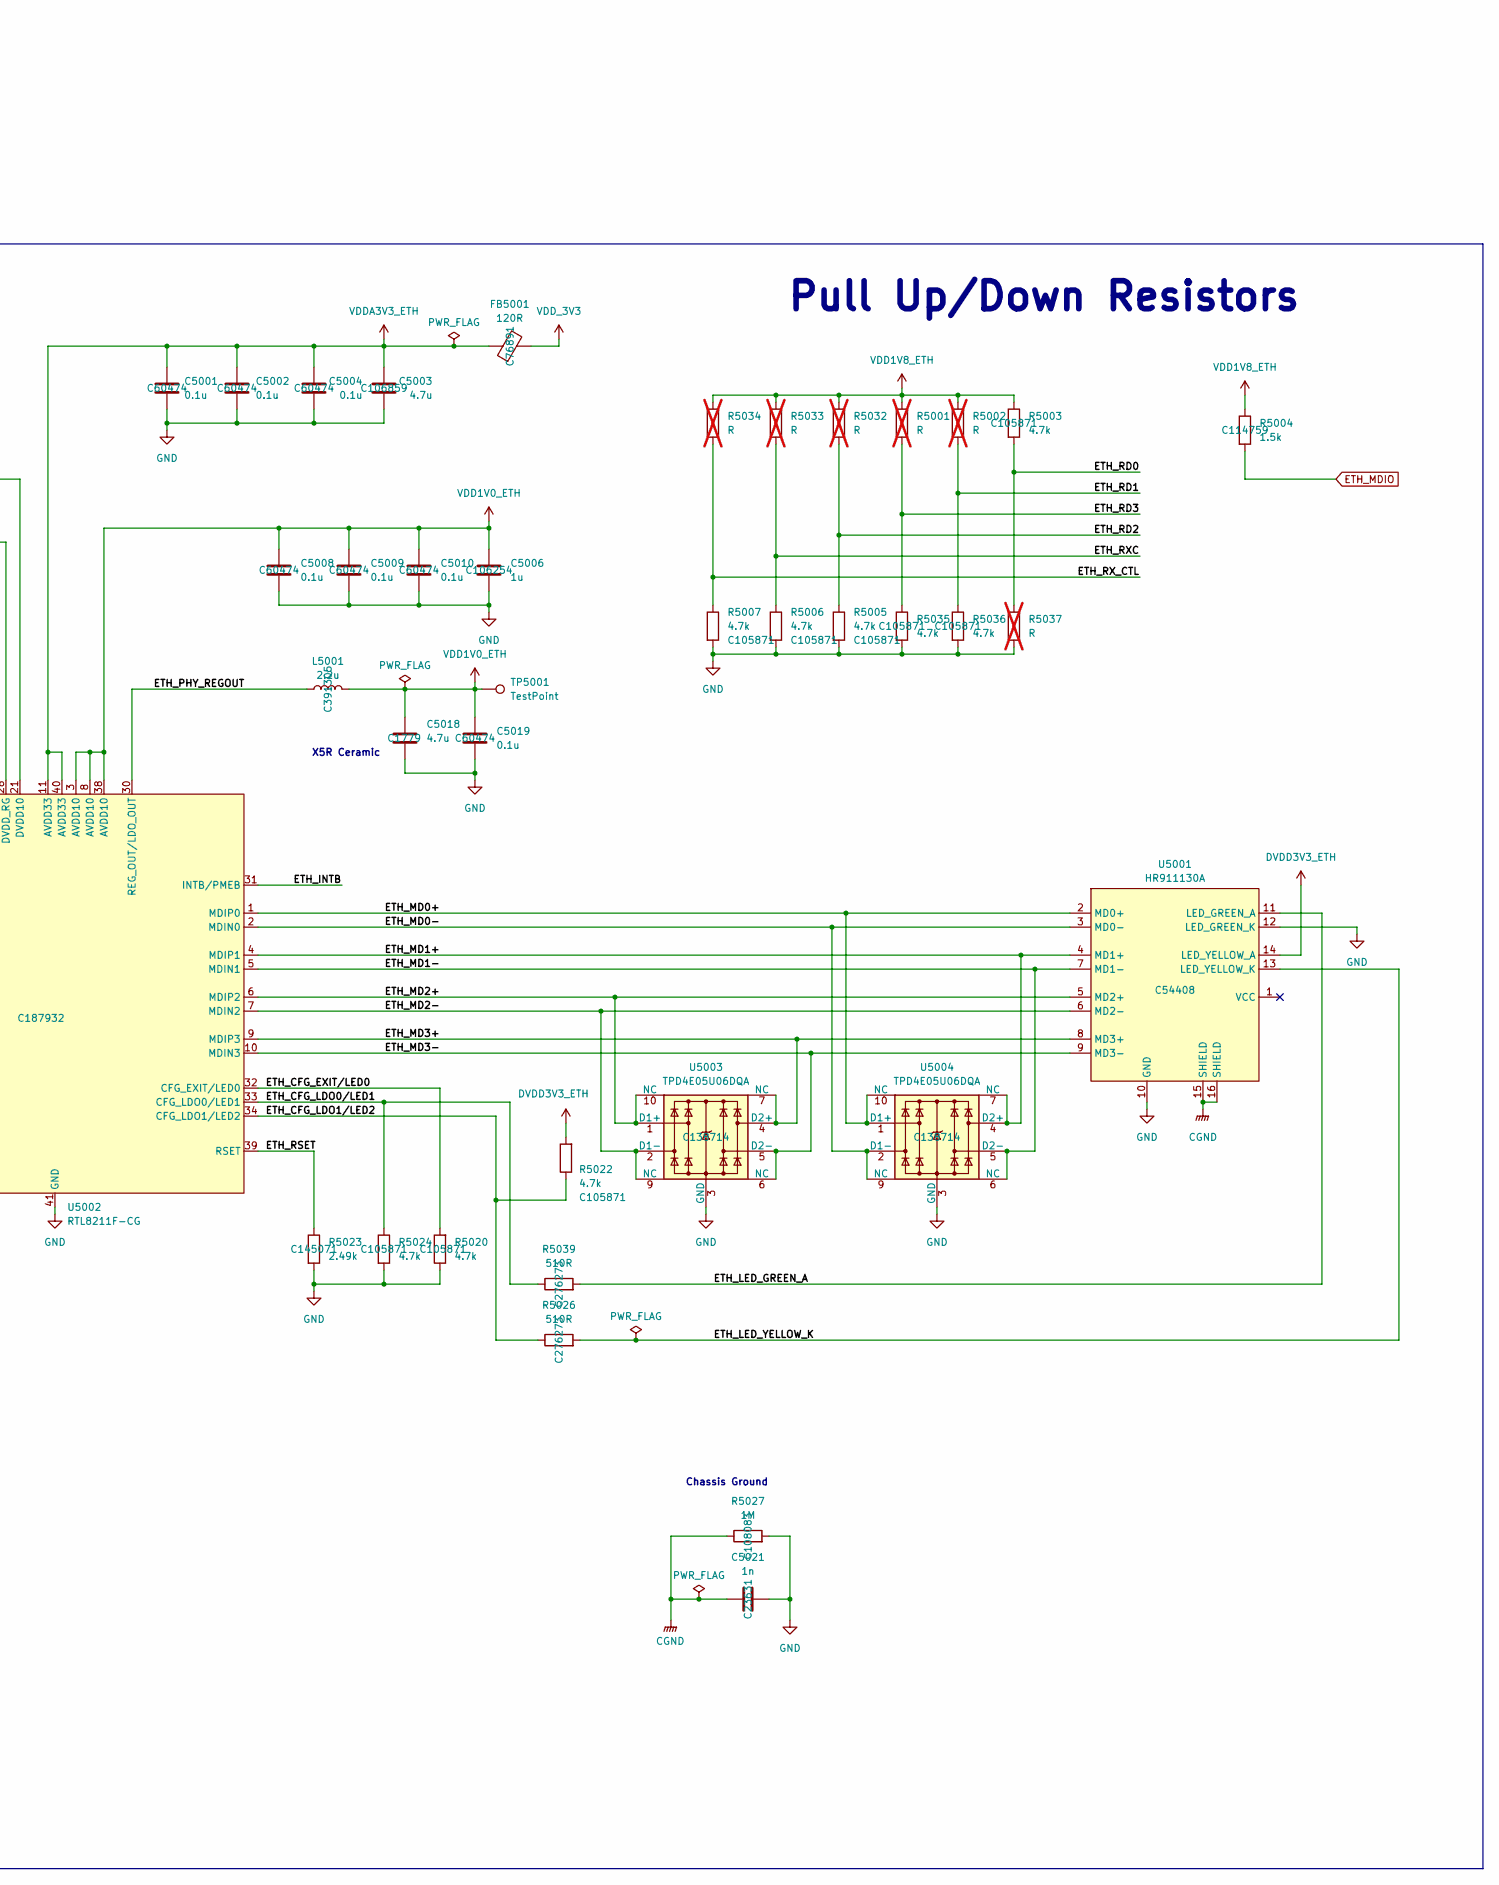
[picture p56: schematic ethernet.kicad_sch, part in row 1, column 2]

Parts:
C5001, C5002, C5004, C5007, C5008, C5009, C5010, C5013, C5015, C5017, C5019, C5020: 0.1u; C_0402_1005Metric; JLCPCB Part# C60474
C5003, C5014, C5016: 4.7u; C_0402_1005Metric; JLCPCB Part# C106859
C5005, C5006: 1u; C_0402_1005Metric; JLCPCB Part# C106254
C5018: 4.7u; C_0805_2012Metric; JLCPCB Part# C1779
C5021: 1n; C_1206_3216Metric; JLCPCB Part# C23631
D5001, D5002, D5003: D; D_SOD-523; JLCPCB Part# C154821
FB5001, FB5003: 120R; R_0402_1005Metric; JLCPCB Part# C76891
L5001: 2.2u; DFE2HCAH1R0MJ0L; JLCPCB Part# C391305
Q5001, Q5002: DMG1012T; SOT-523; JLCPCB Part# C20512
R5001, R5002, R5032, R5033, R5034, R5037: R; R_0402_1005Metric; not fitted
R5003, R5005, R5006, R5007, R5020, R5022, R5024, R5035, R5036: 4.7k; R_0402_1005Metric; JLCPCB Part# C105871
R5004: 1.5k; R_0402_1005Metric; JLCPCB Part# C114759
R5008, R5009, R5010, R5011, R5012, R5013, R5014, R5015, R5016, R5017, R5018, R5019: 22R; R_0402_1005Metric; JLCPCB Part# C114765
R5021: 0R; R_0402_1005Metric; JLCPCB Part# C106231
R5023: 2.49k; R_0402_1005Metric; JLCPCB Part# C145071
R5026, R5039: 510R; R_0402_1005Metric; JLCPCB Part# C276273
R5027: 1M; R_0402_1005Metric; JLCPCB Part# C108083
R5028, R5029, R5030, R5031: 10k; R_0402_1005Metric; JLCPCB Part# C60490
TP5001, TP5002, TP5003: TestPoint; TestPoint_Pad_1.0x1.0mm
U1002: AM6231ASGGGAALW; BGA425C50P25X25_1300X1300X89; JLCPCB Part# C7072556
U5001: HR911130A; JLCPCB Part# C54408
U5002: RTL8211F-CG; QFN-40-1EP_5x5mm_P0.4mm_EP3.6x3.6mm; JLCPCB Part# C187932
U5003, U5004: TPD4E05U06DQA; USON-10_2.5x1.0mm_P0.5mm; JLCPCB Part# C138714

Connections:
/Ethernet [5]/ETH_CFG_EXIT/LED0: R5020.2, U5002.32 (CFG_EXIT/LED0)
/Ethernet [5]/ETH_CFG_LDO0/LED1: R5024.1, R5039.1, U5002.33 (CFG_LDO0/LED1)
/Ethernet [5]/ETH_CFG_LDO1/LED2: R5022.1, R5026.1, U5002.34 (CFG_LDO1/LED2)
/Ethernet [5]/ETH_INTB: Q5002.3 (D), R5031.2, U5002.31 (INTB/PMEB)
/Ethernet [5]/ETH_LED_GREEN_A: R5039.2, U5001.11 (LED_GREEN_A)
/Ethernet [5]/ETH_LED_YELLOW_K: R5026.2, U5001.13 (LED_YELLOW_K)
/Ethernet [5]/ETH_MD0+: U5001.2 (MD0+), U5002.1 (MDIP0), U5004.1 (D1+), U5004.10 (NC)
/Ethernet [5]/ETH_MD0-: U5001.3 (MD0-), U5002.2 (MDIN0), U5004.2 (D1-), U5004.9 (NC)
/Ethernet [5]/ETH_MD1+: U5001.4 (MD1+), U5002.4 (MDIP1), U5004.4 (D2+), U5004.7 (NC)
/Ethernet [5]/ETH_MD1-: U5001.7 (MD1-), U5002.5 (MDIN1), U5004.5 (D2-), U5004.6 (NC)
/Ethernet [5]/ETH_MD2+: U5001.5 (MD2+), U5002.6 (MDIP2), U5003.1 (D1+), U5003.10 (NC)
/Ethernet [5]/ETH_MD2-: U5001.6 (MD2-), U5002.7 (MDIN2), U5003.2 (D1-), U5003.9 (NC)
/Ethernet [5]/ETH_MD3+: U5001.8 (MD3+), U5002.9 (MDIP3), U5003.4 (D2+), U5003.7 (NC)
/Ethernet [5]/ETH_MD3-: U5001.9 (MD3-), U5002.10 (MDIN3), U5003.5 (D2-), U5003.6 (NC)
/Ethernet [5]/ETH_PHYRSTB: C5020.1, Q5001.3 (D), R5029.2, U5002.12 (PHYRSTB)
/Ethernet [5]/ETH_PHYRSTB_DRAIN: D5001.2 (A), D5002.2 (A), D5003.2 (A), Q5001.2 (S), R5028.2
/Ethernet [5]/ETH_PHY_RD0: R5008.2, U5002.25 (RXD0/RXDLY)
/Ethernet [5]/ETH_PHY_RD1: R5009.2, U5002.24 (RXD1/TXDLY)
/Ethernet [5]/ETH_PHY_RD2: R5010.2, U5002.23 (RXD2/PLLOFF)
/Ethernet [5]/ETH_PHY_RD3: R5011.2, U5002.22 (RXD3/PHYAD0)
/Ethernet [5]/ETH_PHY_REGOUT: L5001.1, U5002.30 (REG_OUT/LDO_OUT)
/Ethernet [5]/ETH_PHY_RXC: R5012.2, U5002.27 (RXC/PHYAD1)
/Ethernet [5]/ETH_PHY_RX_CTL: R5013.2, U5002.26 (RXDCTL/PHYAD2)
/Ethernet [5]/ETH_PHY_TD0: R5014.2, U5002.18 (TXD0)
/Ethernet [5]/ETH_PHY_TD1: R5015.2, U5002.17 (TXD1)
/Ethernet [5]/ETH_PHY_TD2: R5016.2, U5002.16 (TXD2)
/Ethernet [5]/ETH_PHY_TD3: R5017.2, U5002.15 (TXD3)
/Ethernet [5]/ETH_PHY_TXC: R5018.2, U5002.20 (TXC)
/Ethernet [5]/ETH_PHY_TX_CTL: R5019.2, U5002.19 (TXDCTL)
/Ethernet [5]/ETH_RD0: R5003.2, R5008.1, R5037.1, U1002.AB17 (RGMII1_RD0)
/Ethernet [5]/ETH_RD1: R5002.2, R5009.1, R5036.1, U1002.AC17 (RGMII1_RD1)
/Ethernet [5]/ETH_RD2: R5005.1, R5010.1, R5032.2, U1002.AB16 (RGMII1_RD2)
/Ethernet [5]/ETH_RD3: R5001.2, R5011.1, R5035.1, U1002.AA15 (RGMII1_RD3)
/Ethernet [5]/ETH_RSET: R5023.1, U5002.39 (RSET)
/Ethernet [5]/ETH_RXC: R5006.1, R5012.1, R5033.2, U1002.AD17 (RGMII1_RXC)
/Ethernet [5]/ETH_RX_CTL: R5007.1, R5013.1, R5034.2, U1002.AE17 (RGMII1_RX_CTL)
/Ethernet [5]/ETH_TD0: R5014.1, U1002.AE20 (RGMII1_TD0)
/Ethernet [5]/ETH_TD1: R5015.1, U1002.AD20 (RGMII1_TD1)
/Ethernet [5]/ETH_TD2: R5016.1, U1002.AE18 (RGMII1_TD2)
/Ethernet [5]/ETH_TD3: R5017.1, U1002.AD18 (RGMII1_TD3)
/Ethernet [5]/ETH_TXC: R5018.1, U1002.AE19 (RGMII1_TXC)
/Ethernet [5]/ETH_TX_CTL: R5019.1, U1002.AD19 (RGMII1_TX_CTL)
/Ethernet [5]/ETH_XTAL_IN: R5021.2, U5002.36 (XTAL_IN)
CGND: C5021.1, R5027.1, U5001.15 (SHIELD), U5001.16 (SHIELD)
DVDD3V3_ETH: C5016.1, C5017.1, FB5003.2, R5022.2, R5029.1, R5031.1, TP5002.1, U5001.14 (LED_YELLOW_A), U5002.29 (DVDD33); also elsewhere on the board
ETH_CLK: U5002.37 (XTAL_OUT/EXT_CLK); also elsewhere on the board
ETH_INTn: Q5002.2 (S), R5030.2; also elsewhere on the board
ETH_MDC: U5002.13 (MDC); also elsewhere on the board
ETH_MDIO: R5004.2, U5002.14 (MDIO); also elsewhere on the board
ETH_RSTn: D5001.1 (K); also elsewhere on the board
GND: C5001.2, C5002.2, C5003.2, C5004.2, C5005.2, C5006.2, C5007.2, C5008.2, C5009.2, C5010.2, C5013.2, C5014.2, C5015.2, C5016.2, C5017.2, C5018.2, C5019.2, C5020.2, C5021.2, R5005.2, R5006.2, R5007.2, R5020.1, R5021.1, R5023.2, R5024.2, R5027.2, R5035.2, R5036.2, R5037.2, U5001.10 (GND), U5001.12 (LED_GREEN_K), U5002.41 (GND), U5003.3 (GND), U5003.8 (GND), U5004.3 (GND), U5004.8 (GND); also elsewhere on the board
PORz_OUT: D5002.1 (K); also elsewhere on the board
RESETSTATz: D5003.1 (K); also elsewhere on the board
VDD1V0_ETH: C5005.1, C5006.1, C5007.1, C5008.1, C5009.1, C5010.1, C5018.1, C5019.1, L5001.2, TP5001.1, U5002.3 (AVDD10), U5002.8 (AVDD10), U5002.21 (DVDD10), U5002.38 (AVDD10); also elsewhere on the board
VDD1V8_ETH: C5013.1, C5014.1, C5015.1, R5001.1, R5002.1, R5003.1, R5004.1, R5032.1, R5033.1, R5034.1, TP5003.1, U5002.28 (DVDD_RG); also elsewhere on the board
VDDA3V3_ETH: C5001.1, C5002.1, C5003.1, C5004.1, FB5001.1, U5002.11 (AVDD33), U5002.40 (AVDD33)
VDD_1V8: Q5001.1 (G), Q5002.1 (G), R5028.1, R5030.1; also elsewhere on the board
VDD_3V3: FB5001.2, FB5003.1; also elsewhere on the board

Notes on the sheet:
X5R Ceramic
Pull Up/Down Resistors
RB520S30T1G
SoC RGMII Interface + Ethernet PHY + RJ45 Connector
Chassis Ground
Ethernet

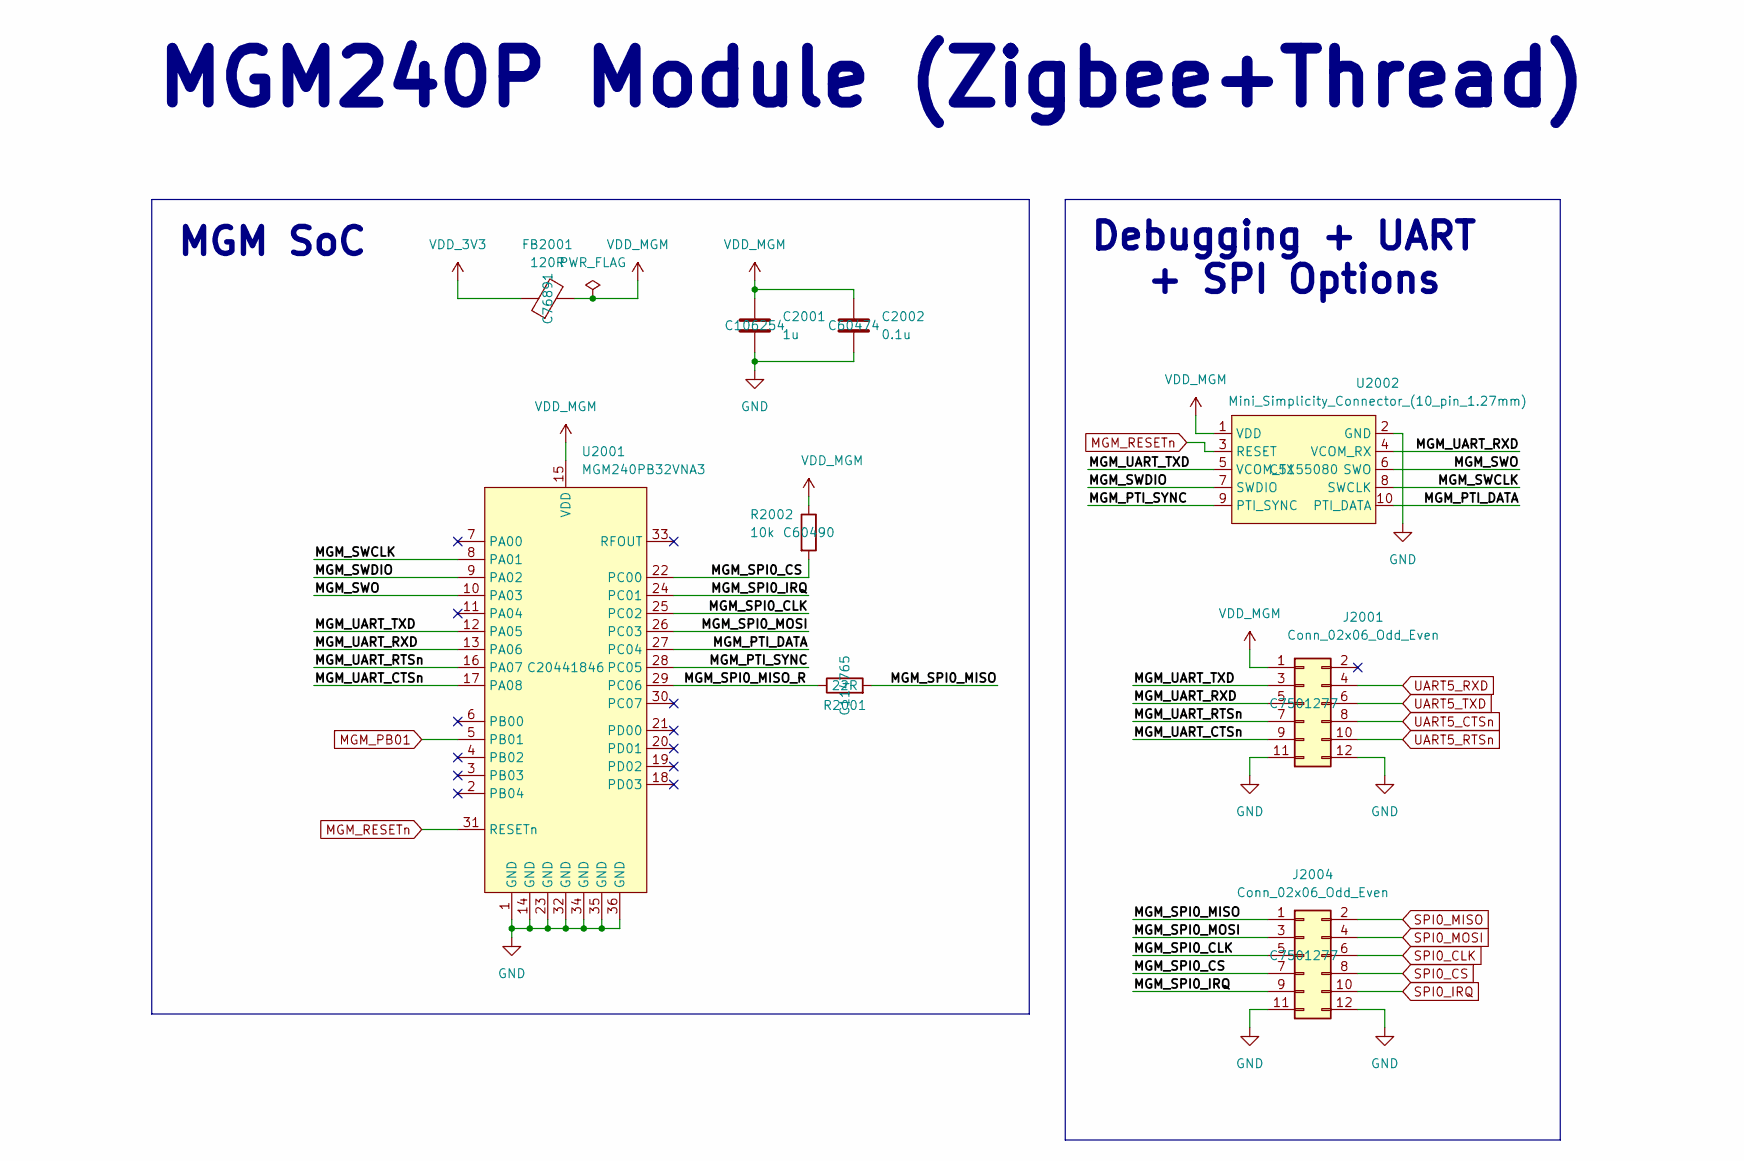
[picture p57: schematic Multi_Protocol_Radio.kicad_sch]

Parts:
C2001: 1u; C_0402_1005Metric; JLCPCB Part# C106254
C2002: 0.1u; C_0402_1005Metric; JLCPCB Part# C60474
FB2001: 120R; R_0402_1005Metric; JLCPCB Part# C76891
J2001, J2004: Conn_02x06_Odd_Even; PinHeader_2x06_P2.54mm_Vertical; JLCPCB Part# C7501277
R2001: 22R; R_0402_1005Metric; JLCPCB Part# C114765
R2002: 10k; R_0402_1005Metric; JLCPCB Part# C60490
U2001: MGM240PB32VNA3; JLCPCB Part# C20441846
U2002: Mini_Simplicity_Connector_(10_pin_1.27mm); FTSH10501LDVK; JLCPCB Part# C5155080

Connections:
/Zigbee+Thread [2]/MGM_PTI_DATA: U2001.27 (PC04), U2002.10 (PTI_DATA)
/Zigbee+Thread [2]/MGM_PTI_SYNC: U2001.28 (PC05), U2002.9 (PTI_SYNC)
/Zigbee+Thread [2]/MGM_SPI0_CLK: J2004.5, U2001.25 (PC02)
/Zigbee+Thread [2]/MGM_SPI0_CS: J2004.7, R2002.2, U2001.22 (PC00)
/Zigbee+Thread [2]/MGM_SPI0_IRQ: J2004.9, U2001.24 (PC01)
/Zigbee+Thread [2]/MGM_SPI0_MISO: J2004.1, R2001.2
/Zigbee+Thread [2]/MGM_SPI0_MISO_R: R2001.1, U2001.29 (PC06)
/Zigbee+Thread [2]/MGM_SPI0_MOSI: J2004.3, U2001.26 (PC03)
/Zigbee+Thread [2]/MGM_SWCLK: U2001.8 (PA01), U2002.8 (SWCLK)
/Zigbee+Thread [2]/MGM_SWDIO: U2001.9 (PA02), U2002.7 (SWDIO)
/Zigbee+Thread [2]/MGM_SWO: U2001.10 (PA03), U2002.6 (SWO)
/Zigbee+Thread [2]/MGM_UART_CTSn: J2001.9, U2001.17 (PA08)
/Zigbee+Thread [2]/MGM_UART_RTSn: J2001.7, U2001.16 (PA07)
/Zigbee+Thread [2]/MGM_UART_RXD: J2001.5, U2001.13 (PA06), U2002.4 (VCOM_RX)
/Zigbee+Thread [2]/MGM_UART_TXD: J2001.3, U2001.12 (PA05), U2002.5 (VCOM_TX)
GND: C2001.2, C2002.2, J2001.11, J2001.12, J2004.11, J2004.12, U2001.1 (GND), U2001.14 (GND), U2001.23 (GND), U2001.32 (GND), U2001.34 (GND), U2001.35 (GND), U2001.36 (GND), U2002.2 (GND); also elsewhere on the board
MGM_PB01: U2001.5 (PB01); also elsewhere on the board
MGM_RESETn: U2001.31 (RESETn), U2002.3 (RESET); also elsewhere on the board
SPI0_CLK: J2004.6; also elsewhere on the board
SPI0_CS: J2004.8; also elsewhere on the board
SPI0_IRQ: J2004.10; also elsewhere on the board
SPI0_MISO: J2004.2; also elsewhere on the board
SPI0_MOSI: J2004.4; also elsewhere on the board
UART5_CTSn: J2001.8; also elsewhere on the board
UART5_RTSn: J2001.10; also elsewhere on the board
UART5_RXD: J2001.4; also elsewhere on the board
UART5_TXD: J2001.6; also elsewhere on the board
VDD_3V3: FB2001.1; also elsewhere on the board
VDD_MGM: C2001.1, C2002.1, FB2001.2, J2001.1, R2002.1, U2001.15 (VDD), U2002.1 (VDD)

Notes on the sheet:
Debugging + UART + SPI Options
MGM SoC
MGM240P Module (Zigbee+Thread)
