Soft-Services/Leonhart/(commit log)

2025-08-04 Added KiCad files
    [AM6231ASGGGAALW.SchLib, AM6231ASGGGAALW.stp, AM6254ATCGHAALW.SchLib, AM6254ATCGHAALW.stp, BGA425C50P25X25_1300X1300X89.PcbLib, BGA96C80P9X16_750X1350X120.PcbLib, CC2652P1FRGZR.SchLib, CC2652P1FRGZR.stp]
2025-08-05 Finished splitting up AM6231 schematic symbol into groups
    [hostsystem.kicad_sch]
2025-08-05 Added more custom schematic symbols
    [EDI2CAP.CFG, QFN50P500X500X100-33N-D.PcbLib, TPS6521903RHBR.SchLib, TPS6521903RHBR.stp, chips.prt, hostsystem.kicad_sch, powercircuitry.kicad_sch, qfn50p500x500x100-33n-d.psm]
2025-08-06 Started power circuitry and added more custom schematic symbols
    [Leonhart.kicad_pcb, Leonhart.kicad_sch, memory.kicad_sch, miscellaneous.kicad_sch, powercircuitry.kicad_sch, usb.kicad_sch, zigbee.kicad_sch]
2025-08-06 Finished CC2652P schematic
    [usb.kicad_sch, zigbee.kicad_sch]
2025-08-06 Fixed schematic symbol errors
    [BGA96C80P9X16_750X1300X120.PcbLib, EDI2CAP.CFG, Leonhart.kicad_sch, MT40A1G16TB-062E_IT_F.SchLib, MT40A1G16TB-062E_IT_F.stp, bga96c80p9x16_750x1300x120.psm, chips.prt, ethernet.kicad_sch]
2025-08-07 Added some net labels and schematic routing
    [ethernet.kicad_sch, hostsystem.kicad_sch, memory.kicad_sch, powercircuitry.kicad_sch, thread.kicad_sch, untitled.kicad_sch, usb.kicad_sch, zigbee.kicad_sch]
2025-08-07 Worked on schematic for DDR4 memory
    [Leonhart.kicad_sch, memory.kicad_sch, powercircuitry.kicad_sch, thread.kicad_sch, usb.kicad_sch, zigbee.kicad_sch]
2025-08-08 Finished DDR4 schematic + relevant circuity and started SoC power
    [hostsystem.kicad_sch, memory.kicad_sch, powercircuitry.kicad_sch]
2025-08-08 Added USB A and USB C to the schematic
    [hostsystem.kicad_sch, powercircuitry.kicad_sch, usb.kicad_sch]
2025-08-09 Added micro SD card circuitry
    [Leonhart.kicad_sch, hostsystem.kicad_sch, usb_and_sd.kicad_sch]
2025-08-10 Added power pins and confirmed power source + some current requirements
    [powercircuitry.kicad_sch, usb_and_sd.kicad_sch]
2025-08-10 Fixed some power distribution and grouping
    [hostsystem.kicad_sch, powercircuitry.kicad_sch, usb_and_sd.kicad_sch]
2025-08-10 Simplified SoC blocks
    [hostsystem.kicad_sch]
2025-08-11 Finished CC2652P and UART2
    [powercircuitry.kicad_sch, usb_and_sd.kicad_sch, zigbee.kicad_sch]
2025-08-11 Small fixes
    [Leonhart.kicad_pcb, hostsystem.kicad_sch, usb_and_sd.kicad_sch]
2025-08-13 Fixed power issues
    [powercircuitry.kicad_sch, usb_and_sd.kicad_sch, zigbee.kicad_sch]
2025-08-14 Added some Ethernet circuitry and fixed schematic symbols
    [ethernet.kicad_sch, hostsystem.kicad_sch]
2025-08-18 Added eMMc
    [ethernet.kicad_sch, hostsystem.kicad_sch, usb_and_sd.kicad_sch, zigbee.kicad_sch]
2025-08-18 Added SoC and eMMC reset logic. Also SD power logic
    [hostsystem.kicad_sch, usb_and_sd.kicad_sch]
2025-08-18 Added thread symbol and circuitry
    [hostsystem.kicad_sch, thread.kicad_sch]
2025-08-19 Added power management for nRF52840
    [thread.kicad_sch]
2025-08-19 Added more thread circuitry
    [thread.kicad_sch, zigbee.kicad_sch]
2025-08-19 Almost finished Ethernet schematic
    [Leonhart.kicad_pcb, ethernet.kicad_sch]
2025-08-19 Added thread circuitry
    [hostsystem.kicad_sch, memory.kicad_sch, powercircuitry.kicad_sch, thread.kicad_sch]
2025-08-20 Fixed errors and added TI sysconfig file for AM6231
    [hostsystem.kicad_sch, usb_and_sd.kicad_sch, zigbee.kicad_sch]
2025-08-20 Added more to sysconfig and wkup domain on schematic
    [hostsystem.kicad_sch, usb_and_sd.kicad_sch, zigbee.kicad_sch]
2025-08-21 Fixed balun matching network for CC2652P
    [hostsystem.kicad_sch, zigbee.kicad_sch]
2025-08-21 Fixed net labels and added Ethernet reset digital logic. Also continued to update pinmux on TI sysconfig
    [ethernet.kicad_sch, hostsystem.kicad_sch, miscellaneous.kicad_sch, usb_and_sd.kicad_sch, zigbee.kicad_sch]
2025-08-21 Tidied up schematic
    [ethernet.kicad_sch, memory.kicad_sch, powercircuitry.kicad_sch, usb_and_sd.kicad_sch, zigbee.kicad_sch]
2025-08-22 Fixed small issues
    [hostsystem.kicad_sch, powercircuitry.kicad_sch, zigbee.kicad_sch]
2025-08-23 Added CC2652PSIP schematic symbol. Switching out for CC2652P for RF simplicity
    [hostsystem.kicad_sch, zigbee.kicad_sch]
2025-08-25 Fixed SoC power circuitry
    [Leonhart.kicad_pcb, ethernet.kicad_sch, hostsystem.kicad_sch, memory.kicad_sch, miscellaneous.kicad_sch, powercircuitry.kicad_sch, thread.kicad_sch, usb_and_sd.kicad_sch]
2025-08-25 Fixed pinmux issues that came with power issues
    [hostsystem.kicad_sch, powercircuitry.kicad_sch, usb_and_sd.kicad_sch]
2025-08-25 Finished SoC schematic
    [ethernet.kicad_sch, hostsystem.kicad_sch, usb_and_sd.kicad_sch, zigbee.kicad_sch]
2025-08-25 Finished overall schematic. Fixing errors and warnings from ERC
    [ethernet.kicad_sch, hostsystem.kicad_sch, memory.kicad_sch, miscellaneous.kicad_sch, thread.kicad_sch, usb_and_sd.kicad_sch]
2025-08-25 Fixed more errors and warnings
    [memory.kicad_sch]
2025-08-26 Fixed ERC errors and warnings (zero errors and zero warnings)
    [ethernet.kicad_sch, hostsystem.kicad_sch, memory.kicad_sch, powercircuitry.kicad_sch, thread.kicad_sch, usb_and_sd.kicad_sch, zigbee.kicad_sch]
2025-08-26 Labeled all nets and added some footprints
    [Leonhart.kicad_pcb, ethernet.kicad_sch, hostsystem.kicad_sch, memory.kicad_sch, powercircuitry.kicad_sch, thread.kicad_sch, usb_and_sd.kicad_sch, zigbee.kicad_sch]
2025-08-27 Added some footprints for important ICs
    [48037-0001.SchLib, 48037-0001.stp, 480370001.PcbLib, 480370001.psm, DMQ0006A.stp, EDI2CAP.CFG, FBGA153_13X11_5X0_8_KNT.step, HR911130A.PcbLib]
2025-08-27 Added more IC footprints
    [DMG1012T.SchLib, DMG1012T.stp, ECS-2520MV-250-BN-TR.SchLib, ECS-2520MV-250-BN-TR.stp, ECS2520MV250BNTR.PcbLib, EDI2CAP.CFG, Leonhart.kicad_pcb, SN74LVC2G241DCUR.SchLib]
2025-08-27 Added more footprints
    [EDI2CAP.CFG, Leonhart.kicad_pcb, SON65P200X200X80-7N.PcbLib, SOT95P280X145-6N.PcbLib, TPD3S014DBVR.SchLib, TPD3S014DBVR.stp, TVS0500DRVR.SchLib, TVS0500DRVR.stp]
2025-08-28 Added many more footprints
    [Download_STP_63011002124501 (rev1).stp, EDI2CAP.CFG, TF-15X15.SchLib, TF15X15.PcbLib, XRCGB25M000F3M00R0.stp, chips.prt, hostsystem.kicad_sch, tf15x15.psm]
2025-08-28 More footprints
    [EDI2CAP.CFG, FC-135R_32.7680KA-A3.stp, FC-135_32.7680KA-A3.stp, Leonhart.kicad_pcb, XRCGB32M000F1H01R0.stp, chips.prt, fc135327680kaa3.psm, fc135r327680kaa3.psm]
2025-08-28 Finished IC and crystal footprints
    [ABS07-32.768KHZ-9-T.stp, EDI2CAP.CFG, Leonhart.kicad_pcb, abs07.psm, chips.prt, hostsystem.kicad_sch, thread.kicad_sch]
2025-08-29 Double checked power, ddr4, USB, MMC and added bootstrap. Also added buttons and added pinmuxing in sysconfig
    [Leonhart.kicad_pcb, hostsystem.kicad_sch, memory.kicad_sch, miscellaneous.kicad_sch, powercircuitry.kicad_sch, usb_and_sd.kicad_sch]
2025-08-29 Small changes
    [Leonhart.kicad_pcb]
2025-08-29 Added header pins for UART5
    [Leonhart.kicad_pcb, hostsystem.kicad_sch, zigbee.kicad_sch]
2025-08-29 Added board stackup JLC08081H-1080
    [Leonhart.kicad_pcb]
2025-08-30 Added capcitor footprints
    [Leonhart.kicad_pcb, memory.kicad_sch, powercircuitry.kicad_sch]
2025-08-31 Added almost all passive component footprints
    [Leonhart.kicad_pcb, ethernet.kicad_sch, hostsystem.kicad_sch, memory.kicad_sch, miscellaneous.kicad_sch, powercircuitry.kicad_sch, thread.kicad_sch, usb_and_sd.kicad_sch]
2025-08-31 Added net classes and colouring on layout editor
    [Leonhart.kicad_pcb, memory.kicad_sch, usb_and_sd.kicad_sch]
2025-09-01 Fixed footprint issues to comply with manufacturer constraints
    [Leonhart.kicad_pcb, hostsystem.kicad_sch, usb_and_sd.kicad_sch]
2025-09-01 More layout
    [Leonhart.kicad_pcb]
2025-09-02 Did fanout for SoC BGA power balls
    [Leonhart.kicad_pcb, powercircuitry.kicad_sch]
2025-09-03 Added necessary nRF52840 SPI logic circuitry and GPIOs. Also added pinmux
    [Leonhart.kicad_pcb, hostsystem.kicad_sch, thread.kicad_sch]
2025-09-03 More SoC fanout
    [Leonhart.kicad_pcb, ethernet.kicad_sch, hostsystem.kicad_sch, thread.kicad_sch]
2025-09-04 Fixed SoC power fanout with updated constraints and stackup
    [Leonhart.kicad_pcb]
2025-09-05 Did byte swapping on DDR for easier routing
    [Leonhart.kicad_pcb, memory.kicad_sch]
2025-09-06 Completed DDR4 dogbone fanout
    [Leonhart.kicad_pcb]
2025-09-08 Fixed stackup started DDR4 routing
    [Leonhart.kicad_pcb]
2025-09-08 Fixed DDR data routing
    [Leonhart.kicad_pcb]
2025-09-08 Did more DDR4 routing
    [Leonhart.kicad_pcb]
2025-09-10 Did more SoC power decoupling routing
    [Leonhart.kicad_pcb]
2025-09-10 More SoC power cap placement
    [Leonhart.kicad_pcb]
2025-09-11 Cleaned up schematic
    [Leonhart.kicad_pcb, hostsystem.kicad_sch, memory.kicad_sch, zigbee.kicad_sch]
2025-09-13 Restarted SoC power decoupling based on manufacturer capabilities
    [Leonhart.kicad_pcb, ethernet.kicad_sch, hostsystem.kicad_sch, powercircuitry.kicad_sch, thread.kicad_sch, usb_and_sd.kicad_sch]
2025-09-15 Added more SoC powering decaps
    [Leonhart.kicad_pcb]
2025-09-16 More SoC power decap placement
    [Leonhart.kicad_pcb]
2025-09-16 Fixed SoC power decap placements
    [Leonhart.kicad_pcb]
2025-09-16 More capacitor placement
    [Leonhart.kicad_pcb]
2025-09-16 More SoC decaps
    [Leonhart.kicad_pcb, hostsystem.kicad_sch, powercircuitry.kicad_sch]
2025-09-17 Solved PDN capacitor placement space issue
    [Leonhart.kicad_pcb]
2025-09-17 Almost finished SoC PDN
    [Leonhart.kicad_pcb]
2025-09-18 Finished SoC PDN
    [Leonhart.kicad_pcb]
2025-09-18 Placed all DDR4 escape vias
    [Leonhart.kicad_pcb]
2025-09-18 Finished DDR4 address geometry
    [Leonhart.kicad_pcb]
2025-09-19 Finished connecting DDR4 pins and adding return vias
    [Leonhart.kicad_pcb]
2025-09-20 Changed DDR4 decoupling capacitors and placed them
    [Leonhart.kicad_pcb, memory.kicad_sch]
2025-09-21 Shuffled SoC decaps around for priority caps. Fixed DRC violations
    [Leonhart.kicad_pcb]
2025-09-21 Added DDR4 device power decoupling and prepped byte lane traces for length matching
    [Leonhart.kicad_pcb]
2025-09-21 Small clearance changes
    [Leonhart.kicad_pcb]
2025-09-22 Started DDR4 length matching
    [Leonhart.kicad_pcb]
2025-09-22 Matched DDR4 byte 0
    [Leonhart.kicad_pcb]
2025-09-22 More DDR length matching
    [Leonhart.kicad_pcb]
2025-09-24 Length matched other DDR byte but might readjust for SI improvement
    [Leonhart.kicad_pcb]
2025-09-25 More DDR4 tuning
    [Leonhart.kicad_pcb]
2025-09-25 Placed all DDR4 external circuitry and added power puddles
    [Leonhart.kicad_pcb, memory.kicad_sch]
2025-09-26 Started DDR address length matching
    [Leonhart.kicad_pcb]
2025-09-29 Finished DDR4 length matching
    [Leonhart.kicad_pcb, memory.kicad_sch]
2025-09-29 Added clock buffor for CMOS 25MHz osc. Used for both SoC and Ethernet with optional SoC crystal still placed
    [EDI2CAP.CFG, LMK1C1102PWR.SchLib, LMK1C1102PWR.stp, SOP65P640X120-8N.PcbLib, chips.prt, hostsystem.kicad_sch, sop65p640x120-8n.psm]
2025-09-30 Started USB and OSC routing
    [902-131A1011D10100.SchLib, 902-131A1011D10100.stp, 902131A1011D10100.PcbLib, 902131a1011d10100.psm, CMUSB661022B.stp, ECS-2520MV-250-CN-TR.SchLib, ECS-2520MV-250-CN-TR.stp, ECS2520MV250CNTR.PcbLib]
2025-10-01 Continued Ethernet routing
    [EDI2CAP.CFG, Leonhart.kicad_pcb, QFN50P200X200X65-13N-D.PcbLib, SKYA21003.SchLib, SKYA21003.stp, chips.prt, ethernet.kicad_sch, qfn50p200x200x65-13n-d.psm]
2025-10-01 More Ethernet routing. Also replaced SMA connectors with RF switch and plan to use microstrip antenna
    [Leonhart.kicad_pcb]
2025-10-02 Routed 5V -> 3.3V Buck converter and started PMIC routing and power planes
    [Leonhart.kicad_pcb, powercircuitry.kicad_sch, usb_and_sd.kicad_sch]
2025-10-02 Added RJ45 connector chassis ground plane and vias
    [Leonhart.kicad_pcb, ethernet.kicad_sch, usb_and_sd.kicad_sch]
2025-10-02 Routed out PMIC
    [Leonhart.kicad_pcb, powercircuitry.kicad_sch]
2025-10-03 Routed most of Ethernet PHY and RGMII
    [Leonhart.kicad_pcb, ethernet.kicad_sch, hostsystem.kicad_sch]
2025-10-04 Polished and partly routed eMMC
    [Leonhart.kicad_pcb, usb_and_sd.kicad_sch, zigbee.kicad_sch]
2025-10-04 Continued routing Ethernet PHY external circuitry. Added ESD protection diode arrays to Ethernet
    [Leonhart.kicad_pcb, ethernet.kicad_sch, usb_and_sd.kicad_sch]
2025-10-05 Length tuned Ethernet lines
    [Leonhart.kicad_pcb, ethernet.kicad_sch, usb_and_sd.kicad_sch]
2025-10-06 Routed eMMC and finished length tuning RGMII
    [ethernet.kicad_sch, usb_and_sd.kicad_sch]
2025-10-06 Continued PDN routing
    [hostsystem.kicad_sch, powercircuitry.kicad_sch]
2025-10-06 Improved clock layout and clock PDN
    [ethernet.kicad_sch, hostsystem.kicad_sch, powercircuitry.kicad_sch, usb_and_sd.kicad_sch]
2025-10-08 Finished USB A routing. Started micro sd routing
    [usb_and_sd.kicad_sch, zigbee.kicad_sch]
2025-10-08 More micro SD routing
    [EDI2CAP.CFG, TPD1E1B04DPYR.stp, chips.prt, tpd1e1b04dpyr.psm, usb_and_sd.kicad_sch]
2025-10-09 Switched out CC2652P and nRF52840 for MGM240P to run Zigbee and Thread
    [EDI2CAP.CFG, Leonhart.kicad_sch, MGM240PB32VNA3.PcbLib, MGM240PB32VNA3.SchLib, MGM240PB32VNA3.stp, Multi_Protocol_Radio.kicad_sch, chips.prt, hostsystem.kicad_sch]
2025-10-09 Added new radio schematic
    [Leonhart.kicad_sch, Multi_Protocol_Radio.kicad_sch, ethernet.kicad_sch, hostsystem.kicad_sch, memory.kicad_sch, miscellaneous.kicad_sch, powercircuitry.kicad_sch, usb_and_sd.kicad_sch]
2025-10-16 Added UART and SPI header pins for MGM240P module options
    [Multi_Protocol_Radio.kicad_sch, hostsystem.kicad_sch]
2025-10-16 Moved around subsections and rerouted RGMII, USBA and USBC
    [Multi_Protocol_Radio.kicad_sch, hostsystem.kicad_sch]
2025-10-18 Laid out and routed boot mode resistors
    [Multi_Protocol_Radio.kicad_sch, hostsystem.kicad_sch, usb_and_sd.kicad_sch]
2025-10-20 Routed SD load switch and system control traces
    [Multi_Protocol_Radio.kicad_sch, hostsystem.kicad_sch]
2025-10-25 Routed JTAG and UART header pins for SoC
    [Leonhart.kicad_sch, ethernet.kicad_sch, hostsystem.kicad_sch, usb_and_sd.kicad_sch]
2025-10-26 Routed all SPI traces. Also started fixing default trace widths to round metric numbers
    [hostsystem.kicad_sch]
2025-10-27 Added and routed Micro SD load switch
    [hostsystem.kicad_sch, usb_and_sd.kicad_sch]
2025-10-27 Placed more pull up resistors and diodes
    [hostsystem.kicad_sch]
2025-10-28 Routed I2C traces and some reset traces
2025-10-28 Started PDN power islands routing
2025-10-29 Created VDDR_CORE and VDD_1V2 power islands
2025-10-30 Placed ferrite beads and relevant decoupling caps for analog 1.8V rails
    [1825910-6.SchLib, 1825910-6.stp, 18259106.PcbLib, 18259106.psm, EDI2CAP.CFG, chips.prt, miscellaneous.kicad_sch]
2025-10-31 Routed more analog and core power rails
2025-11-02 More PDN power planes
    [hostsystem.kicad_sch]
2025-11-03 Routed more power planes for VDD_3V3 and VDD_1V8
2025-11-08 Routed all power rails to AM6231 SoC
    [powercircuitry.kicad_sch]
2025-11-09 More PDN routing
    [hostsystem.kicad_sch]
2025-11-10 Routed more power (for VDD_1V8)
2025-11-12 Routed buttons and added some return vias. Fixed power distribution problem
2025-11-13 Placed bulk decaps for VDDR_CORE and VDD_CORE
    [hostsystem.kicad_sch, powercircuitry.kicad_sch]
2025-11-14 Added ground copper fill to L1 and L8
    [Multi_Protocol_Radio.kicad_sch]
2025-12-22 Removed DDR4 L5 traces
2025-12-26 Small schematic naming change and added silkscreen to buttons and header pins
    [Leonhart.kicad_sch, ethernet.kicad_sch]
2025-12-26 GND stitching vias placed around board edge. DDR4 L2 needs to be redone
2026-01-02 Small clean up
    [ethernet.kicad_sch, memory.kicad_sch, miscellaneous.kicad_sch, powercircuitry.kicad_sch, usb_and_sd.kicad_sch]
2026-01-03 Fixed more errors and connected VDDR_CORE bulk caps to main rail
2026-01-03 Fixed DRC errors and added extra ground vias in PMIC area
2026-01-05 Fixed a few errors and created test gerber files
    [Leonhart-B_Cu.gbr, Leonhart-B_Mask.gbr, Leonhart-B_Paste.gbr, Leonhart-B_Silkscreen.gbr, Leonhart-Edge_Cuts.gbr, Leonhart-F_Cu.gbr, Leonhart-F_Mask.gbr, Leonhart-F_Paste.gbr]
2026-01-07 Added ground vias to USB and PMIC+Buck sections
2026-01-10 Fixed all warnings and almost all errors in DRC
    [ethernet.kicad_sch, powercircuitry.kicad_sch, usb_and_sd.kicad_sch]
2026-01-12 Added status LEDs for SoC power, MGM240P power, and for GPIO0_70
    [Multi_Protocol_Radio.kicad_sch, c-1825910-6-c-3d.stp, hostsystem.kicad_sch, miscellaneous.kicad_sch, usb_and_sd.kicad_sch]
2026-01-13 Fixed silkscreen of footprint for DDR4 module
2026-01-14 Chose better inductor for ethernet phy 1.0V rail
    [CVH201610A-2R2M.stp, ethernet.kicad_sch]
2026-02-06 Added JLCPCB part numbers for some caps
    [Multi_Protocol_Radio.kicad_sch, ethernet.kicad_sch, hostsystem.kicad_sch, memory.kicad_sch, miscellaneous.kicad_sch, powercircuitry.kicad_sch, usb_and_sd.kicad_sch]
2026-02-06 All capacitors and crystals added to BOM. 150u cap for USB A changed to tantalum and rerouted
    [ethernet.kicad_sch, hostsystem.kicad_sch, memory.kicad_sch, powercircuitry.kicad_sch, usb_and_sd.kicad_sch]
2026-02-06 Added diode and tvs diode JLC part numbers to BOM. Also fixed tvs diode footprint
    [ethernet.kicad_sch, hostsystem.kicad_sch, usb_and_sd.kicad_sch]
2026-02-06 All JLC part numbers added to BOM except LEDs
    [Multi_Protocol_Radio.kicad_sch, ethernet.kicad_sch, hostsystem.kicad_sch, memory.kicad_sch, miscellaneous.kicad_sch, powercircuitry.kicad_sch, usb_and_sd.kicad_sch]
2026-02-07 Finished adding JLC part numbers to BOM
    [miscellaneous.kicad_sch]
2026-02-08 Changed ethernet phy strap options and added DNP options for debugging
    [Leonhart-B_Cu.gbr, Leonhart-B_Mask.gbr, Leonhart-B_Paste.gbr, Leonhart-B_Silkscreen.gbr, Leonhart-Edge_Cuts.gbr, Leonhart-F_Cu.gbr, Leonhart-F_Mask.gbr, Leonhart-F_Paste.gbr]
2026-02-15 Small DDR4 cleanup
    [Multi_Protocol_Radio.kicad_sch, ethernet.kicad_sch, miscellaneous.kicad_sch]
2026-02-16 Added testpoints for MCU_RESETz and RESET_REQZ
    [hostsystem.kicad_sch]
2026-02-16 Small fixes and added some return ground vias
2026-02-19 Added extra decoupling capacitors and pull up resistor to MGM240P module
    [Multi_Protocol_Radio.kicad_sch]
2026-02-23 Updated JLC part numbers
    [Multi_Protocol_Radio.kicad_sch, hostsystem.kicad_sch]
2026-02-23 Fixed RESETSTATz shorted to ground
    [Leonhart-B_Cu.gbr, Leonhart-B_Mask.gbr, Leonhart-B_Paste.gbr, Leonhart-B_Silkscreen.gbr, Leonhart-Edge_Cuts.gbr, Leonhart-F_Cu.gbr, Leonhart-F_Mask.gbr, Leonhart-F_Paste.gbr]
2026-02-23 Created trial component placement, assembly, and BOM files
    [Leonhart-B_Cu.gbr, Leonhart-B_Mask.gbr, Leonhart-B_Paste.gbr, Leonhart-B_Silkscreen.gbr, Leonhart-Edge_Cuts.gbr, Leonhart-F_Cu.gbr, Leonhart-F_Mask.gbr, Leonhart-F_Paste.gbr]
2026-02-25 Ordered Rev A
    [Leonhart-B_Cu.gbr, Leonhart-B_Mask.gbr, Leonhart-B_Paste.gbr, Leonhart-B_Silkscreen.gbr, Leonhart-Edge_Cuts.gbr, Leonhart-F_Cu.gbr, Leonhart-F_Mask.gbr, Leonhart-F_Paste.gbr]
2026-02-27 Canceled order, fixed microSD socket footprint issue. Fixed eMMC trace width issue
    [EDI2CAP.CFG, MEM2052-00-195-00-A.SchLib, MEM2052-00-195-00-A.stp, MEM20520019500A.PcbLib, chips.prt, mem20520019500a.psm, usb_and_sd.kicad_sch]
2026-04-02 Update README with Linux boot and power issues
    Added note about Linux boot issues and power sequencing.
2026-05-01 Placed and routed new UART and SPI headers, routed out correct MGM240P pinout, routed out Mini Simplicity 10 pin connector, swapped legless TC2050 footprint for legged version. Need to reroute SoC JT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
    [Leonhart.kicad_pcb, Multi_Protocol_Radio.kicad_sch, hostsystem.kicad_sch]
2026-05-01 More SoC JTAG routing, improved PMIC signal integrity
    [Leonhart.kicad_pcb]
2026-05-01 Finished routing JTAG
    [Leonhart.kicad_pcb, powercircuitry.kicad_sch]
2026-05-02 Remove BOM file patterns from .gitignore
    Remove exported BOM files from .gitignore.
2026-05-02 Finished routing Rev B and fixed all errors and warnings
    [Leonhart.kicad_pcb, powercircuitry.kicad_sch]
2026-05-02 Updated gitignore
    [Leonhart-all-postest.csv, Leonhart-all-postnew.csv, Leonhart.csv, LeonhartBOM.csv, LeonhartBOMnew.csv, LeonhartBOMtest.csv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]
2026-05-02 Cleaned up BOM folder
    [LeonhartBOM.csv, LeonhartBOMnew.csv, LeonhartBOMtest.csv]
2026-05-03 Fixed Ethernet schematic and strapping. Also fixed some decoupling routing
    [Leonhart.kicad_pcb, ethernet.kicad_sch]
2026-05-03 Finished Ethernet routing
    [Leonhart.kicad_pcb, ethernet.kicad_sch]
2026-05-04 Fixed Ethernet inductor and capacitor regulator parts. Cleaned up Ethernet routing
    [DFE252012P-2R2M=P2.SchLib, DFE252012P-2R2M=P2.stp, DFE2HCAH1R0MJ0L.PcbLib, EDI2CAP.CFG, Leonhart.kicad_pcb, chips.prt, ethernet.kicad_sch, powercircuitry.kicad_sch]
2026-05-05 Finished Rev B. More double checking needed. Ordered Silicon Labs J Link debugger for MGM240P
    [Leonhart.kicad_pcb]
2026-05-05 Small silkscreen changes
    [Leonhart.kicad_pcb]
2026-05-05 Ordered Rev B
    [EDI2CAP.CFG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]
2026-05-19 Added Rev B working progress update to readme
    [Leonhart.kicad_pcb, hostsystem.kicad_sch]
2026-06-02 Updated README.md file with new working Thread network chain progress
