Soft-Services/Leonhart/(notices)

Notices in the files:
Components/LIB_MEM2052-00-195-00-A/MEM2052-00-195-00-A/3D/MEM2052-00-195-00-A.stp:
author */ ('License CC BY-ND 4.0'),
